skipzone/Illumicone/README.md

# Illumicone
Illumicone interactive LED art project

www.illumicone.com
