skipzone/Illumicone/hardware/4StringDriver/4StringDriver_board.png

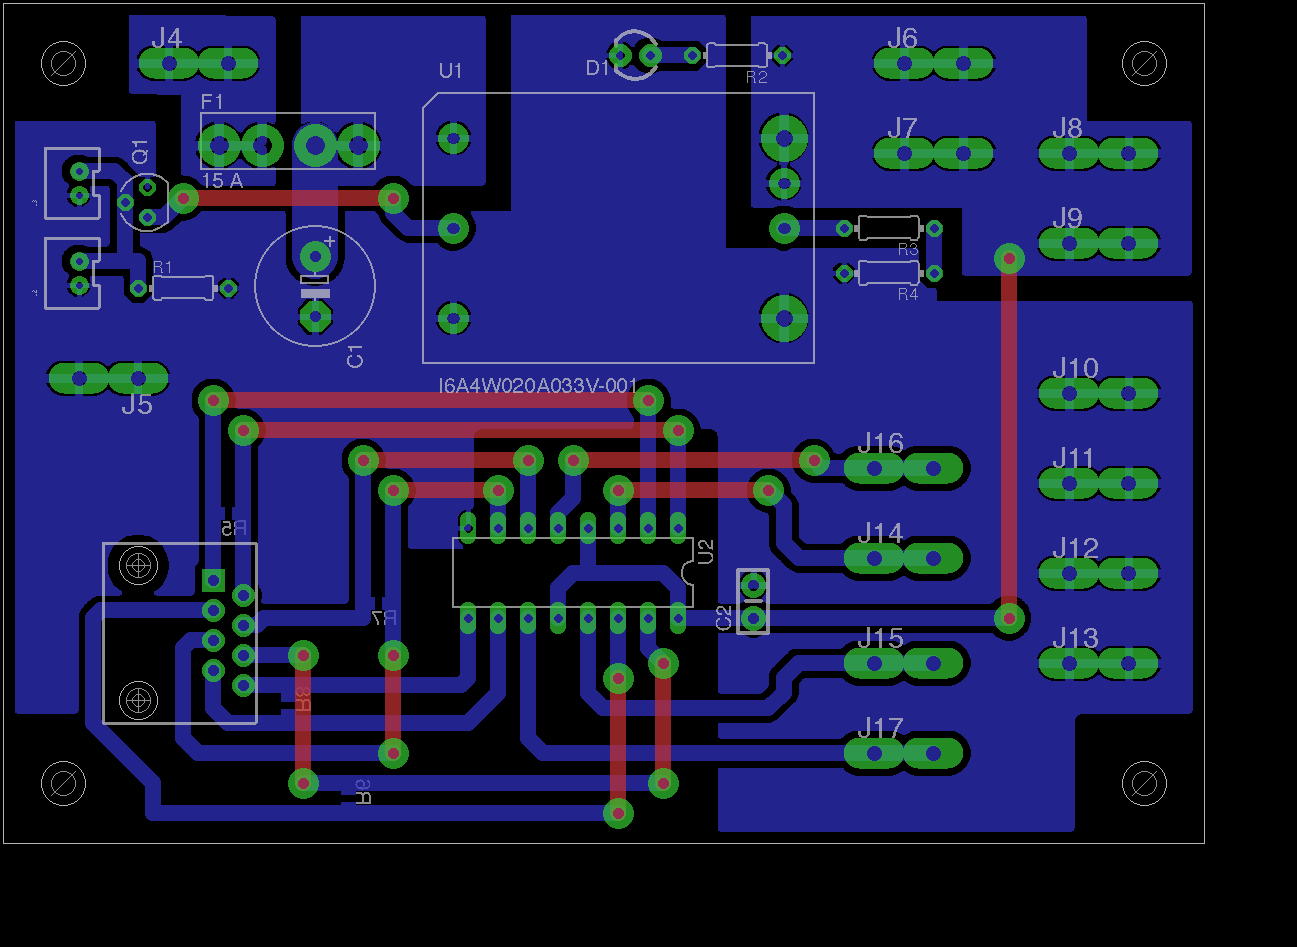
hardware/4StringDriver/4StringDriver_board.png
