skipzone/Illumicone/hardware/4StringDriver/4StringDriver_schematic.png

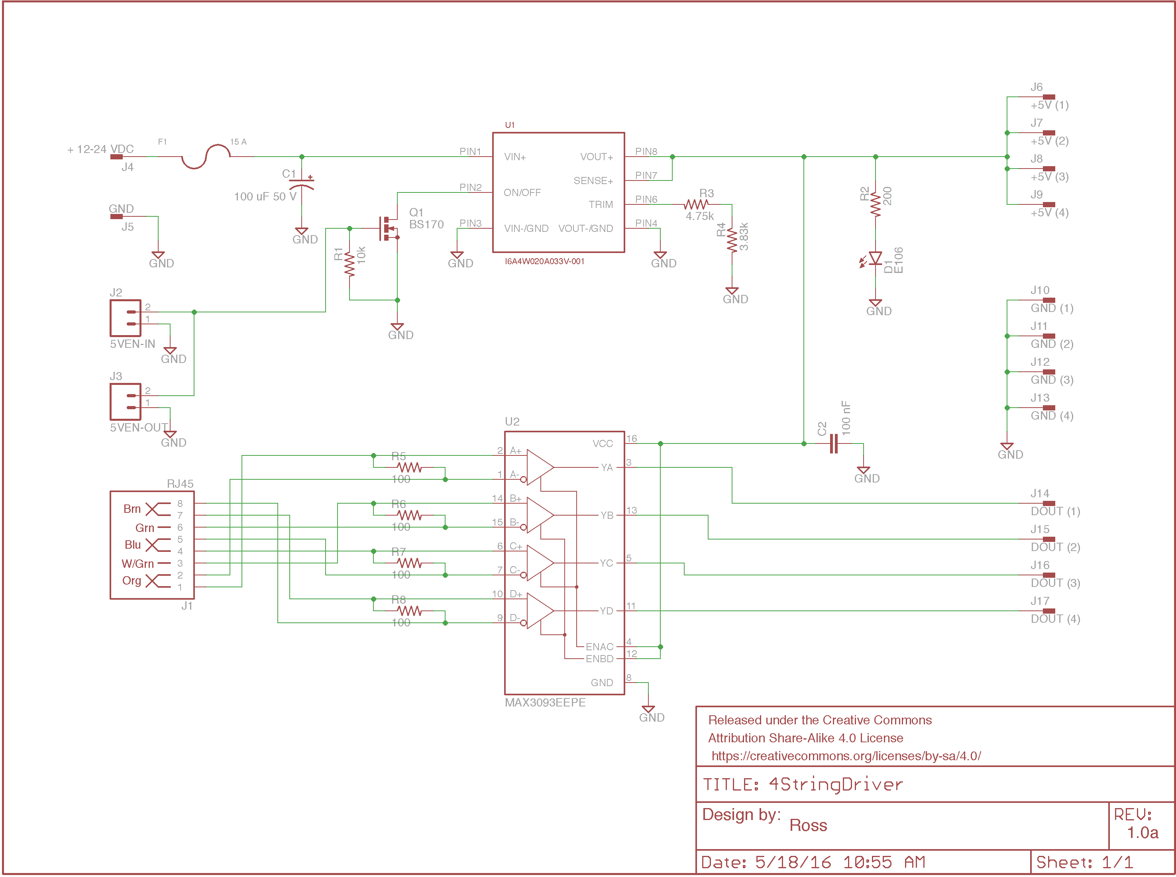
hardware/4StringDriver/4StringDriver_schematic.png
