skipzone/Illumicone/hardware/WidgetArduinoProMiniBreakout/WidgetArduinoProMiniBreakout - etch pattern.png

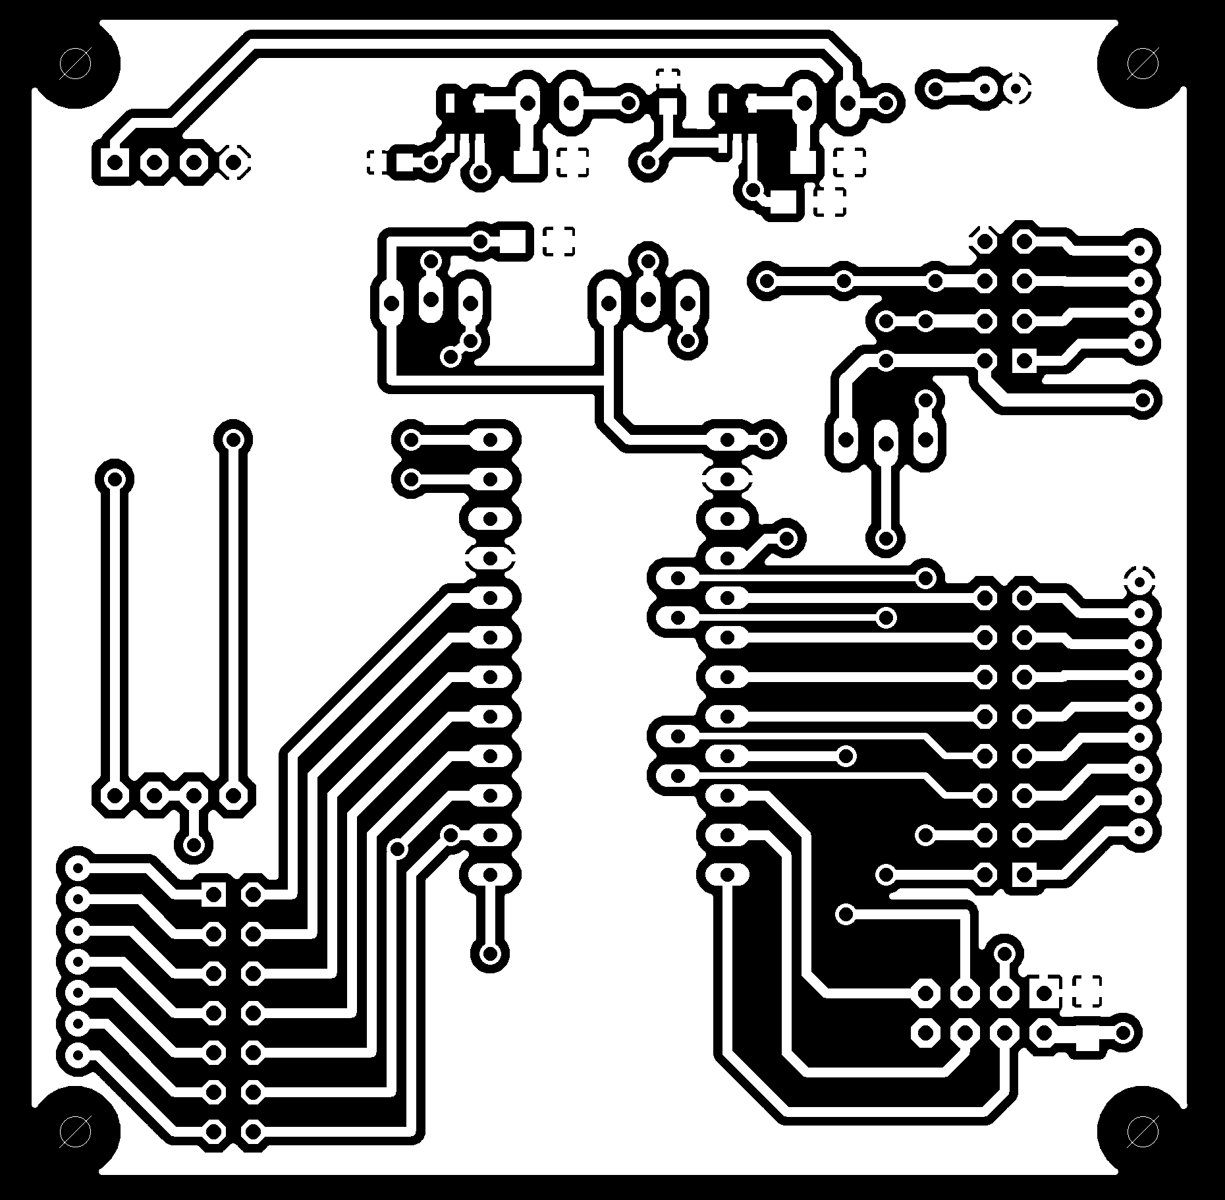
hardware/WidgetArduinoProMiniBreakout/WidgetArduinoProMiniBreakout - etch pattern.png
