skipzone/Illumicone/doc/Illumicone high-level architecture diagram.pdf

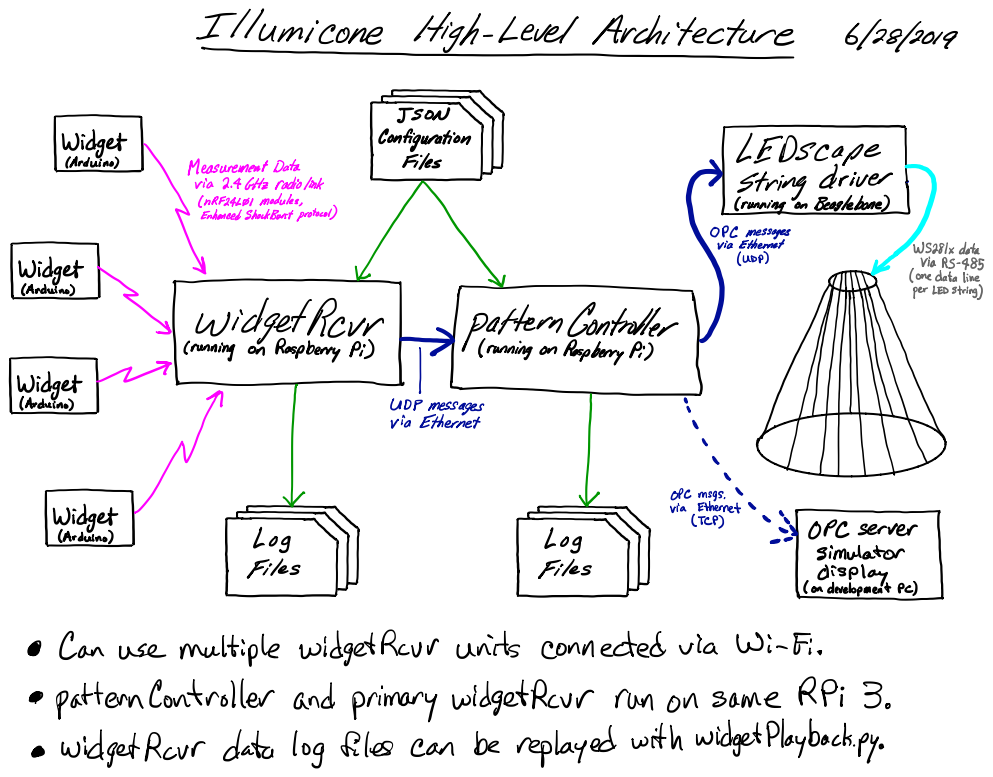
[picture p4: page 1]
' t o job; dos A; ¥÷*÷ / Eir: 3 EE; EEE; ooo; OEto I Is; oses s t; I Ets ¥.

Join J E I e or \ EEEE -
