skipzone/Illumicone/hardware/4StringDriver/4StringDriver_boardTopView.pdf

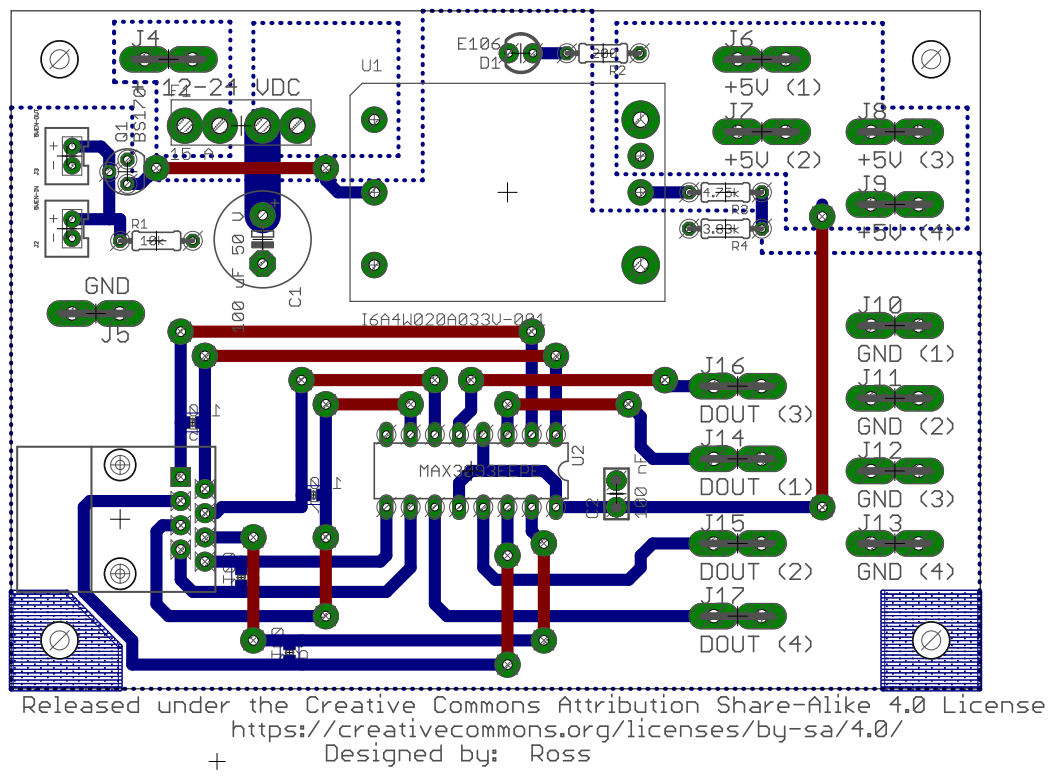
[picture p5: page 1]
