skipzone/Illumicone/hardware/4StringDriver/4StringDriver.pdf

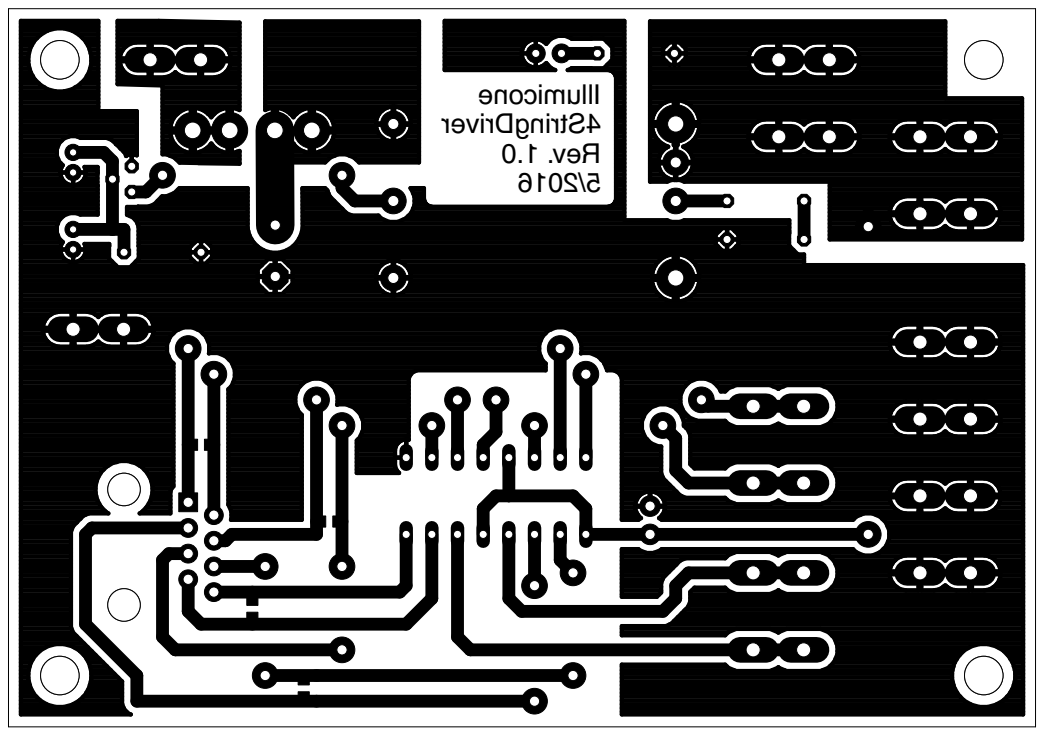
[picture p6: page 1]

enoci mullI r evir Dgnirt S4
