skipzone/Illumicone/hardware/WidgetArduinoProMiniBreakout/WidgetArduinoProMiniBreakout - bottom view.pdf

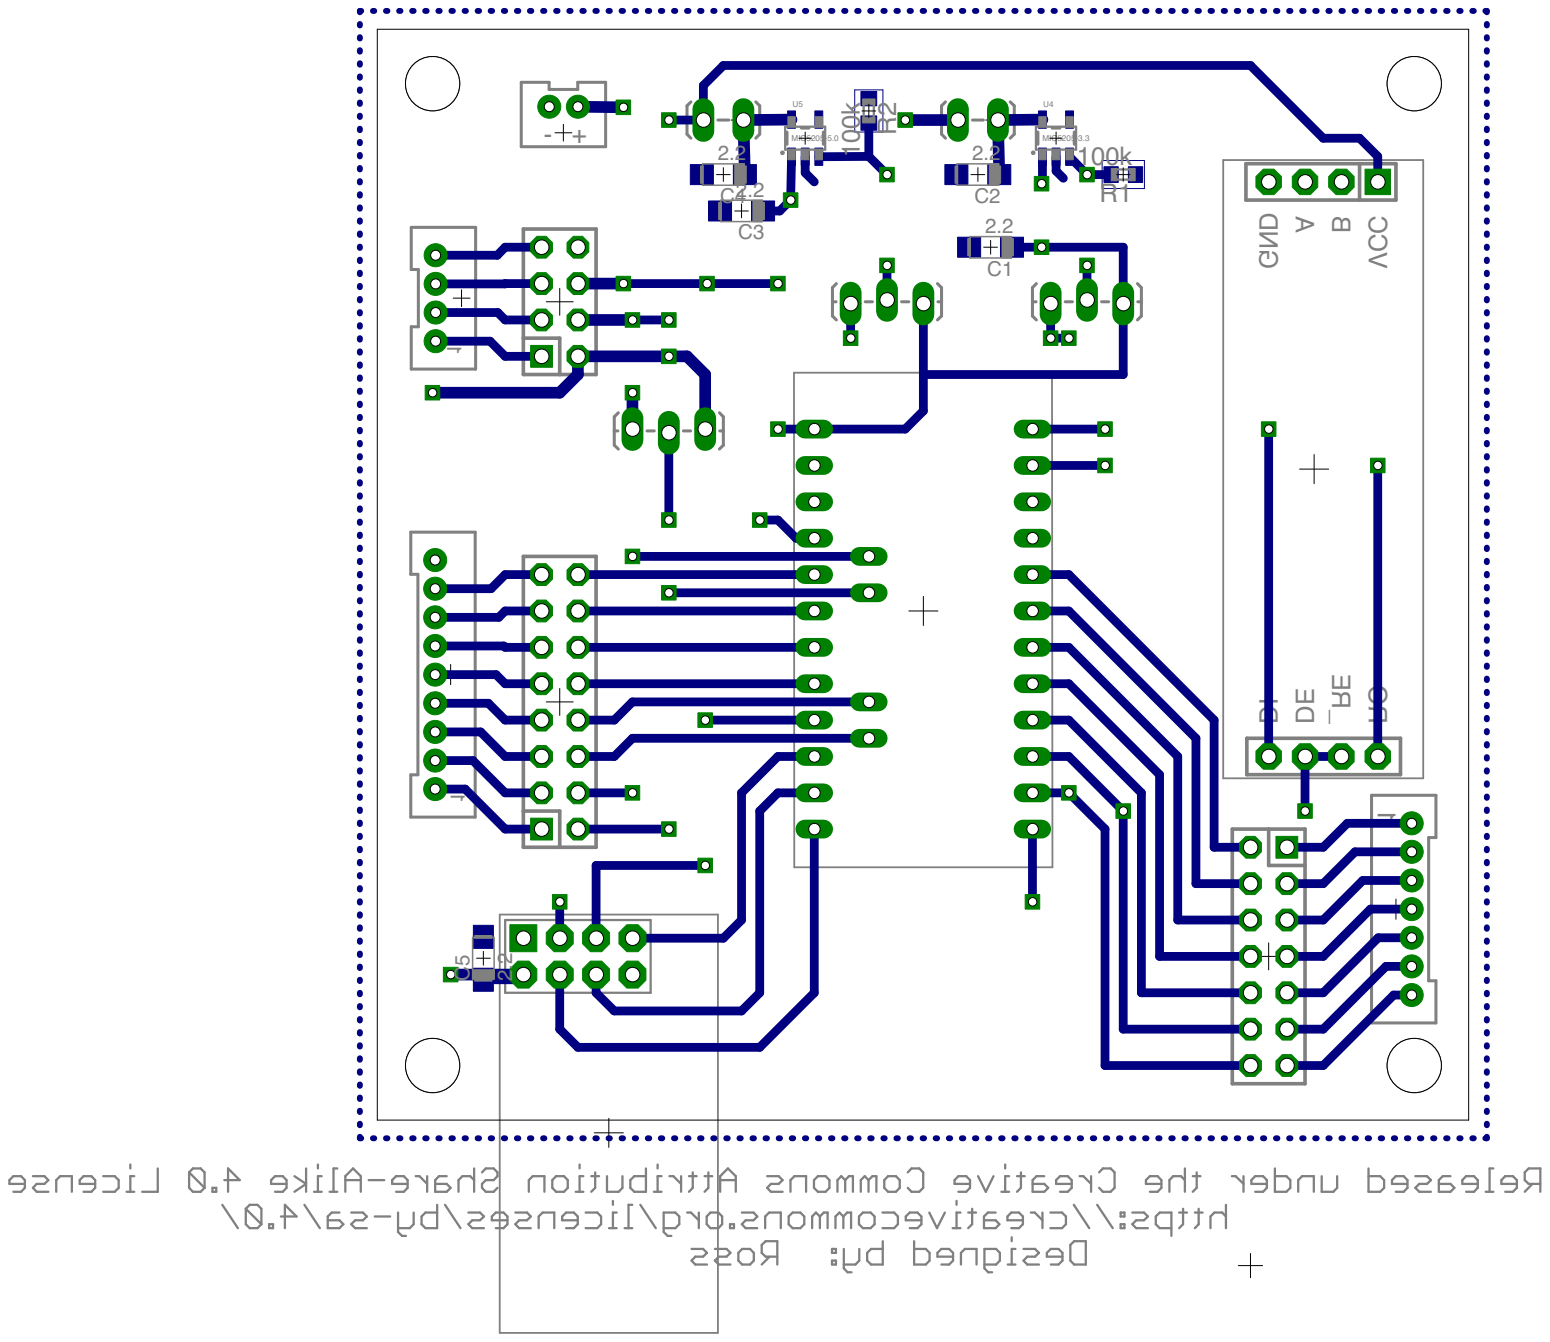
[picture p7: page 1]
