skipzone/Illumicone/hardware/WidgetArduinoProMiniBreakout/WidgetArduinoProMiniBreakout - configuration.pdf

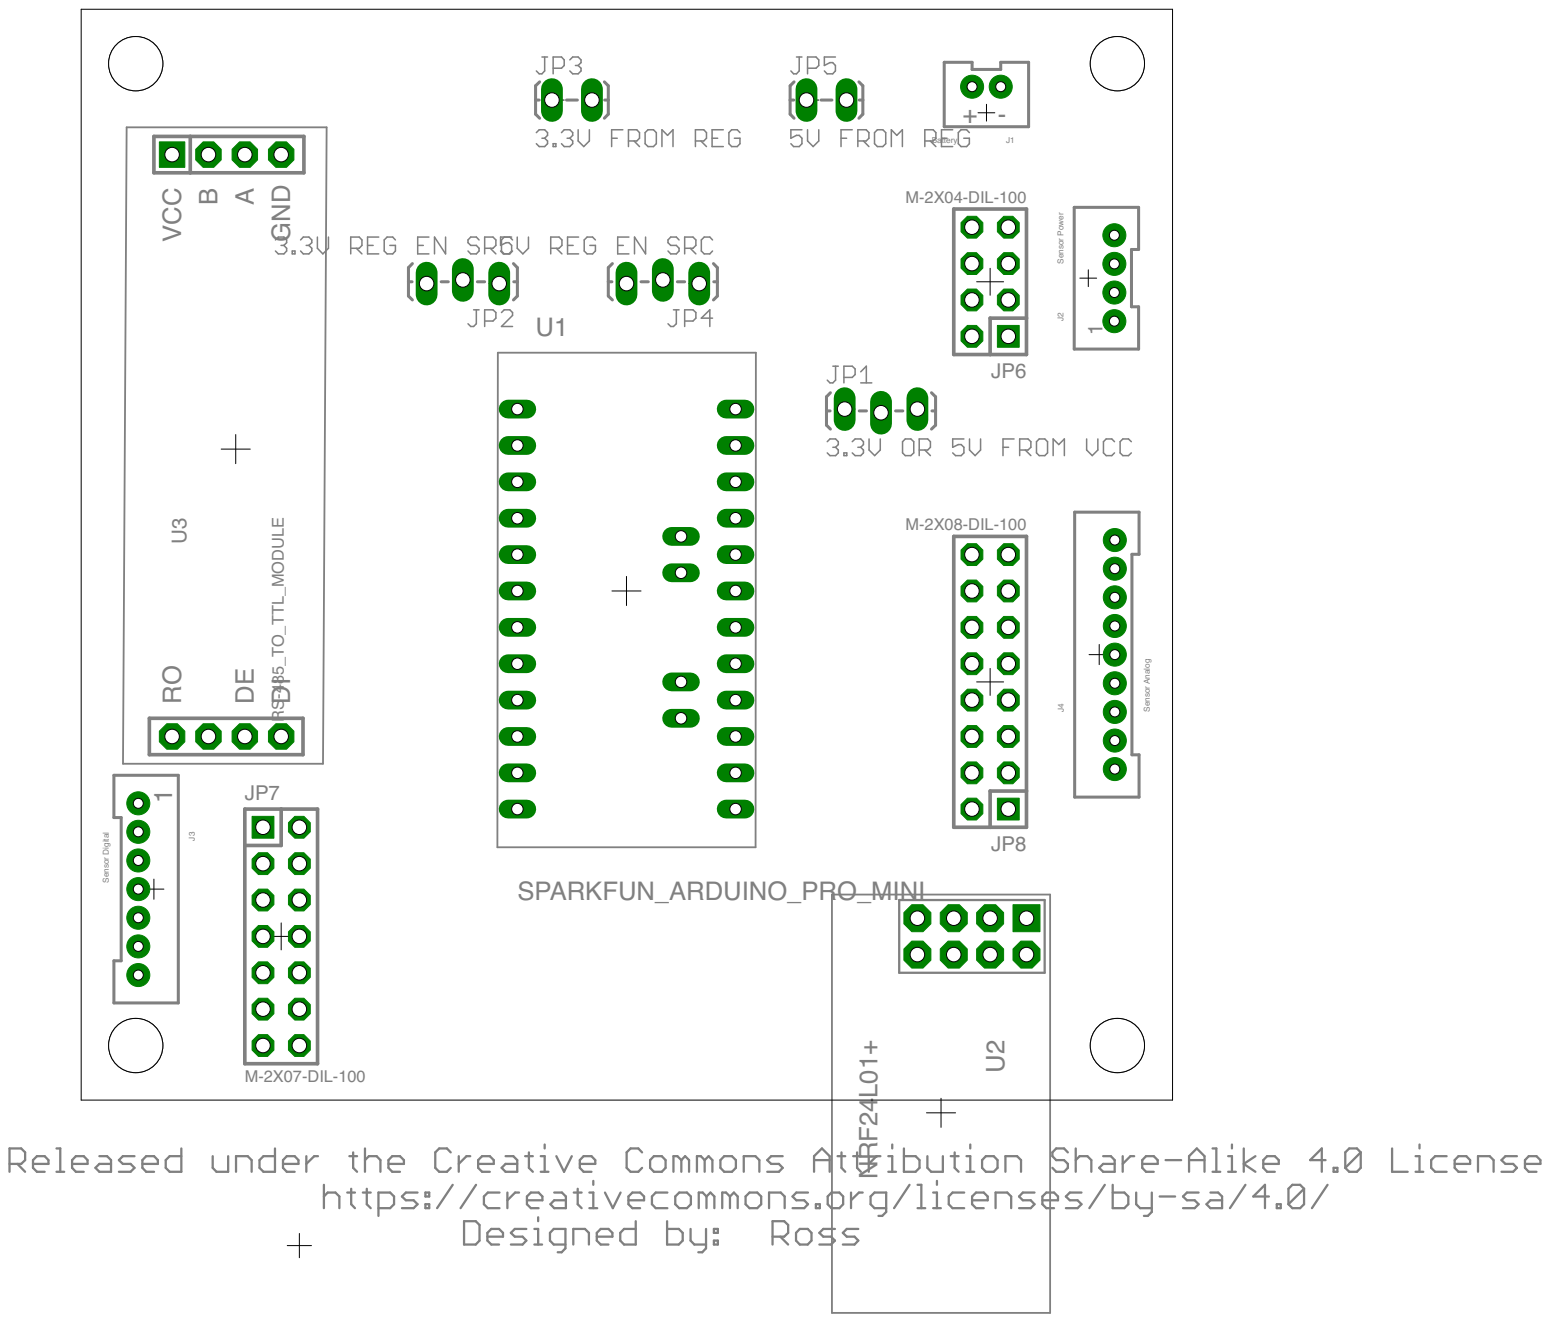
[picture p8: page 1]
