skipzone/Illumicone/hardware/WidgetArduinoProMiniBreakout/WidgetArduinoProMiniBreakout - jumper wires.pdf

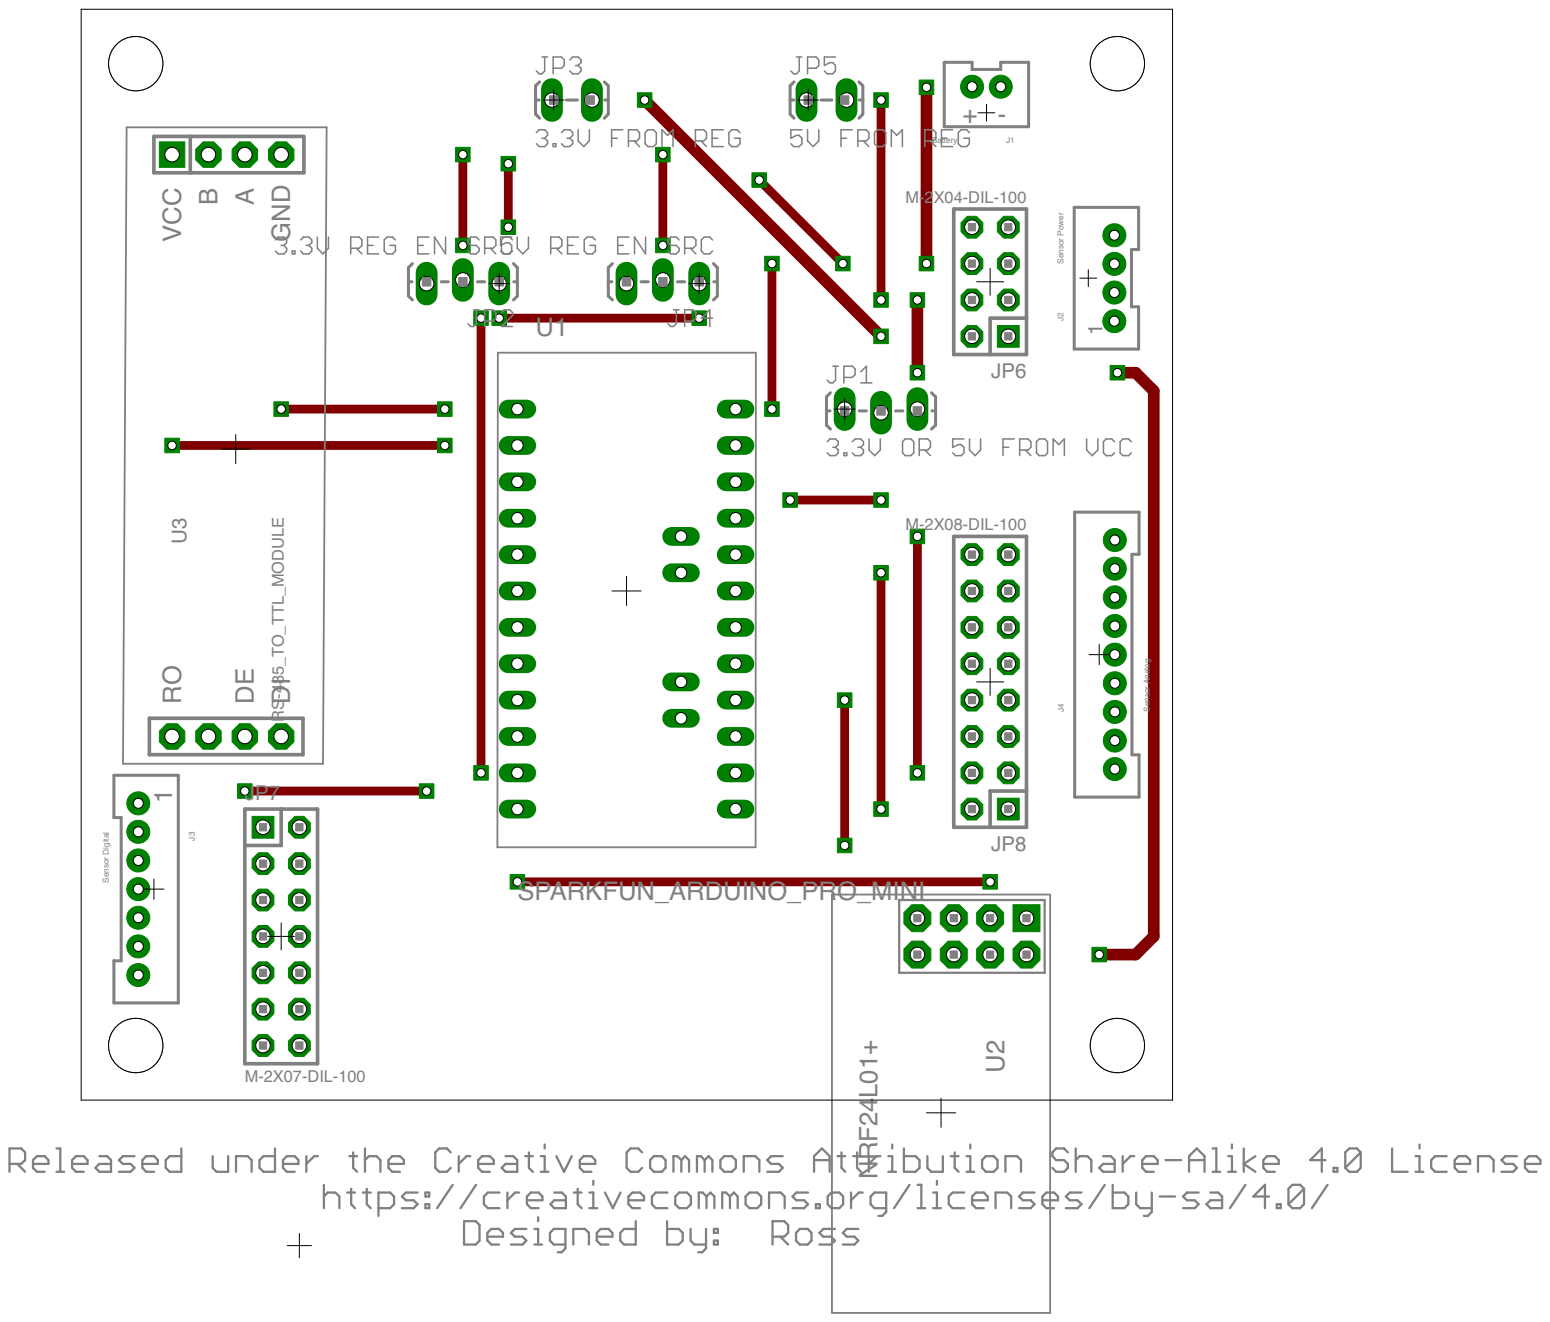
[picture p9: page 1]
