skipzone/Illumicone/hardware/WidgetArduinoProMiniBreakout/WidgetArduinoProMiniBreakout - vias and bottom components.pdf

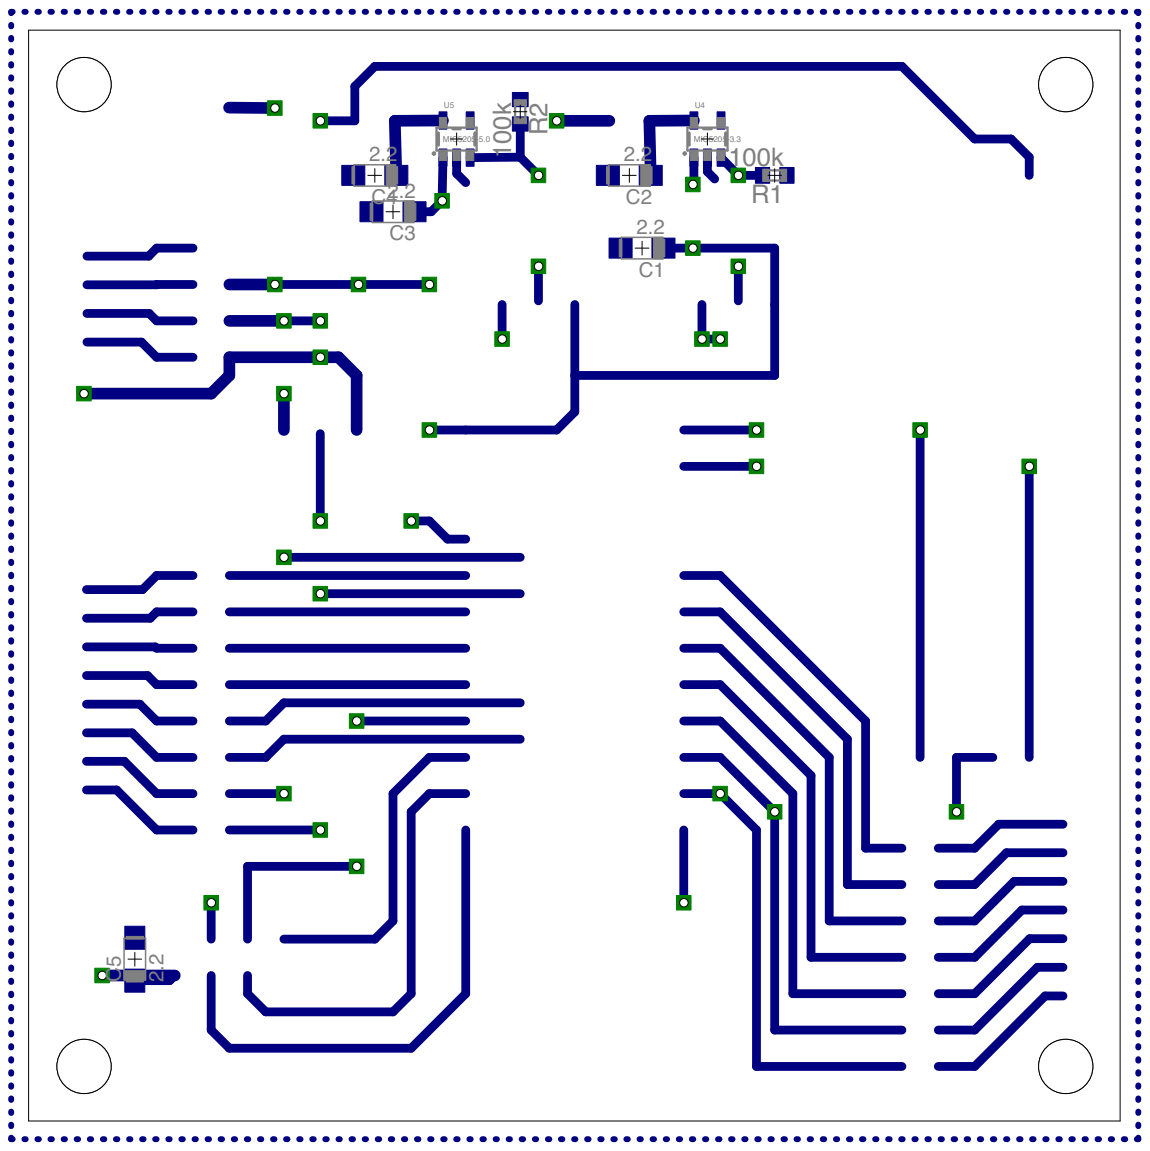
[picture p13: page 1]
