skipzone/Illumicone/doc/widgetActivityEERDiagram.pdf

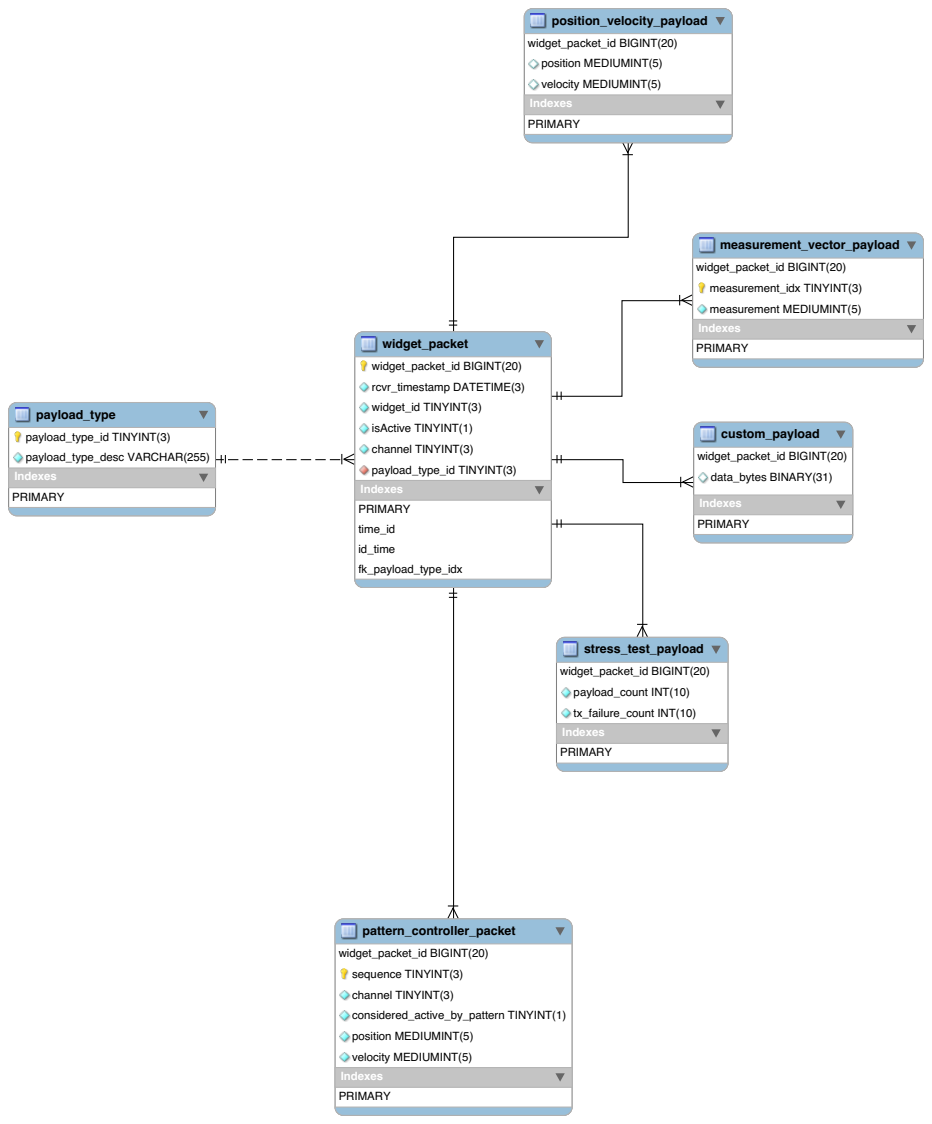
[picture p14: page 1]
custom_payload; widget_packet_id BIGINT(20); data_bytes BINARY(31); Indexes; PRIMARY; measurement_vector_payload; measurement_idx TINYINT(3); measurement MEDIUMINT(5); pattern_controller_packet; sequence TINYINT(3); channel TINYINT(3); considered_active_by_pattern TINYINT(1); position MEDIUMINT(5); velocity MEDIUMINT(5); payload_type; payload_type_id TINYINT(3); payload_type_desc VARCHAR(255); position_velocity_payload; stress_test_payload; payload_count INT(10); tx_failure_count INT(10)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
