skipzone/Illumicone/hardware/WidgetArduinoProMiniBreakout/WidgetArduinoProMiniBreakout.brd

## EAGLE design hardware/WidgetArduinoProMiniBreakout/WidgetArduinoProMiniBreakout.brd (2019-03-23)

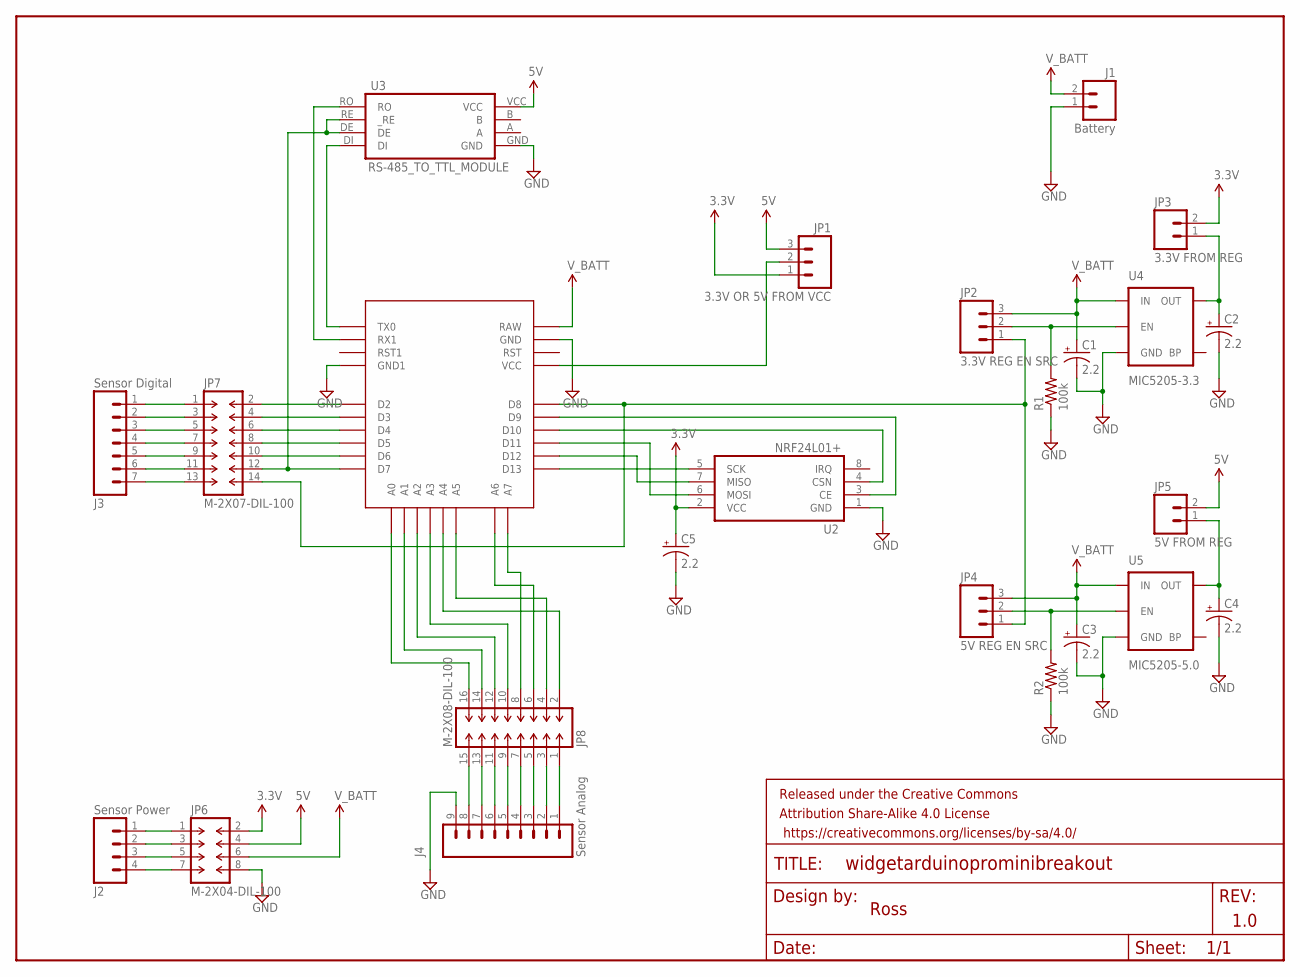
[picture p15: schematic WidgetArduinoProMiniBreakout.sch]

Parts:
C1, C2, C3, C4, C5: 2.2; SMC_A
FRAME1: FRAME-LETTER; CREATIVE_COMMONS
J1: Battery; JST-PH-2-TH-VERT
J2: Sensor Power; JST-PH-4-TH-VERT
J3: Sensor Digital; JST-PH-7-TH-VERT
J4: Sensor Analog; JST-PH-9-TH-VERT
JP1: 3.3V OR 5V FROM VCC; 1X03_LOCK_LONGPADS
JP2: 3.3V REG EN SRC; 1X03_LOCK_LONGPADS
JP3: 3.3V FROM REG; 1X02_LOCK_LONGPADS
JP4: 5V REG EN SRC; 1X03_LOCK_LONGPADS
JP5: 5V FROM REG; 1X02_LOCK_LONGPADS
JP6: M-2X04-DIL-100; DIL-100-2X04
JP7: M-2X07-DIL-100; DIL-100-2X07
JP8: M-2X08-DIL-100; DIL-100-2X08
R1, R2: 100k; R0603
U1: SPARKFUN_ARDUINO_PRO_MINI
U2: NRF24L01+; CHEAP_NRF24L01P_MODULE
U3: RS-485_TO_TTL_MODULE
U4: MIC5205-3.3; SOT23-5
U5: MIC5205-5.0; SOT23-5

Connections:
3.3V: C5.+, JP1.1, JP3.2, JP6.2, U2.2 (VCC)
5V: JP1.3, JP5.2, JP6.4, U3.VCC
A0: JP8.16, U1.A0
A0_J4: J4.8, JP8.15
A1: JP8.14, U1.A1
A1_J4: J4.7, JP8.13
A2: JP8.12, U1.A2
A2_J4: J4.6, JP8.11
A3: JP8.10, U1.A3
A3_J4: J4.5, JP8.9
A4_J4: J4.2, JP8.3
A5_J4: J4.1, JP8.1
A6: JP8.6, U1.A6
A6_J4: J4.4, JP8.7
A7: JP8.8, U1.A7
A7_J4: J4.3, JP8.5
D2: JP7.2, U1.D2
D2_J3: J3.1, JP7.1
D3: JP7.4, U1.D3
D3_J3: J3.2, JP7.3
D4: JP7.6, U1.D4
D4_J3: J3.3, JP7.5
D5: JP7.8, U1.D5
D5_J3: J3.4, JP7.7
D6: JP7.10, U1.D6
D6_J3: J3.5, JP7.9
D7: JP7.12, U1.D7, U3.DE, U3.RE (_RE)
D7_J3: J3.6, JP7.11
D8: JP2.1, JP4.1, JP7.14, U1.D8
D8_J3: J3.7, JP7.13
GND: C1.-, C2.-, C3.-, C4.-, C5.-, J1.1, J4.9, JP6.8, R1.1, R2.1, U1.GND, U1.GND1, U2.1 (GND), U3.GND, U4.2 (GND), U5.2 (GND)
unnamed: JP1.2, U1.VCC
unnamed: U1.D10, U2.4 (CSN)
unnamed: U1.TX0, U3.DI
unnamed: U1.D13, U2.5 (SCK)
unnamed: U1.D12, U2.7 (MISO)
unnamed: U1.D11, U2.6 (MOSI)
unnamed: U1.D9, U2.3 (CE)
unnamed: JP8.4, U1.A5
unnamed: JP2.2, R1.2, U4.3 (EN)
unnamed: C2.+, JP3.1, U4.5 (OUT)
unnamed: U1.RX1, U3.RO
unnamed: C4.+, JP5.1, U5.5 (OUT)
unnamed: JP4.2, R2.2, U5.3 (EN)
unnamed: JP8.2, U1.A4
unnamed: J2.1, JP6.1
unnamed: J2.2, JP6.3
unnamed: J2.3, JP6.5
unnamed: J2.4, JP6.7
V_BATT: C1.+, C3.+, J1.2, JP2.3, JP4.3, JP6.6, U1.RAW, U4.1 (IN), U5.1 (IN)

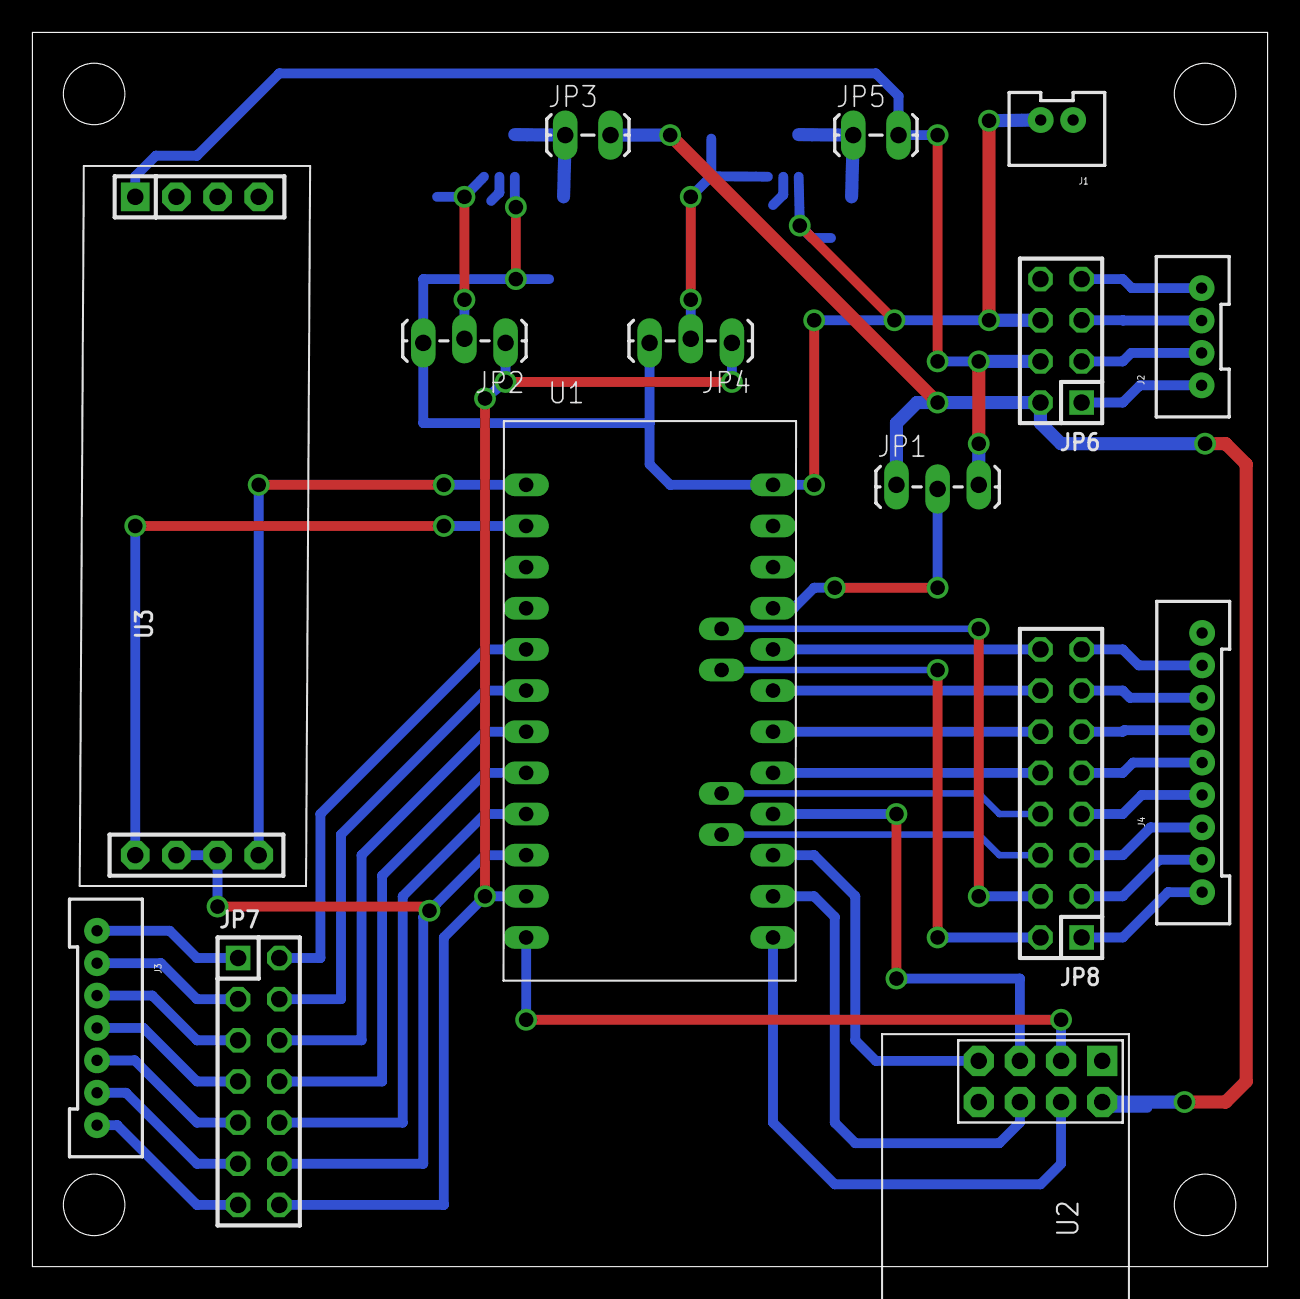
[picture p16: board WidgetArduinoProMiniBreakout.brd from above]

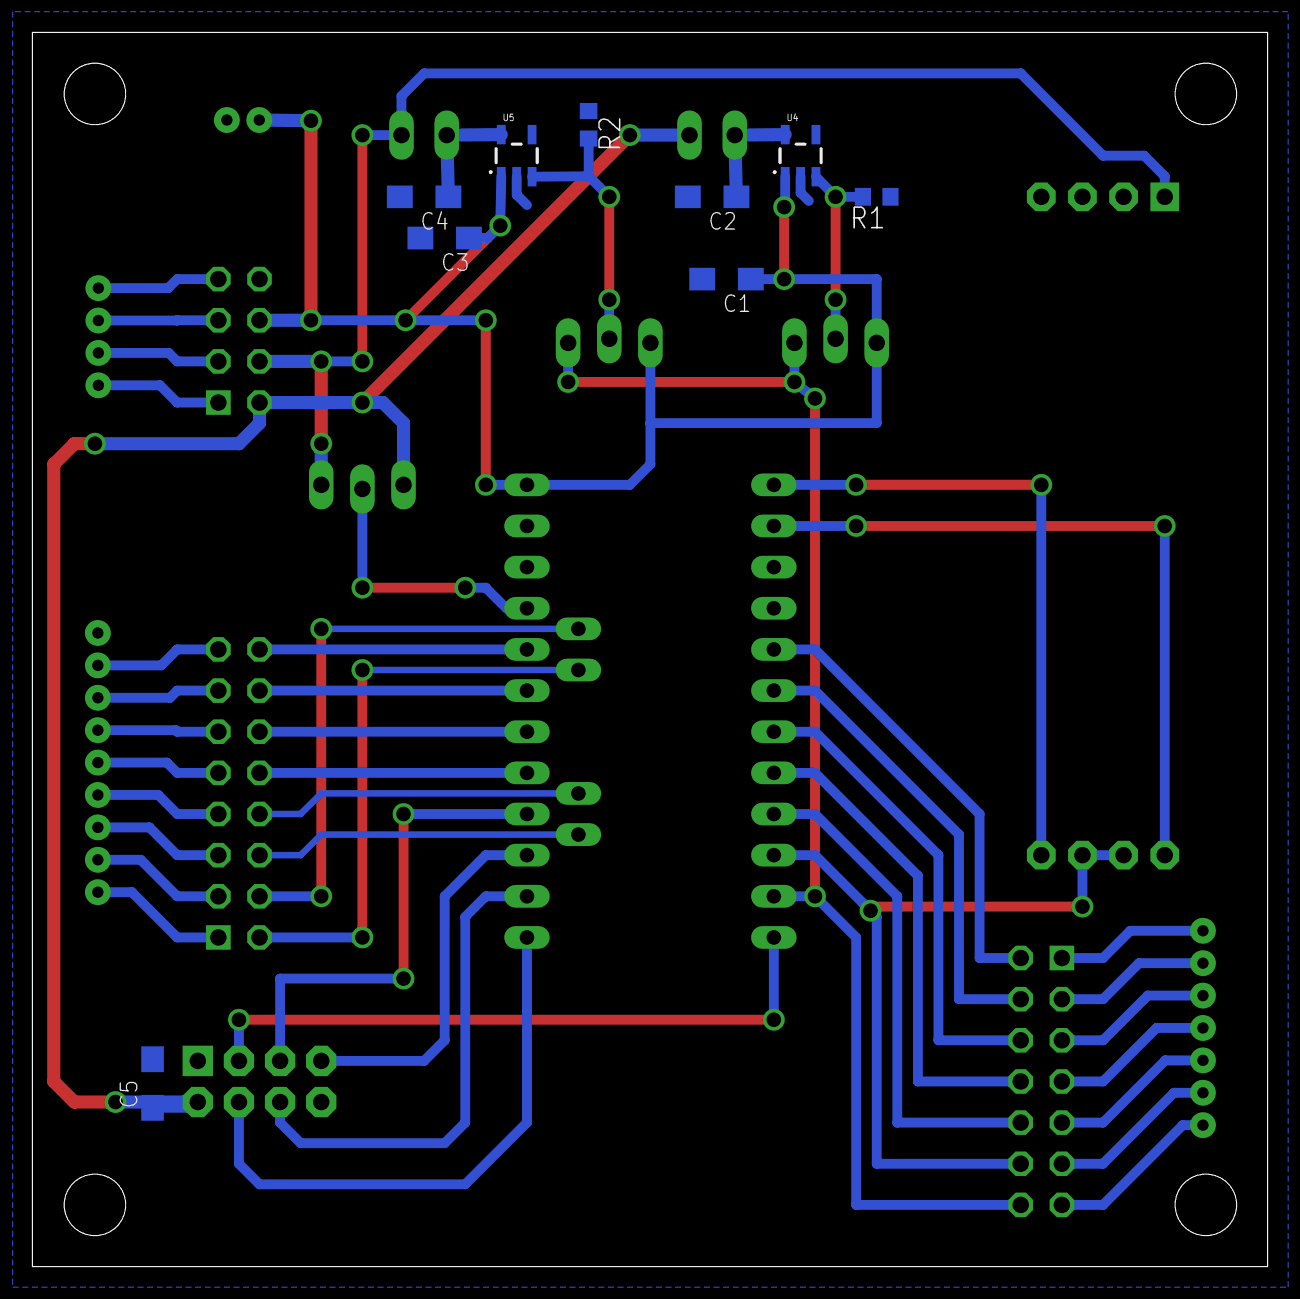
[picture p17: board WidgetArduinoProMiniBreakout.brd from below]

Board: 2 copper layers, 76.3 x 76.2 mm, 25 parts (9 on the bottom side), 50 nets.
