skipzone/Illumicone/hardware/4StringDriver/4StringDriver.brd

## EAGLE design hardware/4StringDriver/4StringDriver.brd (2019-03-23)

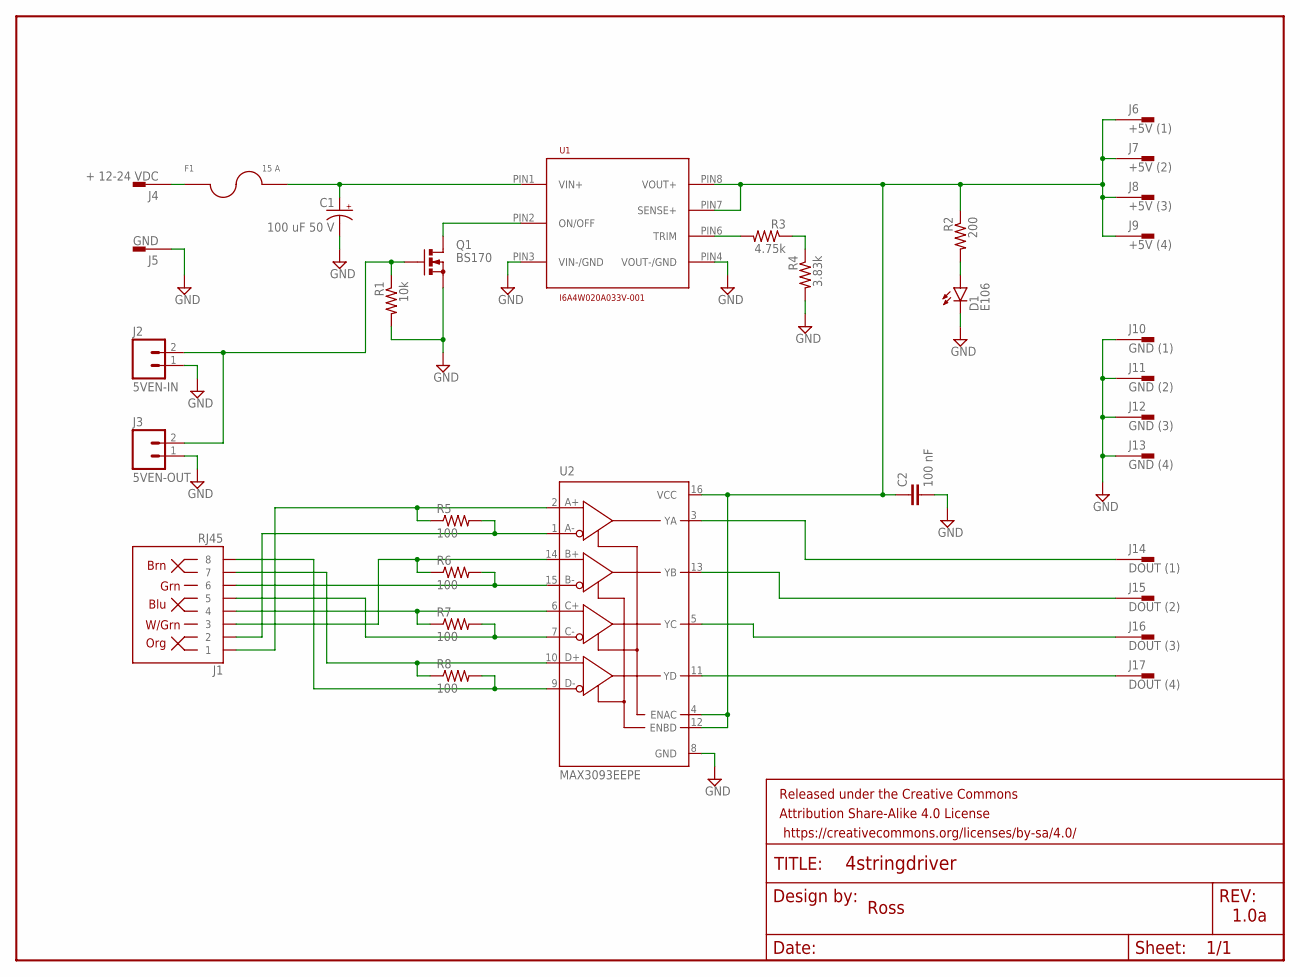
[picture p18: schematic 4StringDriver.sch]

Parts:
C1: 100 uF 50 V; E5-10,5
C2: 100 nF; CAP-PTH-SMALL-KIT
D1: E106; LED3MM
F1: 15 A; FUSE-ATM
FRAME1: FRAME-LETTER; CREATIVE_COMMONS
J1: RJ45; RJ45-8
J2: 5VEN-IN; JST-2-PTH-VERT
J3: 5VEN-OUT; JST-2-PTH-VERT
J4: + 12-24 VDC; F061.100
J5: GND; F061.100
J6: +5V (1); F061.100
J7: +5V (2); F061.100
J8: +5V (3); F061.100
J9: +5V (4); F061.100
J10: GND (1); F061.100
J11: GND (2); F061.100
J12: GND (3); F061.100
J13: GND (4); F061.100
J14: DOUT (1); F061.100
J15: DOUT (2); F061.100
J16: DOUT (3); F061.100
J17: DOUT (4); F061.100
Q1: BS170; SOT54E
R1: 10k; 0204/7
R2: 200; 0204/7
R3: 4.75k; 0204/7
R4: 3.83k; 0204/7
R5, R6, R7, R8: 100; R0603
U1: I6A4W020A033V-001; 16TH-BRICK-POWER-MODULE-NO-OPTIONS
U2: MAX3093EEPE; DIL16

Connections:
5VEN: J2.2, J3.2, Q1.G, R1.1
+5V: C2.1, J6.A1, J6.A2, J7.A1, J7.A2, J8.A1, J8.A2, J9.A1, J9.A2, R2.1, U1.PIN7 (SENSE+), U1.PIN8 (VOUT+), U2.4 (ENAC), U2.12 (ENBD), U2.16 (VCC)
DA+: J1.1, R5.1, U2.2 (A+)
DA-: J1.2, R5.2, U2.1 (A-)
DB+: J1.3, R6.1, U2.14 (B+)
DB-: J1.6, R6.2, U2.15 (B-)
DC+: J1.4, R7.1, U2.6 (C+)
DC-: J1.5, R7.2, U2.7 (C-)
DD+: J1.7, R8.1, U2.10 (D+)
DD-: J1.8, R8.2, U2.9 (D-)
DOUT1: J14.A1, J14.A2, U2.3 (YA)
DOUT2: J15.A1, J15.A2, U2.13 (YB)
DOUT3: J16.A1, J16.A2, U2.5 (YC)
DOUT4: J17.A1, J17.A2, U2.11 (YD)
GND: C1.-, C2.2, D1.K (C), J2.1, J3.1, J5.A1, J5.A2, J10.A1, J10.A2, J11.A1, J11.A2, J12.A1, J12.A2, J13.A1, J13.A2, Q1.S, R1.2, R4.2, U1.PIN3 (VIN-/GND), U1.PIN4 (VOUT-/GND), U2.8 (GND)
unnamed: Q1.D, U1.PIN2 (ON/OFF)
unnamed: D1.A, R2.2
unnamed: R3.2, U1.PIN6 (TRIM)
unnamed: R3.1, R4.1
VIN+: F1.PAD1 (1), F1.PAD2 (1), J4.A1, J4.A2
VIN+FUSED: C1.+, F1.PAD3 (2), F1.PAD4 (2), U1.PIN1 (VIN+)

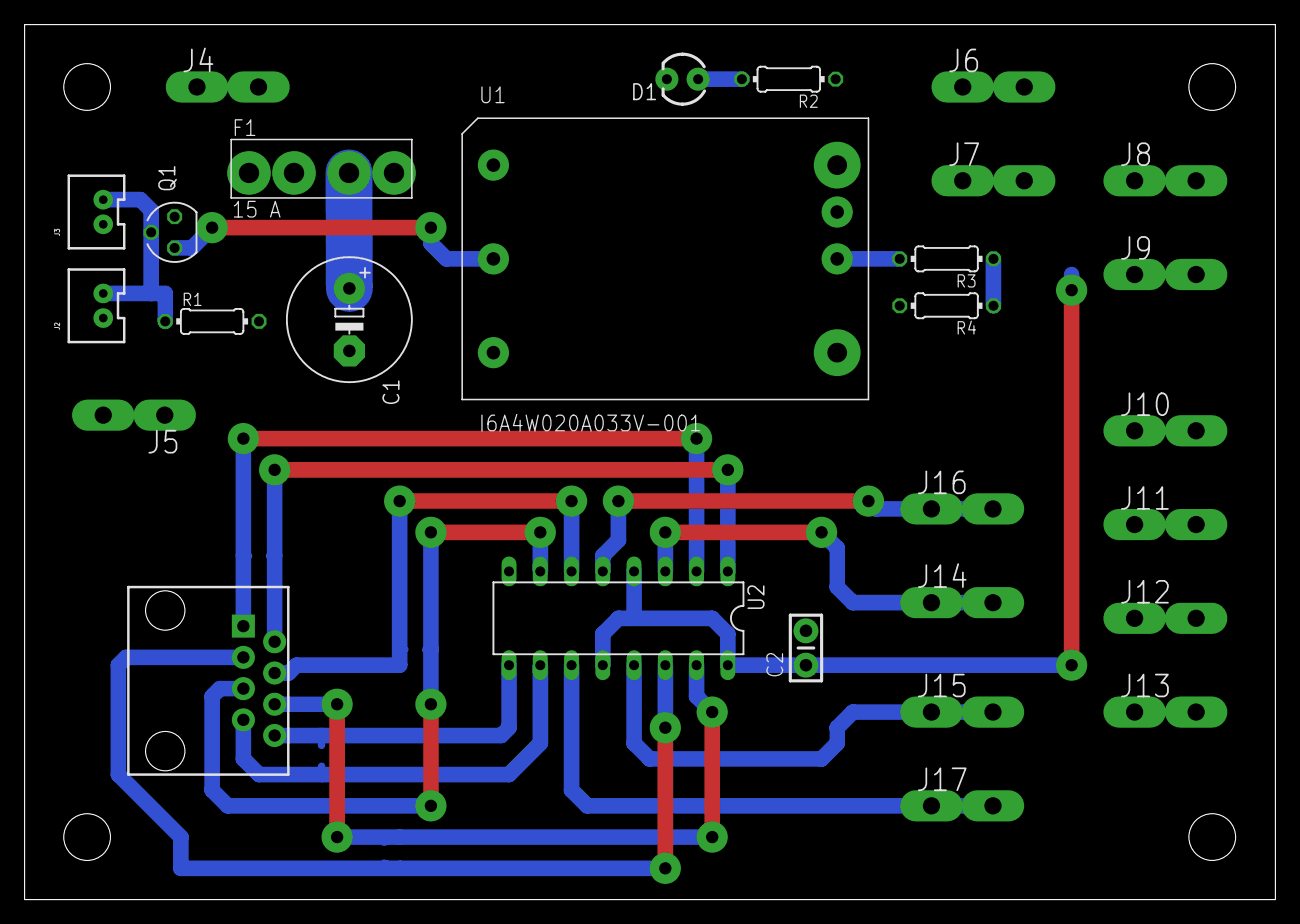
[picture p19: board 4StringDriver.brd from above]

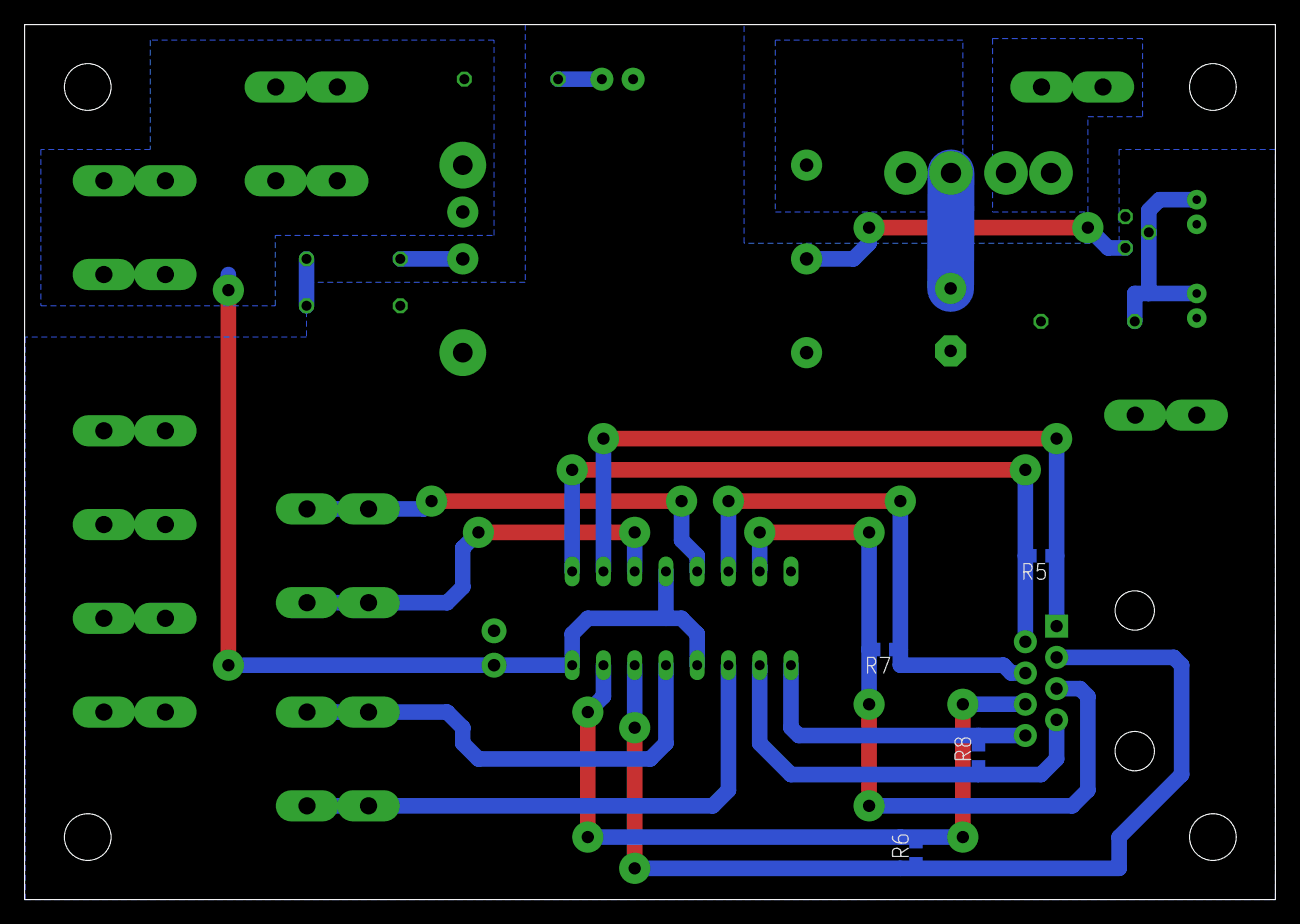
[picture p20: board 4StringDriver.brd from below]

Board: 2 copper layers, 101.7 x 71.1 mm, 33 parts (4 on the bottom side), 21 nets.
