skipzone/Illumicone/include/ConfigReader.h

/*
    This file is part of Illumicone.

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
    You should have received a copy of the GNU General Public License
    along with Illumicone.  If not, see <http://www.gnu.org/licenses/>.
*/

#pragma once

#include <climits>
#include <limits>
#include <string>
#include <vector>

#include "illumiconePixelTypes.h"
#include "illumiconeTypes.h"
#include "json11.hpp"
#include "pixeltypes.h"
#include "WidgetId.h"


class ConfigReader
{
    public:

        static bool getBoolValue(const json11::Json& jsonObj,
                                 const std::string& name,
                                 bool& value,
                                 const std::string& errorMessageSuffix = "");

        static bool getDoubleValue(const json11::Json& jsonObj,
                                   const std::string& name,
                                   double& value,
                                   const std::string& errorMessageSuffix = "",
                                   double minValue = std::numeric_limits<double>::lowest(),
                                   double maxValue = std::numeric_limits<double>::max());

        static bool getFloatValue(const json11::Json& jsonObj,
                                  const std::string& name,
                                  float& value,
                                  const std::string& errorMessageSuffix = "",
                                  float minValue = std::numeric_limits<float>::lowest(),
                                  float maxValue = std::numeric_limits<float>::max());

        static bool getHsvPixelValue(const json11::Json& jsonObj,
                                     const std::string& name,
                                     std::string& hsvStr,
                                     HsvPixel& value,
                                     const std::string& errorMessageSuffix = "",
                                     bool allowEmptyString = false,
                                     const HsvPixel& defaultValue = HsvPixel(0, 0, 0));

        static bool getJsonObject(const json11::Json& jsonObj,
                                  const std::string& name,
                                  json11::Json& value,
                                  const std::string& errorMessageSuffix = "");

        static bool getIntValue(const json11::Json& jsonObj,
                                const std::string& name,
                                int& value,
                                const std::string& errorMessageSuffix = "",
                                int minValue = INT_MIN,
                                int maxValue = INT_MAX);

        static bool getRgbPixelValue(const json11::Json& jsonObj,
                                     const std::string& name,
                                     std::string& rgbStr,
                                     RgbPixel& value,
                                     const std::string& errorMessageSuffix = "",
                                     bool allowEmptyString = false,
                                     const RgbPixel& defaultValue = CRGB::Black);

        static bool getSchedulePeriods(const json11::Json& jsonObj,
                                       const std::string& scheduleName,
                                       std::vector<SchedulePeriod>& schedulePeriods);

        static bool getStringValue(const json11::Json& jsonObj,
                                   const std::string& name,
                                   std::string& value,
                                   const std::string& errorMessageSuffix = "",
                                   bool allowEmptyString = false);

        static bool getUnsignedIntValue(const json11::Json& jsonObj,
                                        const std::string& name,
                                        unsigned int& value,
                                        const std::string& errorMessageSuffix = "",
                                        unsigned int minValue = 0,
                                        unsigned int maxValue = UINT_MAX);

        static json11::Json mergeConfigObjects(const json11::Json& primaryJsonObj, const json11::Json& secondaryJsonObj);


        ConfigReader();
        virtual ~ConfigReader();

        ConfigReader(const ConfigReader&) = delete;
        ConfigReader& operator =(const ConfigReader&) = delete;

        std::string dumpToString();
        std::string getConfigFilePath();
        std::string getConfigFilePathName();
        json11::Json getConfigObject();
        json11::Json getPatternConfigJsonObject(const std::string& patternName);
        json11::Json getWidgetConfigJsonObject(const std::string& widgetName);
        bool loadConfiguration(const std::string& configFilePathName);
        
    private:

        bool readConfigurationFile(const std::string& fileName, json11::Json& configObj);
        json11::Json resolveObjectIncludes(const json11::Json& obj, unsigned int curLevel);

        std::string loadedConfigFilePath;
        std::string loadedConfigFilePathName;
        json11::Json loadedConfigObj;

};
