skipzone/Illumicone/Arduino/Widget_MPU6050/Widget_MPU6050.ino

/*****************************************************************
 *                                                               *
 * MPU-6050 IMU Plus Sound Widget                                *
 *                                                               *
 * Platform:  Arduino Uno, Pro, Pro Mini                         *
 *                                                               *
 * by Ross Butler, November 2018                             )'( *
 *                                                               *
 *****************************************************************/

/*
    This file is part of Illumicone.

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
    You should have received a copy of the GNU General Public License
    along with Illumicone.  If not, see <http://www.gnu.org/licenses/>.
*/


//#define ENABLE_DEBUG_PRINT
// An LCD display can be used for sensor evaluation and testing.
//#define ENABLE_LCD_16x2
//#define ENABLE_LCD_20x4   // TODO:  not supported yet

#if defined(ENABLE_LCD_16x2) || defined(ENABLE_LCD_20x4)
  #define ENABLE_LCD
#endif


/**********************************************
 * This program is used for multiple widgets. *
 * A specific target widget is selected here. *
 **********************************************/

//#define BATRAT1
//#define BATRAT2
//#define BATRAT3
//#define BATRAT4
#define BATRAT5
//#define BOOGIEBOARD
//#define FLOWER1
//#define FLOWER2
//#define FLOWER3
//#define FLOWER4
//#define FLOWER5
//#define FLOWER6
//#define FLOWER7
//#define IBG_TILT_1
//#define IBG_TILT_2
//#define IBG_TILT_TEST
//#define RAINSTICK

#if defined(BATRAT1) || defined(BATRAT2)|| defined(BATRAT3) || defined(BATRAT4) || defined(BATRAT5)
  #define BATRAT
#endif

#if defined(FLOWER1) || defined(FLOWER2) || defined(FLOWER3) || defined(FLOWER4) || \
    defined(FLOWER5) || defined(FLOWER6) || defined(FLOWER7)
  #define FLOWER
#endif



/************
 * Includes *
 ************/

#include <avr/sleep.h>
#include <avr/wdt.h>

#include "I2Cdev.h"

#include "illumiconeWidget.h"

#include "MPU6050_6Axis_MotionApps20.h"

#ifdef ENABLE_DEBUG_PRINT
#include "printf.h"
#endif

// Arduino Wire library is required if I2Cdev I2CDEV_ARDUINO_WIRE implementation
// is used in I2Cdev.h
#if I2CDEV_IMPLEMENTATION == I2CDEV_ARDUINO_WIRE
    #include "Wire.h"
#endif

#ifdef ENABLE_LCD
#include <LiquidCrystal.h>
#endif


/****************************
 * Constants and Data Types *
 ****************************/

enum class Mpu6050Mode {
  init,
  cycle,
  normal
};

enum class WidgetMode {
  init,
  standby,
  inactive,
  active
};


/**************************************************
 * Baton and Rattle (BatRat) Widget Configuration *
 **************************************************/

#ifdef BATRAT

#if defined(BATRAT1)
  #define WIDGET_ID 21
#elif defined(BATRAT2)
  #define WIDGET_ID 22
#elif defined(BATRAT3)
  #define WIDGET_ID 23
#elif defined(BATRAT4)
  #define WIDGET_ID 24
#elif defined(BATRAT5)
  #define WIDGET_ID 25
#else
  #error No widget id defined for this batrat.
#endif

#define ENABLE_SYSTEM_RESET_WATCHDOG

static constexpr bool skipDeviceIdCheck = false;

#define ACTIVATE_WITH_MOVEMENT

static constexpr int16_t movementDetectionThreshold = 10;               // widget is active if gyro rotational speed > threshold
static constexpr uint32_t inactiveTransitionDelayMs = 5000;             // delay between inactivity detection and going inactive

static constexpr uint8_t mpu6050MotionDetectionThreshold = 1;           // unit is 2 mg
static constexpr uint8_t mpu6050MotionDetectionCounterDecrement = 1;
static constexpr uint8_t mpu6050MotionDetectionDuration = 1;            // unit is ms
static constexpr uint8_t mpu6050WakeFrequency = 0;                      // 0 = 1.25 Hz, 1 = 2.5 Hz, 2 - 5 Hz, 3 = 10 Hz

#define TEMPERATURE_SAMPLE_INTERVAL_MS 1000L

// Stagger the transmissions to avoid repeated collisions.
#if defined(BATRAT1)
  #define ACTIVE_TX_INTERVAL_MS 81L
  #define INACTIVE_TX_INTERVAL_MS 2001L
#elif defined(BATRAT2)
  #define ACTIVE_TX_INTERVAL_MS 83L
  #define INACTIVE_TX_INTERVAL_MS 2003L
#elif defined(BATRAT3)
  #define ACTIVE_TX_INTERVAL_MS 85L
  #define INACTIVE_TX_INTERVAL_MS 2005L
#elif defined(BATRAT4)
  #define ACTIVE_TX_INTERVAL_MS 87L
  #define INACTIVE_TX_INTERVAL_MS 2007L
#elif defined(BATRAT5)
  #define ACTIVE_TX_INTERVAL_MS 89L
  #define INACTIVE_TX_INTERVAL_MS 2009L
#else
  #error No tx intervals defined for this batrat.
#endif

// In standby mode, we'll transmit a packet with zero-valued data approximately
// every STANDBY_TX_INTERVAL_S seconds.  Wake-ups occur at 8-second intervals, so
// STANDBY_TX_INTERVAL_S should be a multiple of 8 between 8 and 2040, inclusive.
#define STANDBY_TX_INTERVAL_S 64

// The MPU-6050 is placed in cycle mode, and the processor is put to sleep
// when movement hasn't been detected for MOVEMENT_TIMEOUT_FOR_SLEEP_MS ms.
#define MOVEMENT_TIMEOUT_FOR_SLEEP_MS 60000L

// We use the time elapsed since getting good data from the MPU-6050 to determine
// if we need to reinitialize the little bastard because he's quit working right.
// MPU6050_ASSUMED_DEAD_TIMEOUT_MS must be less than MOVEMENT_TIMEOUT_FOR_SLEEP_MS
// so that we re-init the MPU-6050 rather than putting it in cycle mode when we're
// not getting good data from it.
///#define MPU6050_ASSUMED_DEAD_TIMEOUT_MS 3000

//#define TX_INDICATOR_LED_PIN 16
//#define TX_INDICATOR_LED_ON HIGH
//#define TX_INDICATOR_LED_OFF LOW
//#define IMU_NORMAL_INDICATOR_LED_PIN 16
//#define IMU_NORMAL_INDICATOR_LED_ON HIGH
//#define IMU_NORMAL_INDICATOR_LED_OFF LOW
#define IMU_INTERRUPT_PIN 2
#define VIBRATION_SENSOR_PIN 3
#define IMU_POWER_PIN 4
#define RADIO_CE_PIN 9
#define RADIO_CSN_PIN 10
// The radio uses the SPI bus, so it also uses SCK on 13, MISO on 12, and MOSI on 11.

// moving average length for averaging IMU measurements
#define MA_LENGTH 20

static constexpr uint8_t maSlotYaw = 0;
static constexpr uint8_t maSlotPitch = 1;
static constexpr uint8_t maSlotRoll = 2;
static constexpr uint8_t maSlotGyroX = 3;
static constexpr uint8_t maSlotGyroY = 4;
static constexpr uint8_t maSlotGyroZ = 5;
static constexpr uint8_t maSlotAccelX = 6;
static constexpr uint8_t maSlotAccelY = 7;
static constexpr uint8_t maSlotAccelZ = 8;
static constexpr uint8_t maSlotLinearAccelX = 9;
static constexpr uint8_t maSlotLinearAccelY = 10;
static constexpr uint8_t maSlotLinearAccelZ = 11;
static constexpr uint8_t maSlotTemperature = 12;

static constexpr uint8_t numMaSets = 13;

#define INCLUDE_ACCEL_DATA
#define INCLUDE_LINEAR_ACCEL_DATA

// ---------- radio configuration ----------

// Nwdgt, where N indicates the payload type (0: stress test; 1: position
// and velocity; 2: measurement vector; 3,4: undefined; 5: custom)
#define TX_PIPE_ADDRESS "2wdgt"

// Set WANT_ACK to false, TX_RETRY_DELAY_MULTIPLIER to 0, and TX_MAX_RETRIES
// to 0 for fire-and-forget.  To enable retries and delivery failure detection,
// set WANT_ACK to true.  The delay between retries is 250 us multiplied by
// TX_RETRY_DELAY_MULTIPLIER.  To help prevent repeated collisions, use 1, a
// prime number (2, 3, 5, 7, 11, 13), or 15 (the maximum) for the multiplier.
// TX_MAX_RETRIES is usually set to 15 when retries are enabled.
#define WANT_ACK true
#if defined(BATRAT1)
  #define TX_RETRY_DELAY_MULTIPLIER 13
#elif defined(BATRAT2)
  #define TX_RETRY_DELAY_MULTIPLIER 11
#elif defined(BATRAT3)
  #define TX_RETRY_DELAY_MULTIPLIER 7
#elif defined(BATRAT4)
  #define TX_RETRY_DELAY_MULTIPLIER 5
#elif defined(BATRAT5)
  #define TX_RETRY_DELAY_MULTIPLIER 3
#else
  #error No TX_RETRY_DELAY_MULTIPLIER defined for this batrat.
#endif
#define TX_MAX_RETRIES 15   // use 15 (the maximum) when expecting acks

// Possible data rates are RF24_250KBPS, RF24_1MBPS, or RF24_2MBPS.  (2 Mbps
// works with genuine Nordic Semiconductor chips only, not the counterfeits.)
#define DATA_RATE RF24_250KBPS

// Valid CRC length values are RF24_CRC_8, RF24_CRC_16, and RF24_CRC_DISABLED.
#define CRC_LENGTH RF24_CRC_16

// nRF24 frequency range:  2400 to 2525 MHz (channels 0 to 125)
// ISM: 2400-2500;  ham: 2390-2450
// WiFi ch. centers: 1:2412, 2:2417, 3:2422, 4:2427, 5:2432, 6:2437, 7:2442,
//                   8:2447, 9:2452, 10:2457, 11:2462, 12:2467, 13:2472, 14:2484
#define RF_CHANNEL 97

// RF24_PA_MIN = -18 dBm, RF24_PA_LOW = -12 dBm, RF24_PA_HIGH = -6 dBm, RF24_PA_MAX = 0 dBm
#define RF_POWER_LEVEL RF24_PA_LOW

#endif


/************************************
 * BoogieBoard Widget Configuration *
 ************************************/

#ifdef BOOGIEBOARD

#define WIDGET_ID 7

#define ENABLE_SYSTEM_RESET_WATCHDOG

static constexpr bool skipDeviceIdCheck = false;

#define ACTIVATE_WITH_MOVEMENT

static constexpr int16_t movementDetectionThreshold = 10;               // widget is active if gyro rotational speed > threshold
static constexpr uint32_t inactiveTransitionDelayMs = 5000;             // delay between inactivity detection and going inactive

static constexpr uint8_t mpu6050MotionDetectionThreshold = 1;           // unit is 2 mg
static constexpr uint8_t mpu6050MotionDetectionCounterDecrement = 1;
static constexpr uint8_t mpu6050MotionDetectionDuration = 1;            // unit is ms
static constexpr uint8_t mpu6050WakeFrequency = 0;                      // 0 = 1.25 Hz, 1 = 2.5 Hz, 2 - 5 Hz, 3 = 10 Hz

#define TEMPERATURE_SAMPLE_INTERVAL_MS 1000L
#define ACTIVE_TX_INTERVAL_MS 53L
#define INACTIVE_TX_INTERVAL_MS 2500L

// In standby mode, we'll transmit a packet with zero-valued data approximately
// every STANDBY_TX_INTERVAL_S seconds.  Wake-ups occur at 8-second intervals, so
// STANDBY_TX_INTERVAL_S should be a multiple of 8 between 8 and 2040, inclusive.
#define STANDBY_TX_INTERVAL_S 64

// The MPU-6050 is placed in cycle mode, and the processor is put to sleep
// when movement hasn't been detected for MOVEMENT_TIMEOUT_FOR_SLEEP_MS ms.
#define MOVEMENT_TIMEOUT_FOR_SLEEP_MS 60000L

// We use the time elapsed since getting good data from the MPU-6050 to determine
// if we need to reinitialize the little bastard because he's quit working right.
// MPU6050_ASSUMED_DEAD_TIMEOUT_MS must be less than MOVEMENT_TIMEOUT_FOR_SLEEP_MS
// so that we re-init the MPU-6050 rather than putting it in cycle mode when we're
// not getting good data from it.
///#define MPU6050_ASSUMED_DEAD_TIMEOUT_MS 3000

//#define TX_INDICATOR_LED_PIN 16
//#define TX_INDICATOR_LED_ON HIGH
//#define TX_INDICATOR_LED_OFF LOW
//#define IMU_NORMAL_INDICATOR_LED_PIN 16
//#define IMU_NORMAL_INDICATOR_LED_ON HIGH
//#define IMU_NORMAL_INDICATOR_LED_OFF LOW
#define IMU_INTERRUPT_PIN 2
#define VIBRATION_SENSOR_PIN 3
#define IMU_POWER_PIN 4
#define RADIO_CE_PIN 9
#define RADIO_CSN_PIN 10
// The radio uses the SPI bus, so it also uses SCK on 13, MISO on 12, and MOSI on 11.

// moving average length for averaging IMU measurements
#define MA_LENGTH 5

static constexpr uint8_t maSlotYaw = 0;
static constexpr uint8_t maSlotPitch = 1;
static constexpr uint8_t maSlotRoll = 2;
static constexpr uint8_t maSlotGyroX = 3;
static constexpr uint8_t maSlotGyroY = 4;
static constexpr uint8_t maSlotGyroZ = 5;
static constexpr uint8_t maSlotAccelX = 6;
static constexpr uint8_t maSlotAccelY = 7;
static constexpr uint8_t maSlotAccelZ = 8;
static constexpr uint8_t maSlotLinearAccelX = 9;
static constexpr uint8_t maSlotLinearAccelY = 10;
static constexpr uint8_t maSlotLinearAccelZ = 11;
static constexpr uint8_t maSlotTemperature = 12;

static constexpr uint8_t numMaSets = 13;

#define INCLUDE_ACCEL_DATA
#define INCLUDE_LINEAR_ACCEL_DATA

// ---------- radio configuration ----------

// Nwdgt, where N indicates the payload type (0: stress test; 1: position
// and velocity; 2: measurement vector; 3,4: undefined; 5: custom)
#define TX_PIPE_ADDRESS "2wdgt"

// Set WANT_ACK to false, TX_RETRY_DELAY_MULTIPLIER to 0, and TX_MAX_RETRIES
// to 0 for fire-and-forget.  To enable retries and delivery failure detection,
// set WANT_ACK to true.  The delay between retries is 250 us multiplied by
// TX_RETRY_DELAY_MULTIPLIER.  To help prevent repeated collisions, use 1, a
// prime number (2, 3, 5, 7, 11, 13), or 15 (the maximum) for the multiplier.
// TX_MAX_RETRIES is usually set to 15 when retries are enabled.
#define WANT_ACK true
#define TX_RETRY_DELAY_MULTIPLIER 3
#define TX_MAX_RETRIES 15

// Possible data rates are RF24_250KBPS, RF24_1MBPS, or RF24_2MBPS.  (2 Mbps
// works with genuine Nordic Semiconductor chips only, not the counterfeits.)
#define DATA_RATE RF24_250KBPS

// Valid CRC length values are RF24_CRC_8, RF24_CRC_16, and RF24_CRC_DISABLED.
#define CRC_LENGTH RF24_CRC_16

// nRF24 frequency range:  2400 to 2525 MHz (channels 0 to 125)
// ISM: 2400-2500;  ham: 2390-2450
// WiFi ch. centers: 1:2412, 2:2417, 3:2422, 4:2427, 5:2432, 6:2437, 7:2442,
//                   8:2447, 9:2452, 10:2457, 11:2462, 12:2467, 13:2472, 14:2484
#define RF_CHANNEL 97

// RF24_PA_MIN = -18 dBm, RF24_PA_LOW = -12 dBm, RF24_PA_HIGH = -6 dBm, RF24_PA_MAX = 0 dBm
#define RF_POWER_LEVEL RF24_PA_HIGH

#endif


/*******************************
 * Flower Widget Configuration *
 *******************************/

#ifdef FLOWER

#if defined(FLOWER1)
  #define WIDGET_ID 11
#elif defined(FLOWER2)
  #define WIDGET_ID 12
#elif defined(FLOWER3)
  #define WIDGET_ID 13
#elif defined(FLOWER4)
  #define WIDGET_ID 14
#elif defined(FLOWER5)
  #define WIDGET_ID 15
#elif defined(FLOWER6)
  #define WIDGET_ID 16
#elif defined(FLOWER7)
  #define WIDGET_ID 17
#else
  #error No widget id defined for this flower.
#endif

static constexpr bool skipDeviceIdCheck = false;

#define ACTIVATE_WITH_MOVEMENT

static constexpr int16_t movementDetectionThreshold = 5;                // widget is active if gyro rotational speed > threshold
static constexpr uint32_t inactiveTransitionDelayMs = 5000;             // delay between inactivity detection and going inactive

static constexpr uint8_t mpu6050MotionDetectionThreshold = 1;           // unit is 2 mg
static constexpr uint8_t mpu6050MotionDetectionCounterDecrement = 1;
static constexpr uint8_t mpu6050MotionDetectionDuration = 1;            // unit is ms
static constexpr uint8_t mpu6050WakeFrequency = 0;                      // 0 = 1.25 Hz, 1 = 2.5 Hz, 2 - 5 Hz, 3 = 10 Hz

#define TEMPERATURE_SAMPLE_INTERVAL_MS 1000L

#if defined(FLOWER1)
  #define ACTIVE_TX_INTERVAL_MS 31L
  #define INACTIVE_TX_INTERVAL_MS 3001L
#elif defined(FLOWER2)
  #define ACTIVE_TX_INTERVAL_MS 32L
  #define INACTIVE_TX_INTERVAL_MS 3002L
#elif defined(FLOWER3)
  #define ACTIVE_TX_INTERVAL_MS 33L
  #define INACTIVE_TX_INTERVAL_MS 3003L
#elif defined(FLOWER4)
  #define ACTIVE_TX_INTERVAL_MS 34L
  #define INACTIVE_TX_INTERVAL_MS 3004L
#elif defined(FLOWER5)
  #define ACTIVE_TX_INTERVAL_MS 35L
  #define INACTIVE_TX_INTERVAL_MS 3005L
#elif defined(FLOWER6)
  #define ACTIVE_TX_INTERVAL_MS 36L
  #define INACTIVE_TX_INTERVAL_MS 3006L
#elif defined(FLOWER7)
  #define ACTIVE_TX_INTERVAL_MS 37L
  #define INACTIVE_TX_INTERVAL_MS 3007L
#else
  #error No tx intervals defined for this flower.
#endif

// In standby mode, we'll transmit a packet with zero-valued data approximately
// every STANDBY_TX_INTERVAL_S seconds.  Wake-ups occur at 8-second intervals, so
// STANDBY_TX_INTERVAL_S should be a multiple of 8 between 8 and 2040, inclusive.
#define STANDBY_TX_INTERVAL_S 64

// The MPU-6050 is placed in cycle mode, and the processor is put to sleep
// when movement hasn't been detected for MOVEMENT_TIMEOUT_FOR_SLEEP_MS ms.
#define MOVEMENT_TIMEOUT_FOR_SLEEP_MS 60000L

// We use the time elapsed since getting good data from the MPU-6050 to determine
// if we need to reinitialize the little bastard because he's quit working right.
// MPU6050_ASSUMED_DEAD_TIMEOUT_MS must be less than MOVEMENT_TIMEOUT_FOR_SLEEP_MS
// so that we re-init the MPU-6050 rather than putting it in cycle mode when we're
// not getting good data from it.
///#define MPU6050_ASSUMED_DEAD_TIMEOUT_MS 3000

//#define TX_INDICATOR_LED_PIN 16
//#define TX_INDICATOR_LED_ON HIGH
//#define TX_INDICATOR_LED_OFF LOW
//#define IMU_NORMAL_INDICATOR_LED_PIN 16
//#define IMU_NORMAL_INDICATOR_LED_ON HIGH
//#define IMU_NORMAL_INDICATOR_LED_OFF LOW
#define IMU_INTERRUPT_PIN 2
#if defined(FLOWER3) || defined(FLOWER4) || defined(FLOWER5) || defined(FLOWER6) || defined(FLOWER7)
  #define VIBRATION_SENSOR_PIN 3
#endif
#define RADIO_CE_PIN 9
#define RADIO_CSN_PIN 10
// The radio uses the SPI bus, so it also uses SCK on 13, MISO on 12, and MOSI on 11.

// moving average length for averaging IMU measurements
#define MA_LENGTH 1

static constexpr uint8_t maSlotYaw = 0;
static constexpr uint8_t maSlotPitch = 1;
static constexpr uint8_t maSlotRoll = 2;
static constexpr uint8_t maSlotGyroX = 3;
static constexpr uint8_t maSlotGyroY = 4;
static constexpr uint8_t maSlotGyroZ = 5;
static constexpr uint8_t maSlotTemperature = 6;

static constexpr uint8_t numMaSets = 7;

// ---------- radio configuration ----------

// Nwdgt, where N indicates the payload type (0: stress test; 1: position
// and velocity; 2: measurement vector; 3,4: undefined; 5: custom)
#define TX_PIPE_ADDRESS "2wdgt"

// Set WANT_ACK to false, TX_RETRY_DELAY_MULTIPLIER to 0, and TX_MAX_RETRIES
// to 0 for fire-and-forget.  To enable retries and delivery failure detection,
// set WANT_ACK to true.  The delay between retries is 250 us multiplied by
// TX_RETRY_DELAY_MULTIPLIER.  To help prevent repeated collisions, use 1, a
// prime number (2, 3, 5, 7, 11, 13), or 15 (the maximum) for the multiplier.
// TX_MAX_RETRIES is usually set to 15 when retries are enabled.
#define WANT_ACK true
#define TX_MAX_RETRIES 15
#if defined(FLOWER1)
  #define TX_RETRY_DELAY_MULTIPLIER 9
#elif defined(FLOWER2)
  #define TX_RETRY_DELAY_MULTIPLIER 8
#elif defined(FLOWER3)
  #define TX_RETRY_DELAY_MULTIPLIER 5
#elif defined(FLOWER4)
  #define TX_RETRY_DELAY_MULTIPLIER 7
#elif defined(FLOWER5)
  #define TX_RETRY_DELAY_MULTIPLIER 11
#elif defined(FLOWER6)
  #define TX_RETRY_DELAY_MULTIPLIER 13
#elif defined(FLOWER7)
  #define TX_RETRY_DELAY_MULTIPLIER 15
#endif

// Possible data rates are RF24_250KBPS, RF24_1MBPS, or RF24_2MBPS.  (2 Mbps
// works with genuine Nordic Semiconductor chips only, not the counterfeits.)
#define DATA_RATE RF24_250KBPS

// Valid CRC length values are RF24_CRC_8, RF24_CRC_16, and RF24_CRC_DISABLED.
#define CRC_LENGTH RF24_CRC_16

// nRF24 frequency range:  2400 to 2525 MHz (channels 0 to 125)
// ISM: 2400-2500;  ham: 2390-2450
// WiFi ch. centers: 1:2412, 2:2417, 3:2422, 4:2427, 5:2432, 6:2437, 7:2442,
//                   8:2447, 9:2452, 10:2457, 11:2462, 12:2467, 13:2472, 14:2484
#define RF_CHANNEL 97

// RF24_PA_MIN = -18 dBm, RF24_PA_LOW = -12 dBm, RF24_PA_HIGH = -6 dBm, RF24_PA_MAX = 0 dBm
#define RF_POWER_LEVEL RF24_PA_HIGH

#endif


/******************************************************
 * Idaho Botanical Garden Tilt_x Widget Configuration *
 ******************************************************/

#if defined(IBG_TILT_1) || defined(IBG_TILT_2) || defined(IBG_TILT_TEST)

#if defined(IBG_TILT_1)
  #define WIDGET_ID 1
#elif defined(IBG_TILT_2)
  #define WIDGET_ID 2
#elif defined(IBG_TILT_TEST)
  #define WIDGET_ID 3
#else
  #error No widget id defined for this tilt widget.
#endif

static constexpr bool skipDeviceIdCheck = false;

#define ACTIVATE_WITH_MOVEMENT

static constexpr int16_t movementDetectionThreshold = 10;               // widget is active if gyro rotational speed > threshold
static constexpr uint32_t inactiveTransitionDelayMs = 5000;             // delay between inactivity detection and going inactive

static constexpr uint8_t mpu6050MotionDetectionThreshold = 1;           // unit is 2 mg
static constexpr uint8_t mpu6050MotionDetectionCounterDecrement = 1;
static constexpr uint8_t mpu6050MotionDetectionDuration = 1;            // unit is ms
static constexpr uint8_t mpu6050WakeFrequency = 0;                      // 0 = 1.25 Hz, 1 = 2.5 Hz, 2 - 5 Hz, 3 = 10 Hz

#define TEMPERATURE_SAMPLE_INTERVAL_MS 1000L

// Use a different transmit interval for each of the widgets so that their
// transmissions are staggered, thus (hopefully) reducing collisions.
#if defined(IBG_TILT_1)
  #define ACTIVE_TX_INTERVAL_MS 23L
  #define INACTIVE_TX_INTERVAL_MS 200L
#elif defined(IBG_TILT_2)
  #define ACTIVE_TX_INTERVAL_MS 29L
  #define INACTIVE_TX_INTERVAL_MS 210L
#elif defined(IBG_TILT_TEST)
  #define ACTIVE_TX_INTERVAL_MS 37L
  #define INACTIVE_TX_INTERVAL_MS 220L
#endif

// In standby mode, we'll transmit a packet with zero-valued data approximately
// every STANDBY_TX_INTERVAL_S seconds.  Wake-ups occur at 8-second intervals, so
// STANDBY_TX_INTERVAL_S should be a multiple of 8 between 8 and 2040, inclusive.
#define STANDBY_TX_INTERVAL_S 64

// The MPU-6050 is placed in cycle mode, and the processor is put to sleep
// when movement hasn't been detected for MOVEMENT_TIMEOUT_FOR_SLEEP_MS ms.
#define MOVEMENT_TIMEOUT_FOR_SLEEP_MS 60000L

// We use the time elapsed since getting good data from the MPU-6050 to determine
// if we need to reinitialize the little bastard because he's quit working right.
// MPU6050_ASSUMED_DEAD_TIMEOUT_MS must be less than MOVEMENT_TIMEOUT_FOR_SLEEP_MS
// so that we re-init the MPU-6050 rather than putting it in cycle mode when we're
// not getting good data from it.
///#define MPU6050_ASSUMED_DEAD_TIMEOUT_MS 3000

//#define TX_INDICATOR_LED_PIN 16
//#define TX_INDICATOR_LED_ON HIGH
//#define TX_INDICATOR_LED_OFF LOW
//#define IMU_NORMAL_INDICATOR_LED_PIN 16
//#define IMU_NORMAL_INDICATOR_LED_ON HIGH
//#define IMU_NORMAL_INDICATOR_LED_OFF LOW
#define IMU_INTERRUPT_PIN 2
#define RADIO_CE_PIN 9
#define RADIO_CSN_PIN 10
// The radio uses the SPI bus, so it also uses SCK on 13, MISO on 12, and MOSI on 11.

// moving average length for averaging IMU measurements
#define MA_LENGTH 20

static constexpr uint8_t maSlotYaw = 0;
static constexpr uint8_t maSlotPitch = 1;
static constexpr uint8_t maSlotRoll = 2;
static constexpr uint8_t maSlotGyroX = 3;
static constexpr uint8_t maSlotGyroY = 4;
static constexpr uint8_t maSlotGyroZ = 5;
static constexpr uint8_t maSlotAccelX = 6;
static constexpr uint8_t maSlotAccelY = 7;
static constexpr uint8_t maSlotAccelZ = 8;
static constexpr uint8_t maSlotLinearAccelX = 9;
static constexpr uint8_t maSlotLinearAccelY = 10;
static constexpr uint8_t maSlotLinearAccelZ = 11;
static constexpr uint8_t maSlotTemperature = 12;

static constexpr uint8_t numMaSets = 13;

#define INCLUDE_ACCEL_DATA
#define INCLUDE_LINEAR_ACCEL_DATA

// ---------- radio configuration ----------

// Nwdgt, where N indicates the payload type (0: stress test; 1: position
// and velocity; 2: measurement vector; 3,4: undefined; 5: custom)
#define TX_PIPE_ADDRESS "2wdgt"

// Set WANT_ACK to false, TX_RETRY_DELAY_MULTIPLIER to 0, and TX_MAX_RETRIES
// to 0 for fire-and-forget.  To enable retries and delivery failure detection,
// set WANT_ACK to true.  The delay between retries is 250 us multiplied by
// TX_RETRY_DELAY_MULTIPLIER.  To help prevent repeated collisions, use 1, a
// prime number (2, 3, 5, 7, 11, 13), or 15 (the maximum) for the multiplier.
// TX_MAX_RETRIES is usually set to 15 when retries are enabled.
#define WANT_ACK false
#define TX_RETRY_DELAY_MULTIPLIER 0
#define TX_MAX_RETRIES 0

// Possible data rates are RF24_250KBPS, RF24_1MBPS, or RF24_2MBPS.  (2 Mbps
// works with genuine Nordic Semiconductor chips only, not the counterfeits.)
#define DATA_RATE RF24_250KBPS

// Valid CRC length values are RF24_CRC_8, RF24_CRC_16, and RF24_CRC_DISABLED.
#define CRC_LENGTH RF24_CRC_16

// nRF24 frequency range:  2400 to 2525 MHz (channels 0 to 125)
// ISM: 2400-2500;  ham: 2390-2450
// WiFi ch. centers: 1:2412, 2:2417, 3:2422, 4:2427, 5:2432, 6:2437, 7:2442,
//                   8:2447, 9:2452, 10:2457, 11:2462, 12:2467, 13:2472, 14:2484
#define RF_CHANNEL 97

// RF24_PA_MIN = -18 dBm, RF24_PA_LOW = -12 dBm, RF24_PA_HIGH = -6 dBm, RF24_PA_MAX = 0 dBm
#define RF_POWER_LEVEL RF24_PA_MAX

#endif


/**********************************
 * Rainstick Widget Configuration *
 **********************************/

#ifdef RAINSTICK

#define WIDGET_ID 4

static constexpr bool skipDeviceIdCheck = false;

#define ENABLE_SOUND
#define ACTIVATE_WITH_SOUND

static constexpr uint16_t activeSoundThreshold = 100;
static constexpr int16_t movementDetectionThreshold = 10;               // widget is active if gyro rotational speed > threshold
static constexpr uint32_t inactiveTransitionDelayMs = 0;                // delay between inactivity detection and going inactive

static constexpr uint8_t mpu6050MotionDetectionThreshold = 1;           // unit is 2 mg
static constexpr uint8_t mpu6050MotionDetectionCounterDecrement = 1;
static constexpr uint8_t mpu6050MotionDetectionDuration = 1;            // unit is ms
static constexpr uint8_t mpu6050WakeFrequency = 1;                      // 0 = 1.25 Hz, 1 = 2.5 Hz, 2 - 5 Hz, 3 = 10 Hz

#define TEMPERATURE_SAMPLE_INTERVAL_MS 1000L
#define SOUND_SAMPLE_INTERVAL_MS 10L
#define SOUND_SAVE_INTERVAL_MS 50L
#define ACTIVE_TX_INTERVAL_MS 93L
#define INACTIVE_TX_INTERVAL_MS 2000L

// In standby mode, we'll transmit a packet with zero-valued data approximately
// every STANDBY_TX_INTERVAL_S seconds.  Wake-ups occur at 8-second intervals, so
// STANDBY_TX_INTERVAL_S should be a multiple of 8 between 8 and 2040, inclusive.
#define STANDBY_TX_INTERVAL_S 64

// The MPU-6050 is placed in cycle mode, and the processor is put to sleep
// when movement hasn't been detected for MOVEMENT_TIMEOUT_FOR_SLEEP_MS ms.
#define MOVEMENT_TIMEOUT_FOR_SLEEP_MS 60000L

// We use the time elapsed since getting good data from the MPU-6050 to determine
// if we need to reinitialize the little bastard because he's quit working right.
// MPU6050_ASSUMED_DEAD_TIMEOUT_MS must be less than MOVEMENT_TIMEOUT_FOR_SLEEP_MS
// so that we re-init the MPU-6050 rather than putting it in cycle mode when we're
// not getting good data from it.
///#define MPU6050_ASSUMED_DEAD_TIMEOUT_MS 3000

//#define TX_INDICATOR_LED_PIN 16
//#define TX_INDICATOR_LED_ON HIGH
//#define TX_INDICATOR_LED_OFF LOW
//#define IMU_NORMAL_INDICATOR_LED_PIN 16
//#define IMU_NORMAL_INDICATOR_LED_ON HIGH
//#define IMU_NORMAL_INDICATOR_LED_OFF LOW
#define IMU_INTERRUPT_PIN 2
#define RADIO_CE_PIN 9
#define RADIO_CSN_PIN 10
// The radio uses the SPI bus, so it also uses SCK on 13, MISO on 12, and MOSI on 11.

// --- the real Rainstick ---
#define MIC_SIGNAL_PIN A0
#define MIC_POWER_PIN 8
// --- development breadboard ---
//#define MIC_SIGNAL_PIN A3
//#define MIC_POWER_PIN 4

// moving average length for averaging sound and IMU measurements
#define MA_LENGTH 8

static constexpr uint8_t maSlotYaw = 0;
static constexpr uint8_t maSlotPitch = 1;
static constexpr uint8_t maSlotRoll = 2;
static constexpr uint8_t maSlotGyroX = 3;
static constexpr uint8_t maSlotGyroY = 4;
static constexpr uint8_t maSlotGyroZ = 5;
static constexpr uint8_t maSlotAccelX = 6;
static constexpr uint8_t maSlotAccelY = 7;
static constexpr uint8_t maSlotAccelZ = 8;
static constexpr uint8_t maSlotLinearAccelX = 9;
static constexpr uint8_t maSlotLinearAccelY = 10;
static constexpr uint8_t maSlotLinearAccelZ = 11;
static constexpr uint8_t maSlotTemperature = 12;
static constexpr uint8_t maSlotPpSound = 13;

static constexpr uint8_t numMaSets = 14;

#define INCLUDE_ACCEL_DATA
#define INCLUDE_LINEAR_ACCEL_DATA

// ---------- radio configuration ----------

// Nwdgt, where N indicates the payload type (0: stress test; 1: position
// and velocity; 2: measurement vector; 3,4: undefined; 5: custom)
#define TX_PIPE_ADDRESS "2wdgt"

// Set WANT_ACK to false, TX_RETRY_DELAY_MULTIPLIER to 0, and TX_MAX_RETRIES
// to 0 for fire-and-forget.  To enable retries and delivery failure detection,
// set WANT_ACK to true.  The delay between retries is 250 us multiplied by
// TX_RETRY_DELAY_MULTIPLIER.  To help prevent repeated collisions, use 1, a
// prime number (2, 3, 5, 7, 11, 13), or 15 (the maximum) for the multiplier.
// TX_MAX_RETRIES is usually set to 15 when retries are enabled.
#define WANT_ACK true
#define TX_RETRY_DELAY_MULTIPLIER 5     // use 5 when getting acks
#define TX_MAX_RETRIES 15               // use 15 when getting acks

// Possible data rates are RF24_250KBPS, RF24_1MBPS, or RF24_2MBPS.  (2 Mbps
// works with genuine Nordic Semiconductor chips only, not the counterfeits.)
#define DATA_RATE RF24_250KBPS

// Valid CRC length values are RF24_CRC_8, RF24_CRC_16, and RF24_CRC_DISABLED
#define CRC_LENGTH RF24_CRC_16

// nRF24 frequency range:  2400 to 2525 MHz (channels 0 to 125)
// ISM: 2400-2500;  ham: 2390-2450
// WiFi ch. centers: 1:2412, 2:2417, 3:2422, 4:2427, 5:2432, 6:2437, 7:2442,
//                   8:2447, 9:2452, 10:2457, 11:2462, 12:2467, 13:2472, 14:2484
#define RF_CHANNEL 97

// RF24_PA_MIN = -18 dBm, RF24_PA_LOW = -12 dBm, RF24_PA_HIGH = -6 dBm, RF24_PA_MAX = 0 dBm
#define RF_POWER_LEVEL RF24_PA_HIGH

#endif



/*******************************
 * Common Widget Configuration *
 *******************************/

#define LCD_RS A1
#define LCD_E  A0
#define LCD_D4  5
#define LCD_D5  6
#define LCD_D6  7
#define LCD_D7  8

// When we aren't retrieving packets from the MPU-6050's FIFO fast enough, FIFO
// overflow and resulting data corruption become likely.  To help prevent that,
// we'll clear the FIFO when more than maxPacketsInMpu6050FifoBeforeForcedClear
// packets are in it.
constexpr uint8_t maxPacketsInMpu6050FifoBeforeForcedClear = 2;

// The cheap-ass MPU-6050s sometimes lock up for no apparent reason.
// imuPowerCycleMs is how long we turn off the MPU-6050 just prior to initializing
// it, thus hopefully waking it back up after the watchdog triggers a system reset.
constexpr uint32_t imuPowerCycleMs = 500;

// interrupt enabled, system reset disabled, 8-second interval
static constexpr uint8_t watchdogForSleepWakeup = (1 << WDIE) | (0 << WDE) | (1 << WDP3) | (0 << WDP2) | (0 << WDP1) | (1 << WDP0);

// interrupt disabled, system reset enabled, 2-second interval
#ifdef ENABLE_SYSTEM_RESET_WATCHDOG
static constexpr uint8_t watchdogForSystemReset = (0 << WDIE) | (1 << WDE) | (0 << WDP3) | (1 << WDP2) | (1 << WDP1) | (1 << WDP0);
#else
static constexpr uint8_t watchdogForSystemReset = watchdogForSleepWakeup;
#endif

/***********
 * Globals *
 ***********/

static WidgetMode widgetMode = WidgetMode::init;
static Mpu6050Mode mpu6050Mode = Mpu6050Mode::init;

static RF24 radio(RADIO_CE_PIN, RADIO_CSN_PIN);

#ifdef ENABLE_LCD
static LiquidCrystal lcd(LCD_RS, LCD_E, LCD_D4, LCD_D5, LCD_D6, LCD_D7);
#endif

static MeasurementVectorPayload payload;

#ifdef ENABLE_SOUND
static uint16_t minSoundSample = UINT16_MAX;
static uint16_t maxSoundSample;
static bool isSoundActive;
#endif

static bool isImuActive;

static int16_t maValues[numMaSets][MA_LENGTH];
static int32_t maSums[numMaSets];
static uint8_t maNextSlotIdx[numMaSets];
static bool maSetFull[numMaSets];

static MPU6050 mpu6050;           // using default I2C address 0x68

// MPU-6050 FIFO read buffer
static uint16_t packetSize;       // expected DMP packet size (default is 42 bytes)
static uint8_t packetBuffer[42];  // must be at least as large as packet size returned by dmpGetFIFOPacketSize

static volatile bool gotMpu6050Interrupt;
static volatile int16_t gotVibrationSensorInterrupt;

static int32_t nextTxMs;
static int32_t lastTemperatureSampleMs;
///static int32_t lastSuccessfulMpu6050ReadMs;
static uint32_t lastMotionDetectedMs;
#ifdef ENABLE_SOUND
static int32_t lastSoundSampleMs;
static int32_t lastSoundSaveMs;
#endif

static uint32_t txInterval;

static uint8_t stayAwakeCountdown;


/******************
 * Implementation *
 ******************/

// TODO:  Move the moving average stuff to a class in a library.
void clearMovingAverages();
void updateMovingAverage(uint8_t setIdx, int16_t newValue);
int16_t getMovingAverage(uint8_t setIdx);
bool detectMovingAverageChange(uint8_t setIdx, int16_t threshold);


ISR(WDT_vect)
{
  if (widgetMode == WidgetMode::standby) {
    sleep_disable();
  }
}


// top half of the MPU-6050 ISR (bottom half is processMpu6050Interrupt)
void handleMpu6050Interrupt()
{
  if (widgetMode == WidgetMode::standby) {
    sleep_disable();
  }
  gotMpu6050Interrupt = true;
}


// top half of the vibration sensor ISR
void handleVibrationSensorInterrupt()
{
  if (widgetMode == WidgetMode::standby) {
    sleep_disable();
  }
  gotVibrationSensorInterrupt = true;
}


void configureWatchdog(uint8_t watchdogControlRegister)
{
  // We have to turn off interrupts because the changes to the control register
  // must be done within four clock cycles of setting WDCE (change-enable bit).
  wdt_reset();
  noInterrupts();
  _WD_CONTROL_REG = (1 << WDCE) | (1 << WDE);
  _WD_CONTROL_REG = watchdogControlRegister;
  interrupts();
  wdt_reset();
}


bool widgetWakeUp()
{
  // Returns true if widget should stay awake, false if it should go back to sleep.

  uint32_t now = millis();

  if (!gotMpu6050Interrupt && !gotVibrationSensorInterrupt) {
#ifdef ENABLE_DEBUG_PRINT
    Serial.println(F("Woken up by watchdog."));
#endif
    // Watchdog wake-ups occur at 8-second intervals.  We'll count down until
    // enough watchdog wake-ups have occurred, then we'll send a "still alive"
    // message at the specified interval (STANDBY_TX_INTERVAL_S).
    if (--stayAwakeCountdown == 0) {
      stayAwakeCountdown = STANDBY_TX_INTERVAL_S / 8;
      // Let the pattern controller know we're still alive.
      // (The data sent will be all zeros because the averages
      // were cleared before we went to sleep.)
      sendMeasurements();
    }
    return false;
  }

#ifdef ENABLE_DEBUG_PRINT
  Serial.println(gotMpu6050Interrupt ? F("Woken up by MPU-6050.") : F("Woken up by vibration sensor."));
#endif

  // Reinitialize all the time trackers because the ms timer has been off.
  // Time in this little world has stood still while time in the default
  // world marched on, so we need transmit and gather data ASAP.
  nextTxMs = now;
  lastTemperatureSampleMs = now;
  lastMotionDetectedMs = now;
///  lastSuccessfulMpu6050ReadMs = now;
  isImuActive = true;
#ifdef ENABLE_SOUND
  lastSoundSampleMs = now;
  lastSoundSaveMs = now;
  isSoundActive = false;
#endif

  if (gotVibrationSensorInterrupt) {
    setMpu6050Mode(Mpu6050Mode::normal, millis());
    gotVibrationSensorInterrupt = false;
  }

  return true;
}


void widgetSleep()
{
  // After we wake up, the averages will be stale.  Clear them now
  // so that the periodic transmissions caused by watchdog wakeup
  // will send zero values.
  clearMovingAverages();
  
  // We don't want interrupts duing the timing-critical stuff below,
  // and we don't want the ISR to disable sleep before we go to sleep.
  noInterrupts();

  // Ignore an interrupt that hasn't been serviced yet.
  gotMpu6050Interrupt = false;
  gotVibrationSensorInterrupt = false;

  set_sleep_mode(SLEEP_MODE_PWR_DOWN);
  sleep_enable();

  // The interrupt is already attached because it is the interrupt the IMU uses.

  // Turn off brown-out enable in software.  BODS must be set to
  // one and BODSE must be set to zero within four clock cycles.
  MCUCR = bit (BODS) | bit (BODSE);
  // The BODS bit is automatically cleared after three clock cycles.
  MCUCR = bit (BODS);

  // Standby mode tells the ISR to disable sleep after we wake up.
  widgetMode = WidgetMode::standby;

  // sleep_cpu is guarnteed to be called because the processor always
  // executes the next instruction after interrupts are enabled.
  interrupts();
  sleep_cpu();
}


void setWidgetMode(WidgetMode newMode, uint32_t now)
{
  bool stayAwake;
  
  switch (newMode) {

    case WidgetMode::standby:
#ifdef ENABLE_DEBUG_PRINT
      Serial.println(F("Widget mode changing to standby."));
#endif
#ifdef ENABLE_SOUND
      digitalWrite(MIC_POWER_PIN, LOW);
#endif
      setMpu6050Mode(Mpu6050Mode::cycle, now);
      stayAwakeCountdown = STANDBY_TX_INTERVAL_S / 8;
      configureWatchdog(watchdogForSleepWakeup);
      stayAwake = false;
      while (!stayAwake) {
        // widgetSleep returns after we sleep then wake up.
        widgetSleep();
        stayAwake = widgetWakeUp();
      }
      configureWatchdog(watchdogForSystemReset);
#ifdef ENABLE_SOUND
      digitalWrite(MIC_POWER_PIN, HIGH);
#endif
      widgetMode = WidgetMode::inactive;
      break;

    case WidgetMode::inactive:
#ifdef ENABLE_DEBUG_PRINT
      Serial.println(F("Widget mode changing to inactive."));
#endif
      // The change in tx interval will become effective after the next
      // transmission, which needs to happen at the shorter active interval
      // so that the pattern controller quicly knows we've gone inactive.
      txInterval = INACTIVE_TX_INTERVAL_MS;
#ifdef ENABLE_SOUND
      digitalWrite(MIC_POWER_PIN, HIGH);
#endif
      widgetMode = WidgetMode::inactive;
      break;

    case WidgetMode::active:
#ifdef ENABLE_DEBUG_PRINT
      Serial.println(F("Widget mode changing to active."));
#endif
      txInterval = ACTIVE_TX_INTERVAL_MS;
      // The next transmission needs to be as soon as practical so that
      // the pattern controller quickly knows that we're active again.
      if ((int32_t) (nextTxMs - now) > ACTIVE_TX_INTERVAL_MS) {
        nextTxMs = now + ACTIVE_TX_INTERVAL_MS;
      }
#ifdef ENABLE_SOUND
      digitalWrite(MIC_POWER_PIN, HIGH);
#endif
      widgetMode = WidgetMode::active;
      break;

    default:
#ifdef ENABLE_DEBUG_PRINT
      Serial.println(F("*** Invalid newMode in setWidgetMode"));
#endif
      break;
  }
}


void setMpu6050Mode(Mpu6050Mode newMode, uint32_t now)
{
  switch (newMode) {

    case Mpu6050Mode::cycle:
#ifdef ENABLE_DEBUG_PRINT
      Serial.println(F("Setting mpu6050Mode to cycle..."));
#endif
      mpu6050.setDMPEnabled(false);
      // Set up motion detection.
      mpu6050.setMotionDetectionThreshold(mpu6050MotionDetectionThreshold);
      mpu6050.setMotionDetectionCounterDecrement(mpu6050MotionDetectionCounterDecrement);
      mpu6050.setMotionDetectionDuration(mpu6050MotionDetectionDuration);
      // Put MPU-6050 in cycle mode.
      mpu6050Mode = Mpu6050Mode::cycle;
      mpu6050.setWakeFrequency(mpu6050WakeFrequency);
      gotMpu6050Interrupt = false;
      mpu6050.setWakeCycleEnabled(true);
      mpu6050.setIntMotionEnabled(true);
#ifdef IMU_NORMAL_INDICATOR_LED_PIN
      digitalWrite(IMU_NORMAL_INDICATOR_LED_PIN, IMU_NORMAL_INDICATOR_LED_OFF);
#endif
      break;

    case Mpu6050Mode::normal:
#ifdef ENABLE_DEBUG_PRINT
      Serial.println(F("Setting mpu6050Mode to normal..."));
#endif
      mpu6050.setIntMotionEnabled(false);
      mpu6050.setWakeCycleEnabled(false);
      gotMpu6050Interrupt = false;
      clearMpu6050Fifo();
      mpu6050Mode = Mpu6050Mode::normal;
      mpu6050.setDMPEnabled(true);
      lastTemperatureSampleMs = now;
      lastMotionDetectedMs = now;
///      lastSuccessfulMpu6050ReadMs = now;
#ifdef IMU_NORMAL_INDICATOR_LED_PIN
      digitalWrite(IMU_NORMAL_INDICATOR_LED_PIN, IMU_NORMAL_INDICATOR_LED_ON);
#endif
      break;

    default:
#ifdef ENABLE_DEBUG_PRINT
      Serial.println(F("*** Invalid newMode in setMpu6050Mode"));
#endif
#ifdef IMU_NORMAL_INDICATOR_LED_PIN
      digitalWrite(IMU_NORMAL_INDICATOR_LED_PIN, IMU_NORMAL_INDICATOR_LED_OFF);
#endif
      break;
  }
}


void initI2c()
{
#if I2CDEV_IMPLEMENTATION == I2CDEV_ARDUINO_WIRE
#ifdef ENABLE_DEBUG_PRINT
  Serial.println(F("initI2c:  I2CDEV_IMPLEMENTATION == I2CDEV_ARDUINO_WIRE"));
#endif
  Wire.begin();
  TWBR = 24; // 400kHz I2C clock (200kHz if CPU is 8MHz)
#elif I2CDEV_IMPLEMENTATION == I2CDEV_BUILTIN_FASTWIRE
#ifdef ENABLE_DEBUG_PRINT
  Serial.println(F("initI2c:  I2CDEV_IMPLEMENTATION == I2CDEV_BUILTIN_FASTWIRE"));
#endif
  Fastwire::setup(400, true);
#endif
}


void initLcd()
{
#if defined(ENABLE_LCD_16x2)
  lcd.begin(20, 2);
#elif defined(ENABLE_LCD_20x4)
  lcd.begin(20, 4);
#endif
}


bool initMpu6050()
{
#ifdef IMU_POWER_PIN
  digitalWrite(IMU_POWER_PIN, LOW);
  delay(imuPowerCycleMs);
  digitalWrite(IMU_POWER_PIN, HIGH);
  delay(imuPowerCycleMs);
#endif

  if (!skipDeviceIdCheck) {
#ifdef ENABLE_DEBUG_PRINT
    Serial.println(F("Testing MPU6050 connection..."));
#endif
    if (!mpu6050.testConnection()) {
#ifdef ENABLE_DEBUG_PRINT
    Serial.println(F("MPU6050 connection failed."));
#endif
    return false;
  }
#ifdef ENABLE_DEBUG_PRINT
    Serial.println(F("MPU6050 connection successful."));
#endif
  }

#ifdef ENABLE_DEBUG_PRINT
  Serial.println(F("Initializing MPU6050..."));
#endif
  mpu6050.initialize();

#ifdef ENABLE_DEBUG_PRINT
  Serial.println(F("Initializing DMP..."));
#endif
  uint8_t devStatus = mpu6050.dmpInitialize();
  if (devStatus != 0) {
    // Well, shit.
    // 1 = initial memory load failed (most likely)
    // 2 = DMP configuration updates failed
#ifdef ENABLE_DEBUG_PRINT
    Serial.print(F("*** DMP Initialization failed.  devStatus="));
    Serial.println(devStatus);
#endif
    return false;
  }

  // Get expected DMP packet size, and make sure packetBuffer is large enough.
  packetSize = mpu6050.dmpGetFIFOPacketSize();
  if (sizeof(packetBuffer) < packetSize) {
#ifdef ENABLE_DEBUG_PRINT
    Serial.print(F("*** FIFO packet size "));
    Serial.print(packetSize);
    Serial.print(F(" is larger than packetBuffer size "));
    Serial.println(sizeof(packetBuffer));
#endif
    return false;
  }

#ifdef ENABLE_DEBUG_PRINT
  Serial.println(F("DMP ready."));
#endif

  // supply your own gyro offsets here, scaled for min sensitivity
  // TODO 2/28/2018 ross:  What do we do about this?  Every widget could be different.
  //mpu6050.setXGyroOffset(220);
  //mpu6050.setYGyroOffset(76);
  //mpu6050.setZGyroOffset(-85);
  //mpu6050.setZAccelOffset(1788); // 1688 factory default for my test chip

#ifdef ENABLE_DEBUG_PRINT
  Serial.println(F("Enabling interrupt..."));
#endif
  pinMode(IMU_INTERRUPT_PIN, INPUT);
  attachInterrupt(digitalPinToInterrupt(IMU_INTERRUPT_PIN), handleMpu6050Interrupt, RISING);

  setMpu6050Mode(Mpu6050Mode::normal, millis());

  return true;
}


void initVibrationSensor()
{
#ifdef VIBRATION_SENSOR_PIN
  pinMode(VIBRATION_SENSOR_PIN, INPUT);
  digitalWrite(VIBRATION_SENSOR_PIN, HIGH);
  attachInterrupt(digitalPinToInterrupt(VIBRATION_SENSOR_PIN), handleVibrationSensorInterrupt, CHANGE);
#endif  
}


void setup()
{
  configureWatchdog(watchdogForSystemReset);

#ifdef ENABLE_DEBUG_PRINT
  Serial.begin(115200);
  printf_begin();
#endif

#ifdef TX_INDICATOR_LED_PIN
  pinMode(TX_INDICATOR_LED_PIN, OUTPUT);
  digitalWrite(TX_INDICATOR_LED_PIN, TX_INDICATOR_LED_OFF);
#endif
#ifdef IMU_NORMAL_INDICATOR_LED_PIN
  pinMode(IMU_NORMAL_INDICATOR_LED_PIN, OUTPUT);
  digitalWrite(IMU_NORMAL_INDICATOR_LED_PIN, IMU_NORMAL_INDICATOR_LED_OFF);
#endif
#ifdef DEBUG_A_PIN
  pinMode(DEBUG_A_PIN, OUTPUT);
  digitalWrite(DEBUG_A_PIN, LOW);
#endif
#ifdef ENABLE_SOUND
  pinMode(MIC_POWER_PIN, OUTPUT);
  digitalWrite(MIC_POWER_PIN, LOW);
#endif
#ifdef IMU_POWER_PIN
  pinMode(IMU_POWER_PIN, OUTPUT);
  digitalWrite(IMU_POWER_PIN, LOW);
#endif

  initI2c();
  initMpu6050();
  initVibrationSensor();
  initLcd();

  configureRadio(radio, TX_PIPE_ADDRESS, WANT_ACK, TX_RETRY_DELAY_MULTIPLIER,
                 TX_MAX_RETRIES, CRC_LENGTH, RF_POWER_LEVEL, DATA_RATE,
                 RF_CHANNEL);

  payload.widgetHeader.id = WIDGET_ID;
  payload.widgetHeader.isActive = false;
  payload.widgetHeader.channel = 0;

  setWidgetMode(WidgetMode::inactive, millis());
}


void clearMovingAverages()
{
  for (uint8_t i = 0; i < numMaSets; ++i) {
    for (uint8_t j = 0; j < MA_LENGTH; ++j) {
      maValues[i][j] = 0;
    }
    maSums[i] = 0;
    maNextSlotIdx[i] = 0;
    maSetFull[i] = false;
  }
}


void updateMovingAverage(uint8_t setIdx, int16_t newValue)
{
  maSums[setIdx] -= maValues[setIdx][maNextSlotIdx[setIdx]];
  maSums[setIdx] += newValue;
  maValues[setIdx][maNextSlotIdx[setIdx]] = newValue;

  ++maNextSlotIdx[setIdx];
  if (maNextSlotIdx[setIdx] >= MA_LENGTH) {
     maSetFull[setIdx] = true;
     maNextSlotIdx[setIdx] = 0;
  }
}


int16_t getMovingAverage(uint8_t setIdx)
{
  int32_t avg;
  if (maSetFull[setIdx]) {
    avg = maSums[setIdx] / (int32_t) MA_LENGTH;
  }
  else {
    avg = maNextSlotIdx[setIdx] > 0 ? (int32_t) maSums[setIdx] / (int32_t) maNextSlotIdx[setIdx] : 0;
  }

//#ifdef ENABLE_DEBUG_PRINT
//  Serial.print("getMovingAverage(");
//  Serial.print(setIdx);
//  Serial.print("):  ");
//  for (uint8_t i = 0; i < (maSetFull[setIdx] ? MA_LENGTH : maNextSlotIdx[setIdx]); ++i) {
//    Serial.print(i);
//    Serial.print(":");
//    Serial.print(maValues[setIdx][i]);
//    Serial.print("  ");
//  }
//  Serial.print(maSums[setIdx]);
//  Serial.print("  ");
//  Serial.println(avg);
//#endif

  return avg;
}


bool detectMovingAverageChange(uint8_t setIdx, int16_t threshold)
{
  uint8_t latestSlotIdx;
  if (maNextSlotIdx[setIdx] == 0) {
    if (!maSetFull[setIdx]) {
      return false;
    }
    latestSlotIdx = MA_LENGTH - 1;
  }
  else {
    latestSlotIdx = maNextSlotIdx[setIdx] - 1;
  }
  int16_t diff = maValues[setIdx][maNextSlotIdx[setIdx]] - maValues[setIdx][latestSlotIdx];
  return abs(diff) > threshold ? true : false;
}


void clearMpu6050Fifo()
{
#ifdef ENABLE_DEBUG_PRINT
  Serial.println(F("Clearing FIFO..."));
#endif

  uint16_t fifoCount = mpu6050.getFIFOCount();
  while (fifoCount != 0) {
    uint8_t readLength = fifoCount >= packetSize ? packetSize : fifoCount;
    mpu6050.getFIFOBytes(packetBuffer, readLength);
    fifoCount -= readLength;
  }

#ifdef ENABLE_DEBUG_PRINT
    Serial.println(F("Cleared FIFO."));
#endif
}


void gatherTemperatureMeasurement()
{
#ifdef DEBUG_A_PIN
  digitalWrite(DEBUG_A_PIN, HIGH);
#endif
  int16_t rawTemperature = mpu6050.getTemperature();
#ifdef DEBUG_A_PIN
  digitalWrite(DEBUG_A_PIN, LOW);
#endif

//  float temperatureC = (float) rawTemperature / 340.0 + 36.53;
//  float temperatureF = temperatureC * 9.0/5.0 + 32.0;

  float temperatureFTimes10 = (float) rawTemperature / 18.8889 + 977.54;
  updateMovingAverage(maSlotTemperature, temperatureFTimes10);

#ifdef ENABLE_DEBUG_PRINT
  Serial.print(F("rawTemp="));
  Serial.print(rawTemperature);
//  Serial.print(F("  tempC="));
//  Serial.print(temperatureC);
//  Serial.print(F("  tempF="));
//  Serial.println(temperatureF);
  Serial.print(F("  temp10F="));
  Serial.println(temperatureFTimes10);
#endif
}


void gatherMotionMeasurements(uint32_t now)
{
  uint16_t fifoCount = mpu6050.getFIFOCount();
  while (fifoCount >= packetSize) {

    mpu6050.getFIFOBytes(packetBuffer, packetSize);
    fifoCount -= packetSize;

//#ifdef ENABLE_DEBUG_PRINT
//    // Careful:  We might not be able to keep up if this debug print is enabled.
//    Serial.print(F("Got packet from fifo.  fifoCount now "));
//    Serial.println(fifoCount);
//#endif

    VectorInt16 gyro;
    Quaternion quat;            // [w, x, y, z] quaternion container
    VectorFloat gravity;        // [x, y, z] gravity vector
    float ypr[3];               // [yaw, pitch, roll] yaw/pitch/roll container
    VectorInt16 accel;          // [x, y, z] accel sensor measurements
    VectorInt16 linearAccel;    // [x, y, z] gravity-free accel sensor measurements

    mpu6050.dmpGetGyro(&gyro, packetBuffer);
    mpu6050.dmpGetQuaternion(&quat, packetBuffer);
    mpu6050.dmpGetGravity(&gravity, &quat);
    mpu6050.dmpGetYawPitchRoll(ypr, &quat, &gravity);
    mpu6050.dmpGetAccel(&accel, packetBuffer);
    mpu6050.dmpGetLinearAccel(&linearAccel, &accel, &gravity);

    // The unit for yaw, pitch, and roll measurements is tenths of a degree.
    // Yaw is normalized to 0-359.9 degrees.
    updateMovingAverage(maSlotYaw  , (ypr[0] >= 0 ? ypr[0] : ypr[0] + 2 * M_PI) * (float) 1800 / M_PI);
    updateMovingAverage(maSlotPitch, ypr[1] * (float) 1800 / M_PI);
    updateMovingAverage(maSlotRoll , ypr[2] * (float) 1800 / M_PI);

    updateMovingAverage(maSlotGyroX, gyro.x);
    updateMovingAverage(maSlotGyroY, gyro.y);
    updateMovingAverage(maSlotGyroZ, gyro.z);

#ifdef INCLUDE_ACCEL_DATA
    updateMovingAverage(maSlotAccelX, accel.x);
    updateMovingAverage(maSlotAccelY, accel.y);
    updateMovingAverage(maSlotAccelZ, accel.z);
#endif

#ifdef INCLUDE_LINEAR_ACCEL_DATA
    updateMovingAverage(maSlotLinearAccelX, linearAccel.x);
    updateMovingAverage(maSlotLinearAccelY, linearAccel.y);
    updateMovingAverage(maSlotLinearAccelZ, linearAccel.z);
#endif

    // If we got any non-zero quaternion or gyro data (which come directly
    // from the packet), communication with the MPU-6050 is probably working.
    if (quat.w != 0 || quat.x != 0 || quat.y != 0 || quat.z != 0
        || gyro.x != 0 || gyro.y != 0 || gyro.z != 0)
    {
///      lastSuccessfulMpu6050ReadMs = now;
      wdt_reset();
    }

    if ((abs(getMovingAverage(maSlotGyroX)) > movementDetectionThreshold)
        || (abs(getMovingAverage(maSlotGyroY)) > movementDetectionThreshold)
        || (abs(getMovingAverage(maSlotGyroZ)) > movementDetectionThreshold))
    {
      isImuActive = true;
      lastMotionDetectedMs = now;
    }
    else {
      isImuActive = false;
    }

//#ifdef ENABLE_DEBUG_PRINT
//      // Careful:  We might not be able to keep up if this debug print is enabled.
//    Serial.print("ypr:  ");
//    Serial.print(ypr[0]);
//    Serial.print(", ");
//    Serial.print(ypr[1]);
//    Serial.print(", ");
//    Serial.print(ypr[2]);
//    Serial.print("    gyro:  ");
//    Serial.print(gyro.x);
//    Serial.print(", ");
//    Serial.print(gyro.y);
//    Serial.print(", ");
//    Serial.print(gyro.z);
//    Serial.print("    accel:  ");
//    Serial.print(accel.x);
//    Serial.print(", ");
//    Serial.print(accel.y);
//    Serial.print(", ");
//    Serial.print(accel.z);
//    Serial.print("    linear accel:  ");
//    Serial.print(linearAccel.x);
//    Serial.print(", ");
//    Serial.print(linearAccel.y);
//    Serial.print(", ");
//    Serial.println(linearAccel.z);
//#endif
  }
}


void processMpu6050Interrupt(uint32_t now)
{
  static bool needClearMpu6050Fifo;
  uint16_t fifoCount;

  uint8_t mpu6050IntStatus = mpu6050.getIntStatus();
//#ifdef ENABLE_DEBUG_PRINT
//  Serial.print("0x");
//  Serial.print((int) mpu6050IntStatus, HEX);
//  Serial.print(" ");
//#endif

  // Frequently, the interrupt status is zero by the time we're processing the
  // interrupt.  Why that happens has not yet been determined but is probably
  // due to multiple interrupts arriving before the first is handled.  If the
  // status is zero, there's nothing we can do because we don't know what the
  // interrupt was for (or if it even still needs to be handled).
  if (mpu6050IntStatus == 0) {
    return;
  }

  switch (mpu6050Mode) {

    case Mpu6050Mode::init:
      // Don't do anything because the MPU isn't ready yet.
      break;

    case Mpu6050Mode::cycle:
      if (mpu6050IntStatus & 0x40) {
        setMpu6050Mode(Mpu6050Mode::normal, now);
      }
      break;

    case Mpu6050Mode::normal:

      fifoCount = mpu6050.getFIFOCount();

      // Check if FIFO overflowed.  If it did, clear it, then wait for another
      // data-ready interrupt and clear the FIFO again so that we are back in
      // sync (i.e., any partial packets have been cleared out).  Based on some
      // brief testing, it appears that bits 0 and 1 always appear set together.
      if (mpu6050IntStatus & 0x10) {
#ifdef ENABLE_DEBUG_PRINT
        Serial.print(F("*** FIFO overflow!  fifoCount is "));
        Serial.println(fifoCount);
#endif
        clearMpu6050Fifo();
        // Clear the FIFO again after next interrupt to make sure we're in sync.
        needClearMpu6050Fifo = true;
        return;
      }

      // The MPU6050 register map document says that bit 0 indicates data ready
      // and bit 1 is reserved.  However, the I2C data analyzer dump from Jeff
      // Rowberg found at https://www.i2cdevlib.com/tools/analyzer/1 shows that
      // bit 0 indicates raw data ready and bit 1 indicates DMP data ready.
      if (!(mpu6050IntStatus & 0x02)) {
#ifdef ENABLE_DEBUG_PRINT
        Serial.print(F("Got interrupt but not for data ready.  mpu6050IntStatus=0x"));
        Serial.print((int) mpu6050IntStatus, HEX);
        Serial.print(F(", fifoCount="));
        Serial.println(fifoCount);
#endif
        return;
      }

      if (needClearMpu6050Fifo) {
        needClearMpu6050Fifo = false;
        clearMpu6050Fifo();
        return;
      }

      // If we've missed retrieving more than a few packets in time, the FIFO
      // may overflow (if it hasn't already), causing data corruption.  We need
      // to clear it now to avoid getting bad data.
      if (fifoCount > packetSize * maxPacketsInMpu6050FifoBeforeForcedClear) {
#ifdef ENABLE_DEBUG_PRINT
        Serial.print(F("*** Missed too many packets.  fifoCount="));
        Serial.println(fifoCount);
#endif
        clearMpu6050Fifo();
        return;
      }

      // If the FIFO length is not a multiple of the packet size, there is a
      // partial packet in the FIFO, either due to the FIFO being filled right
      // now or due to some sort of FIFO corruption.  Just to be safe, we'll
      // clear the FIFO to avoid getting bad data.
      if (fifoCount % packetSize != 0) {
#ifdef ENABLE_DEBUG_PRINT
        Serial.print(F("*** Partial packet in FIFO.  fifoCount="));
        Serial.println(fifoCount);
#endif
        clearMpu6050Fifo();
        // Clear the FIFO again after next interrupt to make sure we're in sync.
        needClearMpu6050Fifo = true;
        return;
      }

//#ifdef ENABLE_DEBUG_PRINT
//      Serial.print(F("Got data ready interrupt 0x"));
//      Serial.print((int) mpu6050IntStatus, HEX);
//      Serial.print(F(", fifoCount="));
//      Serial.println(fifoCount);
//#endif
      gatherMotionMeasurements(now);
      break;
  }
}


#ifdef ENABLE_SOUND

void sampleSound()
{
  uint16_t soundSample = analogRead(MIC_SIGNAL_PIN);
  if (soundSample < minSoundSample) {
    minSoundSample = soundSample;
  }
  if (soundSample > maxSoundSample) {
    maxSoundSample = soundSample;
  }
//#ifdef ENABLE_DEBUG_PRINT
//    Serial.print(F("soundSample="));
//    Serial.print(soundSample);
//    Serial.print(F(" minSoundSample="));
//    Serial.print(minSoundSample);
//    Serial.print(F(" maxSoundSample="));
//    Serial.println(maxSoundSample);
//#endif
}


void saveSoundPeakToPeak(uint32_t now)
{
  int16_t pp = maxSoundSample - minSoundSample;
  updateMovingAverage(maSlotPpSound, pp);

  int16_t avgPp = getMovingAverage(maSlotPpSound);
  isSoundActive = avgPp > activeSoundThreshold;

//#ifdef ENABLE_DEBUG_PRINT
//    Serial.print(F("minSoundSample="));
//    Serial.print(minSoundSample);
//    Serial.print(F(" maxSoundSample="));
//    Serial.println(maxSoundSample);
//    Serial.print(F(" pp="));
//    Serial.println(pp);
//    Serial.print(F(" avgPp="));
//    Serial.println(avgPp);
//#endif

  maxSoundSample = 0;
  minSoundSample = UINT16_MAX;
}

#endif


void sendMeasurements()
{
#ifdef ENABLE_DEBUG_PRINT
    Serial.println(F("send"));
#endif

#ifdef TX_INDICATOR_LED_PIN
  digitalWrite(TX_INDICATOR_LED_PIN, TX_INDICATOR_LED_ON);
#endif

  for (int i = 0; i < numMaSets; ++i) {
    payload.measurements[i] = getMovingAverage(i);
  }
  payload.widgetHeader.isActive = widgetMode == WidgetMode::active;

//#ifdef ENABLE_DEBUG_PRINT
//  for (int i = 0; i < numMaSets; ++i) {
//    Serial.print(i);
//    Serial.print(":  ");
//    Serial.println(payload.measurements[i]);
//  }
//#endif

#ifdef ENABLE_LCD_16x2
  // 0123456789012345
  // -ddd.d-dd.d-dd.d
  // -ddd.d-ddd.dxF
  char buf[17];
  lcd.setCursor(0, 0);
  lcd.print(dtostrf(getMovingAverage(maSlotYaw) / 10.0, 6, 1, buf));
  lcd.print(dtostrf(getMovingAverage(maSlotPitch) / 10.0, 5, 1, buf));
  lcd.print(dtostrf(getMovingAverage(maSlotRoll) / 10.0, 5, 1, buf));
  lcd.setCursor(0, 1);
  lcd.print(dtostrf(getMovingAverage(maSlotGyroZ) / 10.0, 6, 1, buf));
  lcd.print(dtostrf(getMovingAverage(maSlotTemperature) / 10.0, 6, 1, buf));
  lcd.print((char) 223);    // degree symbol
  lcd.print("F");
#endif

//#ifdef ENABLE_DEBUG_PRINT
//    Serial.println(F("Calling radio.write."));
//#endif
  if (!radio.write(&payload, sizeof(WidgetHeader) + sizeof(int16_t) * numMaSets, !WANT_ACK)) {
#ifdef ENABLE_DEBUG_PRINT
    Serial.println(F("radio.write failed."));
#endif
  }
  else {
#ifdef ENABLE_DEBUG_PRINT
    Serial.println(F("radio.write succeeded."));
#endif
  }

#ifdef TX_INDICATOR_LED_PIN
  digitalWrite(TX_INDICATOR_LED_PIN, TX_INDICATOR_LED_OFF);
#endif
}


void loop()
{
  static uint32_t inactiveStartMs;

  uint32_t now = millis();

#ifdef NO_COMPILE
  // We need to reset the IMU if we are awake and haven't received any
  // data from it for a while (because it has probably gone out to lunch).
  if (now - lastSuccessfulMpu6050ReadMs >= MPU6050_ASSUMED_DEAD_TIMEOUT_MS) {
#ifdef ENABLE_DEBUG_PRINT
    Serial.print(F("*** MPU-6050 assumed dead.  Reinitializing..."));
#endif
    mpu6050Mode = Mpu6050Mode::init;
    initMpu6050();
    // lastMotionDetectedMs ends up with the current value returned by
    // millis() when initMpu6050 calls setMpu6050Mode.  Since initializaing the
    // MPU-6050 likely took a millisecond or more, we need to fix the
    // value of lastMotionDetectedMs so that it isn't in the future.
    lastMotionDetectedMs = now;
  }
#endif

  if (gotMpu6050Interrupt) {
    gotMpu6050Interrupt = false;
    processMpu6050Interrupt(now);
  }

  if (now - lastTemperatureSampleMs >= TEMPERATURE_SAMPLE_INTERVAL_MS) {
    lastTemperatureSampleMs = now;
    gatherTemperatureMeasurement();
  }

#ifdef ENABLE_SOUND
  if (now - lastSoundSampleMs >= SOUND_SAMPLE_INTERVAL_MS) {
    lastSoundSampleMs = now;
    sampleSound();
  }

  if (now - lastSoundSaveMs >= SOUND_SAVE_INTERVAL_MS) {
    lastSoundSaveMs = now;
    saveSoundPeakToPeak(now);
  }
#endif

  bool isActive = false;
#if defined(ACTIVATE_WITH_MOVEMENT)
  isActive |= isImuActive;
#endif
#if defined(ACTIVATE_WITH_SOUND)
  isActive |= isSoundActive;
#endif
  if (isActive) {
    if (widgetMode == WidgetMode::inactive) {
      setWidgetMode(WidgetMode::active, now);
      inactiveStartMs = 0;
    }
  }
  else {
    if (widgetMode == WidgetMode::active) {
      if (inactiveStartMs == 0) {
        inactiveStartMs = now;
      }
      else if (now - inactiveStartMs >= inactiveTransitionDelayMs) {
        setWidgetMode(WidgetMode::inactive, now);
      }
    }
  }

  if ((int32_t) (now - nextTxMs) >= 0) {
    nextTxMs = now + txInterval;
    sendMeasurements();
  }

  if (widgetMode == WidgetMode::inactive
      && mpu6050Mode == Mpu6050Mode::normal
      && now - lastMotionDetectedMs >= MOVEMENT_TIMEOUT_FOR_SLEEP_MS)
  {
#ifdef ENABLE_DEBUG_PRINT
    Serial.print(F("Going standby because no motion from "));
    Serial.print(lastMotionDetectedMs);
    Serial.print(F(" to "));
    Serial.println(now);
#endif
    setWidgetMode(WidgetMode::standby, now);
    // Setting the widget mode to standby will put the processor to sleep.
    // It wakes when it gets a motion detection interrupt from the MPU-6050
    // or an interrupt from the vibration sensor.  Sometime after that,
    // setWidgetMode returns, and execution resumes here.  The world may be
    // a different place then.  Just thought you should know.
  }
}
