skipzone/Illumicone/boneyard/Widget_ContortOMatic.ino

/*****************************************************************
 *                                                               *
 * Contort-O-Matic Widget                                        *
 *                                                               *
 * Platform:  Arduino Mega 2560                                  *
 *                                                               *
 * by Ross Butler, June 2017                                 )'( *
 *                                                               *
 *****************************************************************/

/*
    This file is part of Illumicone.

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
    You should have received a copy of the GNU General Public License
    along with Illumicone.  If not, see <http://www.gnu.org/licenses/>.
*/

//#define ENABLE_DEBUG_PRINT

#include <ADCTouch.h>
#include "illumiconeWidget.h"

#ifdef ENABLE_DEBUG_PRINT
#include "printf.h"
#endif


/************************
 * Widget Configuration *
 ************************/

constexpr uint8_t widgetId = 9;

constexpr uint32_t activeTxIntervalMs = 333L;
constexpr uint32_t inactiveTxIntervalMs = 1000L;
constexpr uint32_t gatherMeasurementsIntervalMs = 167L;
constexpr uint32_t noChangeRecalibrationIntervalMs = 15L * 1000L;
constexpr uint32_t inactiveRecalibrationIntervalMs = 60L * 1000L;

constexpr uint8_t numCapSensePins = 16;
constexpr uint8_t capSensePins[numCapSensePins] = {A0, A1, A2, A3, A4, A5, A6, A7, A8, A9, A10, A11, A12, A13, A14, A15};
constexpr int capSenseNumSamplesForRef = 500;
constexpr int capSenseNumSamples = 10;
constexpr int capSenseThresholds[numCapSensePins] = { 20,  20,  20,  20,
                                                      20,  20,  20,  20,
                                                      20,  20,  20,  20,
                                                      20,  20,  20,  20};

// ---------- radio configuration ----------

// Nwdgt, where N indicates the payload type (0: stress test; 1: position
// and velocity; 2: measurement vector; 3,4: undefined; 5: custom)
#define TX_PIPE_ADDRESS "5wdgt"

// Set WANT_ACK to false, TX_RETRY_DELAY_MULTIPLIER to 0, and TX_MAX_RETRIES
// to 0 for fire-and-forget.  To enable retries and delivery failure detection,
// set WANT_ACK to true.  The delay between retries is 250 us multiplied by
// TX_RETRY_DELAY_MULTIPLIER.  To help prevent repeated collisions, use 1, a
// prime number (2, 3, 5, 7, 11, 13), or 15 (the maximum) for TX_MAX_RETRIES.
#define WANT_ACK false
#define TX_RETRY_DELAY_MULTIPLIER 0     // use 15 when getting acks
#define TX_MAX_RETRIES 0                // use 15 when getting acks

// Possible data rates are RF24_250KBPS, RF24_1MBPS, or RF24_2MBPS.  (2 Mbps
// works with genuine Nordic Semiconductor chips only, not the counterfeits.)
#define DATA_RATE RF24_250KBPS

// Valid CRC length values are RF24_CRC_8, RF24_CRC_16, and RF24_CRC_DISABLED
#define CRC_LENGTH RF24_CRC_16

// nRF24 frequency range:  2400 to 2525 MHz (channels 0 to 125)
// ISM: 2400-2500;  ham: 2390-2450
// WiFi ch. centers: 1:2412, 2:2417, 3:2422, 4:2427, 5:2432, 6:2437, 7:2442,
//                   8:2447, 9:2452, 10:2457, 11:2462, 12:2467, 13:2472, 14:2484
#define RF_CHANNEL 84

// RF24_PA_MIN = -18 dBm, RF24_PA_LOW = -12 dBm, RF24_PA_HIGH = -6 dBm, RF24_PA_MAX = 0 dBm
#define RF_POWER_LEVEL RF24_PA_MAX


/***********
 * Globals *
 ***********/

RF24 radio(7, 8);    // Mega:  CE on pin 7, CSN on pin 8, also uses SPI bus (SCK on 52, MISO on 50, MOSI on 51)

ContortOMaticTouchDataPayload touchDataPayload;
ContortOMaticCalibrationDataPayload calibrationDataPayload;

static int capSenseReferenceValues[numCapSensePins];
static bool padIsTouched[numCapSensePins];
static bool padWasTouched[numCapSensePins];

static bool isActive;
static bool wasActive;
static uint32_t nextGatherMeasurementsMs;
static uint32_t nextTxMs;
static uint32_t nextNoChangeRecalibrationMs;
static uint32_t nextInactiveRecalibrationMs;


/******************
 * Implementation *
 ******************/

void calibrateCapSense()
{
  Serial.println(F("Calibrating..."));
  
  for (uint8_t i = 0; i < numCapSensePins; ++i) {
    // Create reference value to account for stray
    // capacitance and capacitance of the pad.
    capSenseReferenceValues[i] = ADCTouch.read(capSensePins[i], capSenseNumSamplesForRef);
  }

#ifdef ENABLE_DEBUG_PRINT
  Serial.println(F("---------- Calibration Values ----------"));
  for (byte i = 0; i < numCapSensePins; ++i) {
    Serial.print(i);
    Serial.print(":  ");
    Serial.println(capSenseReferenceValues[i]);
  }
#endif

  // Send the calibration data to widgetRcvr for logging.
  calibrationDataPayload.widgetHeader.isActive = isActive;
  uint8_t capSensePinNum = 0;
  uint8_t setNum = 0;
  uint8_t payloadValueIdx = 0;
  while (capSensePinNum < numCapSensePins) {
    calibrationDataPayload.capSenseReferenceValues[payloadValueIdx++] = capSenseReferenceValues[capSensePinNum++];
    if (payloadValueIdx == 8) {
      calibrationDataPayload.setNum = setNum;
      sendPayload(&calibrationDataPayload, sizeof(calibrationDataPayload));
      ++setNum;
      payloadValueIdx = 0; 
    }
  }
}


void gatherMeasurements()
{
  int capSenseValues[numCapSensePins];

  for (uint8_t i = 0; i < numCapSensePins; ++i) {
    capSenseValues[i] = ADCTouch.read(capSensePins[i], capSenseNumSamples);
  }

  // Figure out which pads are being touched and if there have been any touch changes.
  isActive = false;
  bool touchedSetChanged = false;
  for (uint8_t i = 0; i < numCapSensePins; ++i) {
    int netValue = capSenseValues[i] - capSenseReferenceValues[i];
    if (netValue > capSenseThresholds[i]) {
      padIsTouched[i] = true;
      isActive = true;
    }
    else {
      padIsTouched[i] = false;
    }
    if (padWasTouched[i] != padIsTouched[i]) {
      padWasTouched[i] = padIsTouched[i];
      touchedSetChanged = true;
    }

#ifdef ENABLE_DEBUG_PRINT
    Serial.print(i);
    Serial.print(":  ");
    Serial.print(capSenseValues[i]);
    Serial.print(" - ");
    Serial.print(capSenseReferenceValues[i]);
    Serial.print(" = ");
    Serial.print(netValue);
    Serial.print(" >? ");
    Serial.print(capSenseThresholds[i]);
    Serial.print(" -> ");
    Serial.println(padIsTouched[i]);
#endif
  }

  // Adjust the transmission and auto-recalibration times if necessary.
  uint32_t now = millis();
  if (isActive) {
    if (!wasActive) {
      // Just went active, so transmit ASAP.
      nextTxMs = now;
    }
    if (touchedSetChanged) {
      nextNoChangeRecalibrationMs = now + noChangeRecalibrationIntervalMs;
    }
  }
  else {
    if (wasActive) {
      nextInactiveRecalibrationMs = now + inactiveRecalibrationIntervalMs;
    }
  }
  wasActive = isActive;
}


void sendMeasurements()
{
  // Put the patIsTouched data into the payload's bitfield, with element 0 in the low-order bit.
  touchDataPayload.padIsTouchedBitfield = 0;
  for (int i = numCapSensePins - 1; i >= 0; --i) {
    touchDataPayload.padIsTouchedBitfield = (touchDataPayload.padIsTouchedBitfield << 1) | padIsTouched[i];
  }

  touchDataPayload.widgetHeader.isActive = isActive;

  sendPayload(&touchDataPayload, sizeof(touchDataPayload));
}


void sendPayload(const void* payload, uint8_t payloadLength)
{
  if (!radio.write(payload, payloadLength)) {
#ifdef ENABLE_DEBUG_PRINT
    Serial.println(F("radio.write failed."));
#endif
  }
  else {
#ifdef ENABLE_DEBUG_PRINT
    Serial.println(F("radio.write succeeded."));
#endif
  }
}


void setup()
{
#ifdef ENABLE_DEBUG_PRINT
  Serial.begin(115200);
  printf_begin();
#endif

  configureRadio(radio, TX_PIPE_ADDRESS, WANT_ACK, TX_RETRY_DELAY_MULTIPLIER,
                 TX_MAX_RETRIES, CRC_LENGTH, RF_POWER_LEVEL, DATA_RATE,
                 RF_CHANNEL);
  
  touchDataPayload.widgetHeader.id = widgetId;
  touchDataPayload.widgetHeader.channel = 0;              // channel 0 carries touch data payloads

  calibrationDataPayload.widgetHeader.id = widgetId;
  calibrationDataPayload.widgetHeader.channel = 1;        // channel 1 carries calibration data payloads

  uint32_t now = millis();
  nextGatherMeasurementsMs = now;
  nextTxMs = now;
  nextNoChangeRecalibrationMs = now + noChangeRecalibrationIntervalMs;
  nextInactiveRecalibrationMs = now + inactiveRecalibrationIntervalMs;

  calibrateCapSense();
}


void loop()
{
  uint32_t now = millis();

  if ((int32_t) (now - nextGatherMeasurementsMs) >= 0) {
    nextGatherMeasurementsMs = now + gatherMeasurementsIntervalMs;
    gatherMeasurements();
  }

  if ((int32_t) (now - nextTxMs) >= 0) {
    nextTxMs = now + (isActive ? activeTxIntervalMs : inactiveTxIntervalMs);
    sendMeasurements();
  }

  if ((isActive && (int32_t) (now - nextNoChangeRecalibrationMs) >= 0)
      || (!isActive && (int32_t) (now - nextInactiveRecalibrationMs) >= 0))
  {
    calibrateCapSense();
    nextNoChangeRecalibrationMs = now + noChangeRecalibrationIntervalMs;
    nextInactiveRecalibrationMs = now + inactiveRecalibrationIntervalMs;
  }
}
