skipzone/Illumicone/src/SpiralPattern.cpp

/*
    This file is part of Illumicone.

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
    You should have received a copy of the GNU General Public License
    along with Illumicone.  If not, see <http://www.gnu.org/licenses/>.
*/

#include <cmath>

#include <errno.h>

#include "ConfigReader.h"
#include "illumiconePixelUtility.h"
#include "illumiconeUtility.h"
#include "Log.h"
#include "Pattern.h"
#include "SpiralPattern.h"
#include "Widget.h"
#include "WidgetChannel.h"

using namespace std;


extern Log logger;


SpiralPattern::SpiralPattern(const std::string& name)
    : Pattern(name)
{
}


bool SpiralPattern::initPattern(std::map<WidgetId, Widget*>& widgets)
{
    // ----- get input channels -----

    std::vector<Pattern::ChannelConfiguration> channelConfigs = getChannelConfigurations(widgets);
    if (channelConfigs.empty()) {
        logger.logMsg(LOG_ERR, "No valid widget channels are configured for " + name + ".");
        return false;
    }

    for (auto&& channelConfig : channelConfigs) {

        if (channelConfig.inputName == "compression") {
            compressionChannel = channelConfig.widgetChannel;
        }
        else if (channelConfig.inputName == "rotation") {
            rotationChannel = channelConfig.widgetChannel;
        }
        else if (channelConfig.inputName == "color") {
            colorChannel = channelConfig.widgetChannel;
        }
        else {
            logger.logMsg(LOG_WARNING, "inputName '" + channelConfig.inputName
                + "' in input configuration for " + name + " is not recognized.");
            continue;
        }
        logger.logMsg(LOG_INFO, name + " using " + channelConfig.widgetChannel->getName() + " for " + channelConfig.inputName);

        if (channelConfig.measurement != "position") {
            logger.logMsg(LOG_WARNING, name + " supports only position measurements, but the input configuration for "
                + channelConfig.inputName + " doesn't specify position.");
        }
    }


    // ----- get pattern configuration -----

    string errMsgSuffix = " in " + name + " pattern configuration.";

    // -- spiral --

    if (!ConfigReader::getBoolValue(patternConfigObject, "flipSpring", flipSpring, errMsgSuffix)) {
        return false;
    }
    logger.logMsg(LOG_INFO, name + " flipSpring=" + to_string(flipSpring));

    if (!ConfigReader::getFloatValue(patternConfigObject, "spiralTightnessFactor", spiralTightnessFactor, errMsgSuffix)) {
        return false;
    }
    logger.logMsg(LOG_INFO, name + " spiralTightnessFactor=" + to_string(spiralTightnessFactor));

    if (!ConfigReader::getFloatValue(patternConfigObject, "progressiveSpringFactor", progressiveSpringFactor, errMsgSuffix)) {
        return false;
    }
    logger.logMsg(LOG_INFO, name + " progressiveSpringFactor=" + to_string(progressiveSpringFactor));

    if (!ConfigReader::getFloatValue(patternConfigObject, "progressiveSpringCompressionResponseFactor", progressiveSpringCompressionResponseFactor, errMsgSuffix)) {
        return false;
    }
    logger.logMsg(LOG_INFO, name + " progressiveSpringCompressionResponseFactor=" + to_string(progressiveSpringCompressionResponseFactor));

    // -- compression --

    if (compressionChannel != nullptr) {

        if (!compressionMeasmtMapper.readConfig(patternConfigObject, "compressionMeasurementMapper", errMsgSuffix)) {
            return false;
        }

        if (!ConfigReader::getIntValue(patternConfigObject, "compressionResetTimeoutSeconds", compressionResetTimeoutSeconds, errMsgSuffix)) {
            return false;
        }
        logger.logMsg(LOG_INFO, name + " compressionResetTimeoutSeconds=" + to_string(compressionResetTimeoutSeconds));

        compressionTriangleAmplitude = maxCyclicalCompression - minCyclicalCompression;
        compressionTrianglePeriod = compressionTriangleAmplitude * 2;
    }


    // -- rotation --

    if (rotationChannel != nullptr) {
        if (!rotationMeasmtMapper.readConfig(patternConfigObject, "rotationMeasurementMapper", errMsgSuffix)) {
            return false;
        }
    }


    // -- color --

    if (colorChannel != nullptr) {
        if (!colorMeasmtMapper.readConfig(patternConfigObject, "colorMeasurementMapper", errMsgSuffix)) {
            return false;
        }
    }


    // ----- initialize object data -----

    nextResetCompressionMs = 0;
    resetCompression = true;
    //compressionPos = compressionDivisor;
    compressionFactor = 1;      // TODO: need to flag it as invalid until we actually get a good measurement
    nextRotationStepMs = 0;
    rotationStepIntervalMs = 0;
    rotationOffset = 0;
    rotateCounterclockwise = false;
    currentHue = 0;

    return true;
}


bool SpiralPattern::update()
{
    isActive = false;
    bool gotUpdateFromWidget = false;
    unsigned int nowMs = getNowMs();

//    // Get any updated rotation.
//    if (rotationChannel != nullptr) {
//        if (rotationChannel->getIsActive()) {
//            isActive = true;
//            if (rotationChannel->getHasNewPositionMeasurement()) {
//                gotUpdateFromWidget = true;
//                rPos = ((unsigned int) rotationChannel->getPosition()) % pixelsPerString;
//            }
//        }
//    }

    // TODO:  The next two blocks do the same thing but with different data.
    //        Implement in one function.

    // Get an updated compression, if available.
    if (compressionChannel != nullptr) {
        if (compressionChannel->getIsActive()) {
            isActive = true;
            if (compressionChannel->getHasNewPositionMeasurement()) {
                int rawCompressionPos = compressionChannel->getPosition();
                if (compressionMeasmtMapper.mapMeasurement(rawCompressionPos, compressionFactor)) {
                    gotUpdateFromWidget = true;
                    if (resetCompression) {
                        resetCompression = false;
                        compressionPosOffset = rawCompressionPos;
                    }
                    //logger.logMsg(LOG_DEBUG, "%s:  rawCompressionPos=%d compressionPosOffset=%d compressionFactor=%f",
                    //              name.c_str(), rawCompressionPos, compressionPosOffset, compressionFactor);
                }

                // TODO:  Put back in cyclical measurement support.
                /*
                compressionPos = (rawCompressionPos - compressionPosOffset) / compressionScaleFactor;
                if (maxCyclicalCompression != 0) {
                    // This is a triangle wave function where the height of the triangle (peak-to-peak
                    // amplitude of the waveform) is maxCyclicalCompression - minCyclicalCompression,
                    // and the width of the base (waveform period) is twice the height.   The waveform
                    // is offset from zero (DC offset) by minCyclicalCompression.  We left-shift the
                    // wave so that compressionPos starts out at minCyclicalCompression.
                    int singleCycleX = abs(compressionPos + compressionTriangleAmplitude) % compressionTrianglePeriod;
                    //logger.logMsg(LOG_DEBUG, name + ":  compressionTriangleAmplitude=" + to_string(compressionTriangleAmplitude)
                    //                  + ", compressionTrianglePeriod=" + to_string(compressionTrianglePeriod)
                    //                  + ", singleCycleX=" + to_string(singleCycleX));
                    compressionPos = abs(singleCycleX - compressionTriangleAmplitude) + minCyclicalCompression;
                }
// TODO:  make sure that the cyclical stuff isn't dependent on this check
//                if (compressionPos < 1) {
//                    compressionPos = 1;
//                }
                logger.logMsg(LOG_DEBUG, name + ":  rawCompressionPos=" + to_string(rawCompressionPos)
                                  + ", compressionPosOffset=" + to_string(compressionPosOffset)
                                  + ", compressionPos=" + to_string(compressionPos));
                */

            }
        }
    }

    // Get an updated rotation step interval, if available.
    if (rotationChannel != nullptr) {
        if (rotationChannel->getIsActive()) {
            isActive = true;
            if (rotationChannel->getHasNewPositionMeasurement()) {
                int rawRotationPos = rotationChannel->getPosition();
                if (rotationMeasmtMapper.mapMeasurement(rawRotationPos, rotationStepIntervalMs)) {
                    gotUpdateFromWidget = true;
                    rotateCounterclockwise = (rawRotationPos >= 0);
                    //logger.logMsg(LOG_DEBUG, name + ":  rawRotationPos=" + to_string(rawRotationPos)
                    //                  + ", rotateCounterclockwise=" + to_string(rotateCounterclockwise)
                    //                  + ", rotationStepIntervalMs=" + to_string(rotationStepIntervalMs)
                    //                  + ", rotationOffset=" + to_string(rotationOffset));
                }
            }
        }
        else {
            rotationStepIntervalMs = 0;
        }
    }

    // Get an updated color, if available.
    if (colorChannel != nullptr) {
        if (colorChannel->getIsActive()) {
            isActive = true;
            if (colorChannel->getHasNewPositionMeasurement()) {
                int rawColorPos = colorChannel->getPosition();
                int colorSteps;
                if (colorMeasmtMapper.mapMeasurement(rawColorPos, colorSteps)) {
                    gotUpdateFromWidget = true;
                    currentHue += colorSteps;
                    //logger.logMsg(LOG_DEBUG, name + ":  rawColorPos=" + to_string(rawColorPos)
                    //                  + ", colorSteps=" + to_string(colorSteps)
                    //                  + ", currentHue=" + to_string(currentHue));
                }
            }
        }
    }


    // Set flag to force compression back to 1 when compression channel
    // has been inactive for compressionResetTimeoutSeconds.
    if (isActive) {
        nextResetCompressionMs = 0;
    }
    else {
        if (nextResetCompressionMs == 0) {
            nextResetCompressionMs = nowMs + compressionResetTimeoutSeconds * 1000;
        }
        else if (!resetCompression && (int) (nowMs - nextResetCompressionMs) >= 0) {
            //logger.logMsg(LOG_DEBUG, name + ":  Resetting compression.");
            resetCompression = true;
            compressionPos = 1;
        }
    }


    // Rotate a step if we have a valid interval measurement and it is time to rotate one step.
    if (rotationStepIntervalMs != 0) {
        if (nextRotationStepMs == 0) {
            nextRotationStepMs = nowMs + rotationStepIntervalMs;
        }
        else {
            if ((int) (nowMs - nextRotationStepMs) >= 0) {
                nextRotationStepMs = nowMs + rotationStepIntervalMs;
                if (rotateCounterclockwise) {
                    rotationOffset += 2;
                    if ((unsigned int) rotationOffset >= numStrings) {
                        rotationOffset = 0;
                    }
                }
                else {
                    rotationOffset -= 2;
                    if (rotationOffset < 0) {
                        rotationOffset = numStrings - 1;
                    }
                }
            }
        }
    }


    // Draw.

    if (gotUpdateFromWidget) {

        clearAllPixels(pixelArray);

        CHSV hsvCurrentColor((uint8_t) currentHue, 255, 255);
        CRGB rgbCurrentColor;
        hsv2rgb(hsvCurrentColor, rgbCurrentColor);

        unsigned int heightInPixels = (1.0 / compressionFactor) * (float) pixelsPerString;
        unsigned int startingPixelOffset = (heightInPixels <= pixelsPerString) ? pixelsPerString - heightInPixels : 0;

        // Range of y is [0..1].
        float xStep = 1.0 / numStrings;
        float x = 0.0;
        for (unsigned int i = 0; i < numStrings * heightInPixels; ++i) {

            errno = 0;
            float y = ::powf(x / spiralTightnessFactor,
                                progressiveSpringFactor + progressiveSpringCompressionResponseFactor * compressionFactor);
            //if (compressionFactor < 1.0) {
            //    logger.logMsg(LOG_DEBUG, name + ":  x=" + to_string(x) + " y=" + to_string(y));
            //}
            if (errno != 0) {
                logger.logMsg(LOG_ERR, errno,
                          name + ":  powf indicated an error for "
                               + " x=" + to_string(x)
                               + " spiralTightnessFactor=" + to_string(spiralTightnessFactor)
                               + " progressiveSpringFactor=" + to_string(progressiveSpringFactor)
                               + " progressiveSpringCompressionResponseFactor=" + to_string(progressiveSpringCompressionResponseFactor)
                               + " compressionFactor=" + to_string(compressionFactor)
                               + " exp=" + to_string(progressiveSpringFactor
                                                     + progressiveSpringCompressionResponseFactor * compressionFactor));
            }
            if (y > 1.0) {
                break;
            }

            unsigned int stringIdx = ((unsigned int) (x / xStep) + rotationOffset) % numStrings;
            unsigned int pixelIdx;
            if (flipSpring) {
                pixelIdx = (uint32_t) ((1.0 - y) * (float) heightInPixels + (float) startingPixelOffset);
            }
            else {
                pixelIdx = (uint32_t) (y * (float) heightInPixels + (float) startingPixelOffset);
            }
            //if (compressionFactor < 1.0) {
            //    //logger.logMsg(LOG_DEBUG, name + ":  stringIdx=" + to_string(stringIdx) + " pixelIdx=" + to_string(pixelIdx));
            //    logger.logMsg(LOG_DEBUG, name + ":  x=" + to_string(x) + " y=" + to_string(y) + " pixelIdx=" + to_string(pixelIdx) + " startingPixelOffset=" + to_string(startingPixelOffset) + " heightInPixels=" + to_string(heightInPixels));
            //}

            if (stringIdx < numStrings) {
                // When the spiral is stretched, make sure we're
                // setting a pixel within the physical bounds.
                if (pixelIdx < pixelsPerString) {
                    pixelArray[stringIdx][pixelIdx] = rgbCurrentColor;
                }
                // TODO:  Make width configurable and re-enable this.

                // Quick hack to make the spring line wider by turning on adjacent pixels.
                if (pixelIdx > 0 && pixelIdx <= pixelsPerString) {
                    pixelArray[stringIdx][pixelIdx - 1] = rgbCurrentColor;
                }
                if (pixelIdx + 1 < pixelsPerString) {
                    pixelArray[stringIdx][pixelIdx + 1] = rgbCurrentColor;
                }

            }

            x += xStep;
        }
    }

    return isActive;
}
