skipzone/Illumicone/src/RgbStripePattern.cpp

/*
    This file is part of Illumicone.

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
    You should have received a copy of the GNU General Public License
    along with Illumicone.  If not, see <http://www.gnu.org/licenses/>.
*/

#include <iostream>

#include "ConfigReader.h"
#include "illumiconePixelUtility.h"
#include "illumiconeUtility.h"
#include "Log.h"
#include "Pattern.h"
#include "RgbStripePattern.h"
#include "Widget.h"
#include "WidgetChannel.h"

using namespace std;


extern Log logger;


constexpr char RgbStripePattern::rgbPrefix[];
constexpr char RgbStripePattern::orientationPrefix[];


RgbStripePattern::RgbStripePattern(const std::string& name)
    : Pattern(name)
    , vPixelsPerString(pixelsPerString)
    , numVStrings(numStrings)
    , horizontalVPixelRatio(1)
    , verticalVPixelRatio(1)
{
    numPixelsForOrientation[horiz] = numStrings;
    numPixelsForOrientation[vert] = pixelsPerString;
    numVPixelsForOrientation[horiz] = vPixelsPerString;
    numVPixelsForOrientation[vert] = numVStrings;
}


bool RgbStripePattern::initPattern(std::map<WidgetId, Widget*>& widgets)
{
    // ----- get input channels -----

    std::vector<Pattern::ChannelConfiguration> channelConfigs = getChannelConfigurations(widgets);
    if (channelConfigs.empty()) {
        logger.logMsg(LOG_ERR, "No valid widget channels are configured for " + name + ".");
        return false;
    }

    for (auto&& channelConfig : channelConfigs) {
        bool recognizedChannel = false;

        if (channelConfig.inputName == "width") {
            widthChannel = channelConfig.widgetChannel;
            recognizedChannel = true;
        }

        for (int iColor = 0; !recognizedChannel && iColor < numColors; ++iColor) {
            string inputName = rgbPrefix[iColor] + string("Position");
            if (channelConfig.inputName == inputName) {
                positionChannel[iColor] = channelConfig.widgetChannel;
                recognizedChannel = true;
            }
        }

        if (recognizedChannel) {
            logger.logMsg(LOG_INFO, name + " using " + channelConfig.widgetChannel->getName() + " for " + channelConfig.inputName);
            if (channelConfig.measurement != "position") {
                logger.logMsg(LOG_WARNING, name + " supports only position measurements, but the input configuration for "
                              + channelConfig.inputName + " doesn't specify position.");
            }
        }
        else {
            logger.logMsg(LOG_WARNING, "inputName '" + channelConfig.inputName
                          + "' in input configuration for " + name + " is not recognized.");
        }
    }

    // ----- get pattern configuration -----

    string errMsgSuffix = " in " + name + " pattern configuration.";

    if (!ConfigReader::getIntValue(patternConfigObject, "widthResetTimeoutSeconds", widthResetTimeoutSeconds, errMsgSuffix, 1)) {
        return false;
    }
    logger.logMsg(LOG_INFO, name + " widthResetTimeoutSeconds=" + to_string(widthResetTimeoutSeconds));

    for (int iOrient = 0; iOrient < numOrientations; ++iOrient) {

        string elName = orientationPrefix[iOrient] + string("Enable");
        if (!ConfigReader::getBoolValue(patternConfigObject, elName, orientationIsEnabled[iOrient], errMsgSuffix)) {
            return false;
        }
        logger.logMsg(LOG_INFO, "%s %s=%d", name.c_str(), elName.c_str(), orientationIsEnabled[iOrient]);

        if (orientationIsEnabled[iOrient]) {

            string orientConfigName = orientationPrefix[iOrient] + string("Config");
            json11::Json orientConfigObj;
            if (!ConfigReader::getJsonObject(patternConfigObject, orientConfigName, orientConfigObj, errMsgSuffix)) {
                return false;
            }

            unsigned int vPixelRatio;
            if (!ConfigReader::getUnsignedIntValue(orientConfigObj, "virtualPixelRatio", vPixelRatio, errMsgSuffix, 1)) {
                return false;
            }
            logger.logMsg(LOG_INFO, "%s %s virtualPixelRatio=%d", name.c_str(), orientConfigName.c_str(), vPixelRatio);
            switch (iOrient) {
                case horiz:
                    verticalVPixelRatio = vPixelRatio;
                    vPixelsPerString = pixelsPerString * verticalVPixelRatio;
                    numPixelsForOrientation[horiz] = pixelsPerString;
                    numVPixelsForOrientation[horiz] = vPixelsPerString;
                    break;
                case vert:
                    horizontalVPixelRatio = vPixelRatio;
                    numVStrings = numStrings * horizontalVPixelRatio;
                    numPixelsForOrientation[vert] = numStrings;
                    numVPixelsForOrientation[vert] = numVStrings;
                    break;
                default:
                    logger.logMsg(LOG_ERR, "Unsupported orientation %d in %s %s pattern configuration.",
                                  iOrient, name.c_str(), orientConfigName.c_str());

            }

            if (!ConfigReader::getIntValue(
                orientConfigObj, "widthScaledownFactor", widthScaledownFactor[iOrient], errMsgSuffix, 1))
            {
                return false;
            }
            logger.logMsg(LOG_INFO, "%s %s widthScaledownFactor=%d",
                          name.c_str(), orientConfigName.c_str(), widthScaledownFactor[iOrient]);

            for (int iColor = 0; iColor < numColors; ++iColor) {

                string colorConfigName = rgbPrefix[iColor] + string("Config");
                json11::Json colorConfigObj;
                if (!ConfigReader::getJsonObject(orientConfigObj, colorConfigName, colorConfigObj, errMsgSuffix)) {
                    return false;
                }

                if (!ConfigReader::getIntValue(
                    colorConfigObj, "numStripes", numStripes[iOrient][iColor], errMsgSuffix, 1, numStrings / 2))
                {
                    return false;
                }
                if (numPixelsForOrientation[iOrient] % numStripes[iOrient][iColor] != 0) {
                    logger.logMsg(LOG_WARNING, "numStripes in %s %s %s pattern configuration should be a factor of %d.",
                                  name.c_str(), orientConfigName.c_str(), colorConfigName.c_str(),
                                  numPixelsForOrientation[iOrient]);
                }
                logger.logMsg(LOG_INFO, "%s %s %s numStripes=%d",
                              name.c_str(), orientConfigName.c_str(), colorConfigName.c_str(), numStripes[iOrient][iColor]);
                stripeStep[iOrient][iColor] = numPixelsForOrientation[iOrient] / numStripes[iOrient][iColor];

                if (!ConfigReader::getIntValue(
                    colorConfigObj, "scaledownFactor", scaledownFactor[iOrient][iColor], errMsgSuffix, 1))
                {
                    return false;
                }
                logger.logMsg(LOG_INFO, "%s %s %s scaledownFactor=%d",
                              name.c_str(), orientConfigName.c_str(), colorConfigName.c_str(), scaledownFactor[iOrient][iColor]);

                if (!ConfigReader::getIntValue(
                    colorConfigObj, "minSidebandWidth", minSidebandWidth[iOrient][iColor], errMsgSuffix,
                    0, numVPixelsForOrientation[iOrient] / 2))
                {
                    return false;
                }
                logger.logMsg(LOG_INFO, "%s %s %s minSidebandWidth=%d",
                              name.c_str(), orientConfigName.c_str(), colorConfigName.c_str(), minSidebandWidth[iOrient][iColor]);

                if (!ConfigReader::getIntValue(
                    colorConfigObj, "maxSidebandWidth", maxSidebandWidth[iOrient][iColor], errMsgSuffix,
                    minSidebandWidth[iOrient][iColor], numVPixelsForOrientation[iOrient] / 2))
                {
                    return false;
                }
                logger.logMsg(LOG_INFO, "%s %s %s maxSidebandWidth=%d",
                              name.c_str(), orientConfigName.c_str(), colorConfigName.c_str(), maxSidebandWidth[iOrient][iColor]);

                unsigned int baseIntensityValue;
                if (!ConfigReader::getUnsignedIntValue(
                    colorConfigObj, "baseIntensity", baseIntensityValue, errMsgSuffix, 0, 255))
                {
                    return false;
                }
                baseIntensity[iOrient][iColor] = baseIntensityValue;
                logger.logMsg(LOG_INFO, "%s %s %s baseIntensity=%d",
                              name.c_str(), orientConfigName.c_str(), colorConfigName.c_str(), baseIntensity[iOrient][iColor]);
            }
        }
    }

    // ----- initialize object data -----

    for (int iOrient = 0; iOrient < numOrientations; ++iOrient) {
        for (int iColor = 0; iColor < numColors; ++iColor) {
            stripeVPos[iOrient][iColor] = 0;
            widthPos[iOrient][iColor] = minSidebandWidth[iOrient][iColor];
        }
    }
    nextResetWidthMs = 0;
    resetWidth = true;

    return true;
}


bool RgbStripePattern::update()
{
    isActive = false;
    bool gotPositionOrWidthUpdate = false;
    int rawPosition;
    unsigned int nowMs = getNowMs();

    for (int iColor = 0; iColor < numColors; ++iColor) {
        if (positionChannel[iColor] != nullptr) {
            // Quick and dirty hack to allow other channels to share channel 0's data.
            if (isActive && gotPositionOrWidthUpdate
                && iColor != 0 && positionChannel[iColor] == positionChannel[0])
            {
                for (int iOrient = 0; iOrient < numOrientations; ++iOrient) {
                    if (orientationIsEnabled[iOrient]) {
                        stripeVPos[iOrient][iColor] =
                            ((unsigned int) rawPosition) / scaledownFactor[iOrient][iColor]
                            % numVPixelsForOrientation[iOrient];
                    }
                }
            }
            else {
                if (positionChannel[iColor]->getIsActive()) {
                    isActive = true;
                    if (positionChannel[iColor]->getHasNewPositionMeasurement()) {
                        gotPositionOrWidthUpdate = true;
                        rawPosition = positionChannel[iColor]->getPosition();
                        for (int iOrient = 0; iOrient < numOrientations; ++iOrient) {
                            if (orientationIsEnabled[iOrient]) {
                                stripeVPos[iOrient][iColor] =
                                    ((unsigned int) rawPosition) / scaledownFactor[iOrient][iColor]
                                    % numVPixelsForOrientation[iOrient];
                            }
                        }
                    }
                }
            }
        }
    }

    // Get an updated stripe width, if available.
    if (widthChannel != nullptr) {
        if (widthChannel->getIsActive()) {
            isActive = true;
            if (widthChannel->getHasNewPositionMeasurement()) {
                gotPositionOrWidthUpdate = true;

                int rawWidthPos = widthChannel->getPosition();
                if (resetWidth) {
                    resetWidth = false;
                    widthPosOffset = rawWidthPos;
                }

                for (int iColor = 0; iColor < numColors; ++iColor) {
                    for (int iOrient = 0; iOrient < numOrientations; ++iOrient) {
                        if (orientationIsEnabled[iOrient]) {
                            if (maxSidebandWidth[iOrient][iColor] > 0) {
                                int scaledWidthPos = (rawWidthPos - widthPosOffset) / widthScaledownFactor[iOrient];
                                // This is a triangle wave function where the period is maxSidebandWidth * 2
                                // and the range is minSidebandWidth to maxSidebandWidth.  We right-shift the
                                // wave so that the width starts out at minSidebandWidth.
                                widthPos[iOrient][iColor] =
                                    abs( abs(scaledWidthPos + maxSidebandWidth[iOrient][iColor])
                                         % (maxSidebandWidth[iOrient][iColor] * 2) - maxSidebandWidth[iOrient][iColor] )
                                    + minSidebandWidth[iOrient][iColor];
                            }
                            //logger.logMsg(LOG_DEBUG, name
                            //              + ":  iColor=" + to_string(iColor)
                            //              + ", iOrient=" + to_string(iOrient)
                            //              + ", rawWidthPos=" + to_string(rawWidthPos)
                            //              + ", widthPosOffset=" + to_string(widthPosOffset)
                            //              + ", scaledWidthPos=" + to_string(scaledWidthPos));
                            //              + ", widthPos[iOrient][iColor]=" + to_string(widthPos[iOrient][iColor]));
                        }
                    }
                }
            }
        }
    }

    // Set flag to force width back to 1 when width channel
    // has been inactive for widthResetTimeoutSeconds.
    if (isActive) {
        nextResetWidthMs = 0;
    }
    else {
        if (nextResetWidthMs == 0) {
            nextResetWidthMs = nowMs + widthResetTimeoutSeconds * 1000;
        }
        else if (!resetWidth && (int) (nowMs - nextResetWidthMs) >= 0) {
            logger.logMsg(LOG_DEBUG, name + ":  Resetting width.");
            resetWidth = true;
            for (int iOrient = 0; iOrient < numOrientations; ++iOrient) {
                for (int iColor = 0; iColor < numColors; ++iColor) {
                    widthPos[iOrient][iColor] = minSidebandWidth[iOrient][iColor];
                }
            }
        }
    }

    // Draw the stripes.
    if (gotPositionOrWidthUpdate) {

        clearAllPixels(pixelArray);

        for (int iColor = 0; iColor < numColors; ++iColor) {
            if (positionChannel[iColor] != nullptr) {
                for (int iOrient = 0; iOrient < numOrientations; ++iOrient) {
                    if (orientationIsEnabled[iOrient]) {

                    int sidebandWidth = widthPos[iOrient][iColor];
                    float intensitySlope = (float) baseIntensity[iOrient][iColor] / (float) (sidebandWidth + 1);

                    int lowVEl = stripeVPos[iOrient][iColor] - sidebandWidth;
                    int highVEl = stripeVPos[iOrient][iColor] + sidebandWidth;

                    switch (iOrient) {

                        case vert:

                            //logger.logMsg(LOG_DEBUG, name
                            //    + " vert:  iColor=" + to_string(iColor)
                            //    + ",  widthPos[iColor]=" + to_string(widthPos[iOrient][iColor])
                            //    + ",  sidebandWidth=" + to_string(sidebandWidth)
                            //    + ", intensitySlope=" + to_string(intensitySlope)
                            //    + ", stripeVPos[iOrient][iColor]=" + to_string(stripeVPos[iOrient][iColor])
                            //    + ", lowVEl=" + to_string(lowVEl)
                            //    + ", highVEl=" + to_string(highVEl));

                            for (int i = lowVEl; i <= highVEl; ++i) {
                                unsigned int vStringIndex = ((i + numVStrings) % numVStrings);
                                // If this virtual string corresponds to a physical
                                // string, we'll draw into the physical string.
                                if (vStringIndex % horizontalVPixelRatio == 0) {
                                    unsigned int stringIndex = vStringIndex / horizontalVPixelRatio;
                                    float distanceToCenter = abs(i - stripeVPos[iOrient][iColor]);
                                    uint8_t intensity =
                                        baseIntensity[iOrient][iColor] - (uint8_t) (intensitySlope * distanceToCenter);
                                    for (int iStripe = 0; iStripe < numStripes[iOrient][iColor]; ++iStripe) {
                                        for (auto&& pixels : pixelArray[stringIndex]) {
                                            pixels.raw[iColor] = qadd8(pixels.raw[iColor], intensity);
                                        }
                                        stringIndex = (stringIndex + stripeStep[iOrient][iColor]) % numStrings;
                                    }
                                }
                            }

                            break;

                        case horiz:

                            //logger.logMsg(LOG_DEBUG, name
                            //    + " horiz:  iColor=" + to_string(iColor)
                            //    + ",  widthPos[iColor]=" + to_string(widthPos[iColor])
                            //    + ",  sidebandWidth=" + to_string(sidebandWidth)
                            //    + ", intensitySlope=" + to_string(intensitySlope)
                            //    + ", stripeVPos[iOrient][iColor]=" + to_string(stripeVPos[iOrient][iColor])
                            //    + ", lowVEl=" + to_string(lowVEl)
                            //    + ", highVEl=" + to_string(highVEl));

                            for (int i = lowVEl; i <= highVEl; ++i) {
                                unsigned int vPixelIndex = ((i + vPixelsPerString) % vPixelsPerString);
                                // If this virtual pixel corresponds to a physical
                                // pixel, we'll draw into the physical pixels.
                                if (vPixelIndex % verticalVPixelRatio == 0) {
                                    unsigned int pixelIndex = vPixelIndex / verticalVPixelRatio;
                                    float distanceToCenter = abs(i - stripeVPos[iOrient][iColor]);
                                    uint8_t intensity =
                                        baseIntensity[iOrient][iColor] - (uint8_t) (intensitySlope * distanceToCenter);
                                    for (int iStripe = 0; iStripe < numStripes[iOrient][iColor]; ++iStripe) {
                                        for (auto&& stringPixels : pixelArray) {
                                            stringPixels[pixelIndex].raw[iColor] =
                                                qadd8(stringPixels[pixelIndex].raw[iColor], intensity);
                                        }
                                        pixelIndex = (pixelIndex + stripeStep[iOrient][iColor]) % pixelsPerString;
                                    }
                                }
                            }

                            break;
                        }
                    }
                }
            }
        }
    }

    return isActive;
}
