skipzone/Illumicone/include/pixeltypes.h

/*
    This file is part of Illumicone.

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
    ----------------------------------------------------------------------------

    The contents of this file were ported from FastLED version 3.001.003.
    FastLED bears the following copyright message:

        The MIT License (MIT)

        Copyright (c) 2013 FastLED

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
    See the official FastLED site http://fastled.io for additional information.
*/

#pragma once

#include <stdint.h>

#include "lib8tion.h"
#include "color.h"


struct CRGB;
struct CHSV;

/// Forward declaration of hsv2rgb_rainbow here,
/// to avoid circular dependencies.
extern void hsv2rgb_rainbow( const CHSV& hsv, CRGB& rgb);

/// Representation of an HSV pixel (hue, saturation, value (aka brightness)).
struct CHSV {
    union {
        struct {
            union {
                uint8_t hue;
                uint8_t h; };
            union {
                uint8_t saturation;
                uint8_t sat;
                uint8_t s; };
            union {
                uint8_t value;
                uint8_t val;
                uint8_t v; };
            uint8_t pad;
        };
        uint8_t raw[4];
        uint32_t raw32;
    };

    /// default values are UNITIALIZED
    inline CHSV() __attribute__((always_inline))
    {
    }

    /// allow construction from H, S, V
    inline CHSV( uint8_t ih, uint8_t is, uint8_t iv) __attribute__((always_inline))
        : h(ih), s(is), v(iv), pad(0)
    {
    }

    /// allow copy construction
    inline CHSV(const CHSV& rhs) __attribute__((always_inline))
    {
//        h = rhs.h;
//        s = rhs.s;
//        v = rhs.v;
        raw32 = rhs.raw32;
    }

    inline CHSV& operator= (const CHSV& rhs) __attribute__((always_inline))
    {
//        h = rhs.h;
//        s = rhs.s;
//        v = rhs.v;
        raw32 = rhs.raw32;
        return *this;
    }

    inline CHSV& setHSV(uint8_t ih, uint8_t is, uint8_t iv) __attribute__((always_inline))
    {
        h = ih;
        s = is;
        v = iv;
        return *this;
    }

    /// this allows testing a CHSV for zero-ness
    inline operator bool() const __attribute__((always_inline))
    {
        return raw32 != 0;
    }
};

inline __attribute__((always_inline)) bool operator== (const CHSV& lhs, const CHSV& rhs)
{
//    return (lhs.h == rhs.h) && (lhs.s == rhs.s) && (lhs.v == rhs.v);
    return (lhs.raw32 == rhs.raw32);
}

inline __attribute__((always_inline)) bool operator!= (const CHSV& lhs, const CHSV& rhs)
{
    return !(lhs == rhs);
}

/// Pre-defined hue values for HSV objects
typedef enum {
    HUE_RED = 0,
    HUE_ORANGE = 32,
    HUE_YELLOW = 64,
    HUE_GREEN = 96,
    HUE_AQUA = 128,
    HUE_BLUE = 160,
    HUE_PURPLE = 192,
    HUE_PINK = 224
} HSVHue;

/// Representation of an RGB pixel (Red, Green, Blue)
struct CRGB {
    union {
        struct {
            union {
                uint8_t r;
                uint8_t red;
            };
            union {
                uint8_t g;
                uint8_t green;
            };
            union {
                uint8_t b;
                uint8_t blue;
            };
            uint8_t pad;
        };
        uint8_t raw[4];
        uint32_t raw32;
    };

    /// Array access operator to index into the crgb object
    inline uint8_t& operator[] (uint8_t x) __attribute__((always_inline))
    {
        return raw[x];
    }

    /// Array access operator to index into the crgb object
    inline const uint8_t& operator[] (uint8_t x) const __attribute__((always_inline))
    {
        return raw[x];
    }

    // default values are UNINITIALIZED
    inline CRGB() __attribute__((always_inline))
    {
    }

    /// allow construction from R, G, B
    inline CRGB( uint8_t ir, uint8_t ig, uint8_t ib)  __attribute__((always_inline))
        : r(ir), g(ig), b(ib), pad(0)
    {
    }

    /// allow construction from 32-bit (really 24-bit) bit 0xRRGGBB color code
    inline CRGB( uint32_t colorcode)  __attribute__((always_inline))
    : r((colorcode >> 16) & 0xFF), g((colorcode >> 8) & 0xFF), b((colorcode >> 0) & 0xFF), pad(0)
    {
    }

    /// allow construction from a LEDColorCorrection enum
    inline CRGB( LEDColorCorrection colorcode) __attribute__((always_inline))
    : r((colorcode >> 16) & 0xFF), g((colorcode >> 8) & 0xFF), b((colorcode >> 0) & 0xFF), pad(0)
    {

    }

    /// allow construction from a ColorTemperature enum
    inline CRGB( ColorTemperature colorcode) __attribute__((always_inline))
    : r((colorcode >> 16) & 0xFF), g((colorcode >> 8) & 0xFF), b((colorcode >> 0) & 0xFF), pad(0)
    {

    }

    /// allow copy construction
    inline CRGB(const CRGB& rhs) __attribute__((always_inline))
    {
//        r = rhs.r;
//        g = rhs.g;
//        b = rhs.b;
        raw32 = rhs.raw32;
    }

    /// allow construction from HSV color
    inline CRGB(const CHSV& rhs) __attribute__((always_inline))
    {
        hsv2rgb_rainbow( rhs, *this);
    }

    /// allow assignment from one RGB struct to another
    inline CRGB& operator= (const CRGB& rhs) __attribute__((always_inline))
    {
//        r = rhs.r;
//        g = rhs.g;
//        b = rhs.b;
        raw32 = rhs.raw32;
        return *this;
    }

    /// allow assignment from 32-bit (really 24-bit) 0xRRGGBB color code
    inline CRGB& operator= (const uint32_t colorcode) __attribute__((always_inline))
    {
        r = (colorcode >> 16) & 0xFF;
        g = (colorcode >>  8) & 0xFF;
        b = (colorcode >>  0) & 0xFF;
        pad = 0;
        return *this;
    }

    /// allow assignment from R, G, and B
    inline CRGB& setRGB (uint8_t nr, uint8_t ng, uint8_t nb) __attribute__((always_inline))
    {
        r = nr;
        g = ng;
        b = nb;
        pad = 0;
        return *this;
    }

    /// allow assignment from H, S, and V
    inline CRGB& setHSV (uint8_t hue, uint8_t sat, uint8_t val) __attribute__((always_inline))
    {
        hsv2rgb_rainbow( CHSV(hue, sat, val), *this);
        pad = 0;
        return *this;
    }

    /// allow assignment from just a Hue, saturation and value automatically at max.
    inline CRGB& setHue (uint8_t hue) __attribute__((always_inline))
    {
        hsv2rgb_rainbow( CHSV(hue, 255, 255), *this);
        pad = 0;
        return *this;
    }

    /// allow assignment from HSV color
    inline CRGB& operator= (const CHSV& rhs) __attribute__((always_inline))
    {
        hsv2rgb_rainbow( rhs, *this);
        pad = 0;
        return *this;
    }

    /// allow assignment from 32-bit (really 24-bit) 0xRRGGBB color code
    inline CRGB& setColorCode (uint32_t colorcode) __attribute__((always_inline))
    {
        r = (colorcode >> 16) & 0xFF;
        g = (colorcode >>  8) & 0xFF;
        b = (colorcode >>  0) & 0xFF;
        pad = 0;
        return *this;
    }

    /// add one RGB to another, saturating at 0xFF for each channel
    inline CRGB& operator+= (const CRGB& rhs )
    {
        r = qadd8( r, rhs.r);
        g = qadd8( g, rhs.g);
        b = qadd8( b, rhs.b);
        return *this;
    }

    /// add a contstant to each channel, saturating at 0xFF
    /// this is NOT an operator+= overload because the compiler
    /// can't usefully decide when it's being passed a 32-bit
    /// constant (e.g. CRGB::Red) and an 8-bit one (CRGB::Blue)
    inline CRGB& addToRGB (uint8_t d )
    {
        r = qadd8( r, d);
        g = qadd8( g, d);
        b = qadd8( b, d);
        return *this;
    }

    /// subtract one RGB from another, saturating at 0x00 for each channel
    inline CRGB& operator-= (const CRGB& rhs )
    {
        r = qsub8( r, rhs.r);
        g = qsub8( g, rhs.g);
        b = qsub8( b, rhs.b);
        return *this;
    }

    /// subtract a constant from each channel, saturating at 0x00
    /// this is NOT an operator+= overload because the compiler
    /// can't usefully decide when it's being passed a 32-bit
    /// constant (e.g. CRGB::Red) and an 8-bit one (CRGB::Blue)
    inline CRGB& subtractFromRGB(uint8_t d )
    {
        r = qsub8( r, d);
        g = qsub8( g, d);
        b = qsub8( b, d);
        return *this;
    }

    /// subtract a constant of '1' from each channel, saturating at 0x00
    inline CRGB& operator-- ()  __attribute__((always_inline))
    {
        subtractFromRGB(1);
        return *this;
    }

    /// subtract a constant of '1' from each channel, saturating at 0x00
    inline CRGB operator-- (int )  __attribute__((always_inline))
    {
        CRGB retval(*this);
        --(*this);
        return retval;
    }

    /// add a constant of '1' from each channel, saturating at 0xFF
    inline CRGB& operator++ ()  __attribute__((always_inline))
    {
        addToRGB(1);
        return *this;
    }

    /// add a constant of '1' from each channel, saturating at 0xFF
    inline CRGB operator++ (int )  __attribute__((always_inline))
    {
        CRGB retval(*this);
        ++(*this);
        return retval;
    }

    /// divide each of the channels by a constant
    inline CRGB& operator/= (uint8_t d )
    {
        r /= d;
        g /= d;
        b /= d;
        return *this;
    }
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
