skipzone/Illumicone/(commit log)

2016-05-07 Add LEDscape header for LEDscape API and data types.
2016-05-07 Add start to Pattern class and update Makefile to build it.
    (Vectors took waaay too long for me to understand)
    [Pattern.cpp]
2016-05-13 Add Widget, WidgetChannel, and LEDscape includes.
    DOES NOT WORK!
    [Pattern.cpp, Pattern.h, Widget.cpp, Widget.h, WidgetChannel.cpp, WidgetChannel.h]
2016-05-18 Compiling Pattern/Widget framework!!
    Derived class RgbVerticalPattern will be used for controlling the
    pattern from the 3-wheel widget.
2016-05-28 Compiling framework!
    It's a little sparse, but the organization is all there.
    Pattern is an abstract class, which is implemented in RgbVerticalPattern
    (and others in the future). Each pattern has a number of widgets
    associated with it, which are also abstract and implemented with
    ThreeWheelWidget (and others in the future). Each derived Widget
    has a number of channels in it, implemented in WidgetChannel (this will
    be expanded further).
2016-06-09 Updates throughout.
    Reworked some of the init functions.
    Wrote the RgbVerticalPattern update function.
    Added an "OPC pixel" type.
    Added print statements to track code flow.
    [Pattern.cpp, Pattern.h, RgbVerticalPattern.cpp, RgbVerticalPattern.h, WidgetChannel.h, illumiconeTypes.h]
2016-06-23 Further enhancements to get ThreeWheelWidget working.
    Added some packet construct/dump stuff to view the OPC data.
    Added a README for some notes.
    Fixed a variety of things, most notably using auto&& in range-based
    for loops when assigning values to the objects being iterated over.
    [Pattern.cpp, RgbVerticalPattern.cpp, Widget.h, WidgetChannel.cpp, WidgetChannel.h]
2016-06-30 Updates throughout to start bringing in a priority scheme.
    A "frame" contains the final OPC data to be sent to the opc-server.
    It is built by passing each pattern that has been updated since the
    last loop along with its priority into buildFrame(), which determines
    how to update the pixel values based on the provided pattern's
    values and priority.
    For now it's a direct replacement - each priority overwrites the
    entire array with its Pattern's values.
    Did some other minor stuff:
    - Added a "name" string to the Pattern superclass
    - Assigned the name in the Pattern's derived class initPattern
    function
    - Added a "numChannels" integer to the Widget superclass
    - Assigned the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
    [EyeWidget.cpp, Pattern.cpp, Pattern.h, RgbVerticalPattern.cpp, RgbVerticalPattern.h, Widget.h, illumiconeTypes.h]
2016-07-04 Add files to incorporate stair widget with a pattern.
    Also update PatternController to incorporate it into the
    final frame.
    Start documenting in README.
    Add GpioTester to test the string ordering.
    Add WidgetSimulator to simulate widget input using shared memory.
2016-07-05 Add placeholder classes for patterns/widgets.
    RotaryWidget (bike)
    TwistPattern (bike)
    RainstickWidget (rainstick)
    SparklePattern (rainstick)
    RainstickWidget and SparklePattern are not currently being used.
    One more pattern/widget expected: BellWidget, ColorTonePattern.
2016-07-09 Added Arduino, libraries, and three widgets (StressTest, Hypnotyzer, and Steps).
2016-07-09 Added simulation to ThreeWheelWidget. Debugged failure to display.
    [RgbVerticalPattern.cpp, WidgetChannel.cpp]
2016-07-10 Added LEDscape mapping file for damaged board where output to J3 is remapped to J10.
2016-07-11 Added UDP receive thread to Widget class. Did minor yet required refactoring.
2016-07-12 Fixed seg fault in Rgb... pattern caused by negative measurement.
    [RgbVerticalPattern.cpp]
2016-07-12 Fixed problem of not sending payload with inactive flag for steps widget.
    [widgetRcvr.cpp]
2016-07-12 Add stuff that was missed during merge.
    [Widget.cpp]
2016-07-13 Enabled data reception via UDP in Eye and Rotary (Hypnotyzer) widgets. Added threshold to SolidBlackPattern (currently 300). Changed SolidBlack and Sparkle patterns to not use simulated data.
2016-07-13 Added Widget_Eye. Can't remember what I did to Widget_TriObelisk--probably made it work. Copied TriObelisk to Hypnotyzer as a starting point. (HypnoTyzer probably won't build yet.)
    [Widget_Eye.ino, Widget_ReileyHypnotyzer.ino, Widget_TriObelisk.ino]
2016-07-24 Added config file for LEDscape.
2016-07-29 Widgets channels now go inactive automatically if they are not explicitly set active for 2 seconds. This prevents a widget that stops transmitting from staying active forever. RgbVerticalPattern now 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
    [RgbVerticalPattern.cpp, WidgetChannel.cpp, WidgetChannel.h]
2016-08-13 Updates to Trickle for rainstick.
    Have a pattern worked out, currently it is not relying on Widget
    input of any kind to update.
2016-08-19 Fix wraparound calculations to make them waaaaaaay easier.
    [BellsWidget.cpp, RgbVerticalPattern.cpp]
2016-08-21 Added Arduino firmware for Bells and Plunger. Changed analog pin for Eye.
2016-09-11 Changes and additions from Burning Man 2016.
    [FourPlayWidget.h, HorizontalStripePattern.cpp, RainbowExplosionPattern.cpp, RgbVerticalPattern.cpp, SparklePattern.cpp, Widget_Eye.ino, Widget_FourPlay.ino, illumiconeTypes.h]
2016-09-11 Updated widgetRcvr.cpp with version from Burning Man that supports FourPlay.
    [widgetRcvr.cpp]
2016-10-25 Added database directory. importWidgetRcvrLog.py parses log files but doesn't insert data yet. Fixed erroneous write to stderr in widgetRcvr.
    [widgetRcvr.cpp]
2016-10-25 Fixed column name of widget_packet.is_active. importWidgetRcvrLog.py now imports position/velocity payloads.
2016-10-25 Added custom_payload.payload_length column. importWidgetRcvrLog.py now imports all payload types currently defined.
2016-11-07 Removed pattern_controller_packet table, moved considered_active_by_pattern to widget_packet. Created doBackup.sh. Fixed pattern for custom payload. Code cleanup in widgetRcvr.cpp.
    [widgetRcvr.cpp]
2016-11-07 Modifications for DeComp 2016: Added quiescent mode. Changed off/on times for autumn sunrise/sunset. Reduced sparkle. Changed plunger threshold for new air pump. Moved devl/illumicone/Illumicone to d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
2017-04-08 Added remapping hack for using FourPlay-4-2's fourth wheel as Hypnotyzer.
2017-04-08 Fixed bug that caused interference between port C and port D encoders.
    [Widget_FourPlay.ino]
2017-04-08 Fixed bug in remapping hack.
    [widgetRcvr.cpp]
2017-04-08 Added FourPlay-4-2 and FourPlay-4-3. FourPlay-4-3 replaces TriObelisk (at least for now).
    [FourPlay42Widget.cpp, FourPlay42Widget.h, FourPlay43Widget.h, HorizontalStripePattern.cpp, RgbVerticalPattern.cpp]
2017-04-08 Made each FourPlay widget use a different retry interval to avoid one blocking the other.
    [Widget_FourPlay.ino]
2017-06-17 Added microphone to Rainstick. Not debugged because mic module not working (hardware).
    [Widget_Rainstick.ino]
2017-06-18 Got Schroeder's Plaything working. Added system and pitch bend handling.
2017-06-18 Modified Eye to use JSON config. Renamed SolidBlackPattern to AnnoyingFlashingPattern and added configuration items to control it. All current widget initialization is now done in the Widget parent c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
    [AnnoyingFlashingPattern.cpp, AnnoyingFlashingPattern.h, BellsWidget.cpp, BellsWidget.h, ConfigReader.cpp, ConfigReader.h, EyeWidget.cpp, EyeWidget.h]
2017-06-19 First pass at moving averages for Rainstick. Not working great yet.
    [Widget_Rainstick.ino]
2017-06-22 Fixes to widgetRcvr.cpp so that it will compile.
    [widgetRcvr.cpp]
2017-06-23 Contort-O-Matic controller basically works on Mega board, but probably not correctly yet.
    [Widget_ContortOMatic.ino]
2017-06-23 Modified SparklePattern to use JSON config. Fixed interference between WidgetChannel::getPosition() and WidgetChannel::getVelocity() that cause the previous value to get lost. Added beginning of Rasp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
    [AnnoyingFlashingPattern.cpp, AnnoyingFlashingPattern.h, FourPlay42Widget.cpp, RgbVerticalPattern.cpp, SparklePattern.cpp, SparklePattern.h, Widget.cpp, Widget.h]
2017-06-25 Changed pipe address to custom-payload address (5). Changed RF24 pin config for Mega board. Played with thresholds.
2017-06-26 Added start-up calibration. Tested with Contort-O-Matic; works!
2017-06-30 Modified Widget_Plunger to work with pressure sensor.
2017-07-10 Got rid of signed/unsigned warnings (hopefully) that appear when compilingon patcon. Hard coded IP address of patcon in widgetRcvr. Added include of chrono in RainbowExplosionPattern.cpp to fix compi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
    [BellsWidget.cpp, RainbowExplosionPattern.cpp, Widget_StressTest.ino, widgetRcvr.cpp]
2017-07-12 Fixed the widget IDs of fourPlay42 and fourPlay43.
    [Widget_FourPlay.ino]
2017-07-12 From ic-widcon: Changed patcon's IP address to 12 because static IP not working. Commented out channel redirection hack.
    [widgetRcvr.cpp]
2017-07-13 Removed commented-out widget channel redirection hacks. Did some cleanup. Can't tell if it compiles because floyd doesn't have RF24 installed.
    [widgetRcvr.cpp]
2017-07-13 FillAndBurstPattern now sets its priority based on state--pressurizing (6) or bursting (1)--so that it doesn't block other patterns while it is pressurizing.
    [FillAndBurstPattern.cpp]
2017-07-16 Disabled accelerometer in Widget_Rainstick because I forgot to put the I2C library on floyd. Tweaked the particles pattern config. This is what ran on Saturday night at Element 11.
2017-07-18 Renamed PatternController to patternController to match convention of program names starting with lower case. Moved unneeded and unfinished patterns to boneyard. Moved unneeded widgets and misc. file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
2017-07-18 Fixed signed/unsigned warning in Widget.
    [Widget.cpp]
2017-07-18 Fixed nowMs checks for proper wrapping in all widgets. Moved non-widget-specific simulation code to the Widget class.
    [BellsWidget.cpp, BellsWidget.h, EyeWidget.cpp, EyeWidget.h, FourPlay42Widget.cpp, FourPlay42Widget.h, FourPlay43Widget.h, PumpWidget.cpp]
2017-07-18 Fixed nowMs checks for proper wrapping in all places except widget classes (already done) and widgetRcvr.
    [FillAndBurstPattern.cpp, ParticlesPattern.cpp, RainbowExplosionPattern.cpp, WidgetChannel.cpp]
2017-07-24 Replaced opc_pixel_t with CRGB.
    [AnnoyingFlashingPattern.cpp, FillAndBurstPattern.cpp, FillAndBurstPattern.h, HorizontalStripePattern.cpp, ParticlesPattern.cpp, ParticlesPattern.h, Pattern.cpp, Pattern.h]
2017-07-31 Moved maintenance of HSV pixels (consStrings) from AnnoyingFlashingPattern to Pattern. Added log info message when a widget automatically goes inactive. AnnoyingFlashingPattern now automatically disa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
    [AnnoyingFlashingPattern.cpp, AnnoyingFlashingPattern.h, EyeWidget.cpp, EyeWidget.h, Pattern.cpp, Pattern.h, SparklePattern.cpp, SparklePattern.h]
2017-08-02 Added an rgb2hsv function that seems to work better. FastLED's doesn't do two-color combinations with blue correctly when the values are close to 255.
    [hsv2rgb.cpp, illumiconePixelUtility.cpp, illumiconePixelUtility.h, patternController.cpp]
2017-08-08 Fixed up formatting of some log messages in widgetRcvr. Fixed incorrect date and time in log timestamps on RPi and BBB by adding getNowMs64, which returns a 64-bit ms value on all platforms. (getNowM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
    [illumiconeUtility.cpp, illumiconeUtility.h, widgetRcvr.cpp]
2017-08-12 Added SwitchActivatedRegionsPattern and ContortOMaticWidget classes.
2017-08-12 Fixed Contort-O-Matic pad mapping. Added flashing to its pattern.
    [SwitchActivatedRegionsPattern.cpp]
2017-08-14 Widget_SchroedersPlaything now simply relays all MIDI messages.
2017-08-14 Fixed logging of non-error messages to cerr. Fixed MIDI structures. Resolved unsigned/signed int warnings.
    [FillAndBurstPattern.cpp, IndicatorRegion.cpp, IndicatorRegionsPattern.cpp, MidiActivatedRegionsPattern.cpp, ParticlesPattern.cpp, Pattern.h, RainbowExplosionPattern.cpp, illumiconeTypes.h]
2017-08-21 Using close() instead of disconnectx to close the connection to the OPC server. Widget now uses pthread_cancel to kill the UDP rx thread because closing the connection doesn't cause the receive call 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
    [Widget.cpp, patternController.cpp]
2017-08-21 Added strdrv_root_crontab, which restarts ledscape.service just before and after the cone's active period.
2017-08-25 Fixed times in strdrv_root_crontab to be MDT. Brought widgetSet1.json up-to-date with current set of widgets.
2017-08-26 Fixed bug in RgbVerticalPattern that prevented the idle rainbow from being displayed. widgetSet1 is what we intended to run. widgetSet2.json assigns TriObelisk to horizontal rings because FourPlay-4-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
    [RgbVerticalPattern.cpp]
2017-08-31 Added deactivationThreshold and numGoodMeasurementsForReactivation config parameters to SparklePattern so that we can prevent bad velocity data from TriObelisk (when it is spun counterclockwise) from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
    [SparklePattern.cpp, SparklePattern.h, TriObeliskWidget.cpp, TriObeliskWidget.h, patternController.cpp]
2017-09-01 Added depressurization display to FillAndBurst pattern, and modified measurement simulation in PumpWidget to test it.
2017-09-01 Changes from ic-patcon on playa. Hopefully fixed 1-second blackout problem by using reentrant version of localtime. Changed sparkle colors so that they don't look like fucking Christmas. Changed some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
    [PumpWidget.cpp, patternController.cpp]
2017-09-09 Created QueuedWidgetChannel and implemented it for SchroedersPlaythingWidget. It sorta works, but it seems like queue.pop() doesn't reduce queue.size(). Also, measurements are still being dropped.
    [MidiActivatedRegionsPattern.cpp, QueuedWidgetChannel.cpp, QueuedWidgetChannel.h, SchroedersPlaythingWidget.cpp, Widget.cpp, Widget.h, WidgetChannel.h]
2017-09-16 Modified widgetRcvr to use SPI-DEV so it doesn't have to run as root. Added ntp.conf from the first attempt at configuring ic-widpatcon on an RPi 3.
    [widgetRcvr.cpp]
2017-09-19 Fixed bug in QueuedWidgetChannel that I couldn't find on playa (hasNew...Measurement was being set incorrectly, mainly).
    [MidiActivatedRegionsPattern.cpp, QueuedWidgetChannel.cpp, SchroedersPlaythingWidget.cpp, patternController.cpp]
2017-09-19 Added script to read the temperature from the DS18B20 device on the RTC module. Added crontab entry to log the temperature once per minute on ic-widpatcon.
2017-09-19 Added section for setting up 1-Wire interface.
2017-09-19 Reset no-data message interval when data received.
    [widgetRcvr.cpp]
2017-09-24 Added note about enabling 1-Wire via raspi-config.
2017-09-24 Went down path of using latest Debian image, tried to enable uio_pruss, but found out that can't be done. Committing at this point in order to preserve some interesting notes about messing with the d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
2017-09-25 Renamed ws281x-config.json to ledscape-config.json so that LEDscape's run-ledscape script can be used as-is.
2017-09-25 Changed LED dimensions to match Illumicone, not Mini-Cone.
2017-09-25 Added more setup steps, especially how to enable uio_pruss and set up the LEDscape service.
2017-09-29 Commented out shutdown period debug messages in patternController. Created separate LEDscape configurations for Illumicone and Mini-Cone, updated setup notes accordingly. Created first config for Min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
2017-10-08 ParticlesPattern can now use velocity measurements. SparklePattern now uses the absolute value of a velocity measurement.
2018-01-21 Adding arc.m, baseRing.m (not finished yet), and testArc.m. baseRing.m calculates the lengths of the various pieces of the new base ring then plots them so that we can visually check for things like 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
2018-01-22 Added segment and coupler labels.
2018-01-22 Prints overlaps for 48 strings based on 36-string offset.
2018-01-27 Added total weight calculation and printout.
2018-02-04 Added option to use UDP in patternController for sending messages to opc-server. Fixes the stuttering / skipped frames problem. Maybe fixes the delay problem.
    [patternController.cpp, stringTester.cpp]
2018-02-05 Added pressurizationColor and depressurizationColor to pumpFillAndBurst.
2018-02-05 Now calls global namespace ::bind when binding socket. This fixes the problem of not receiving widget UDP messages on macOS.
    [Widget.cpp]
2018-02-20 Added document for laminated setup card. Added centering cables to diagram.
2018-02-20 Added centering cables to diagram.
2018-02-21 Added 1-wire address for module in new controller box.
2018-02-25 Fixed apparent bug of sampling audio too often.
    [Widget_Rainstick.ino]
2018-02-26 Bells are better with sprays of different colors and velocities. TriObelisk is doing the sparkles. Also changed pattern update interval to 4 ms to accommodate fast spray.
2018-02-27 Added forward and reverse motion colors to SparklePattern. Modified TriObelisk simulated measurements to generate negative velocity.
    [SparklePattern.cpp, SparklePattern.h, TriObeliskWidget.cpp]
2018-02-28 Added debug print flag constant. Verified that the sketch runs ok and sends data.
2018-03-01 Rainstick changes to implement MPU. Sound measurements not working correctly.
    [Widget_Esplora.ino, Widget_Rainstick.ino]
2018-03-01 Re-did data types for averaging. Improved sound sampling. Still hangs due to what appears to be an IMU FIFO problem.
    [Widget_Rainstick.ino]
2018-03-01 Re-wrote MPU6050 interrupt status and FIFO handling. Doesn't seem to hang anymore.
    [Widget_Rainstick.ino]
2018-03-01 Did some cleanup. Init makes sure packet buffer is large enough. Activation threshold set very low (8 instead of 100) for overnight testing. Mic pins need to be changed for Rainstick (currently set f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
2018-03-01 Added further checking and handling of FIFO fuckery. Also added a watchdog to reset the MCU when we don't get good data from the MPU6050.
    [Widget_Rainstick.ino]
2018-03-04 Fixed problem of vertical stripes disappearing when width position was 1. Fixed problem of vertical stripes and horizontal rings width going from 1 to 3 and never being 2.
    [HorizontalStripePattern.cpp, RgbVerticalPattern.cpp, RgbVerticalPattern.h, patternController.cpp]
2018-03-10 Stripe width now resets to 1 after the specified period of inactivity. (Actual reset functionality not tested yet.) Width now starts out at 1 instead of at max width.
    [RgbVerticalPattern.cpp, RgbVerticalPattern.h]
2018-03-10 Implement simulation of FourPlay-4-2 using joystick and button 2.
2018-03-10 Width reset works fine.
    [RgbVerticalPattern.cpp]
2018-03-10 Added simulation of FourPlay-4-3. Changed velocity divisor to 1.
2018-03-10 Implemented timed with reset in HorizontalStripePattern.
    [HorizontalStripePattern.cpp, HorizontalStripePattern.h, RgbVerticalPattern.cpp]
2018-03-10 Added simulation of Pump.
2018-03-11 Added pressure-controlled bursting rate and flashing.
2018-04-06 Added configuration for Sensory Illumination 2018. Assigned sparkles to fourth wheel on FourPlays. Only going to have FourPlays, Rainstick, and Pump. Added navy color to stringToRgbPixel. Added BsuOr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
2018-06-12 Added spiral and progressive spring configuration items.
2018-06-12 Added compression widget channel and related stuff. No longer uses width for compression.
    [SpiralPattern.cpp, SpiralPattern.h]
2018-06-13 In response to this comment found in Widget_Rainstick.ino and elsewhere:
    // For some unkown reason, shit don't work without printf. (One of the
    // libraries is probably calling printf unconditionally. What an asshole.)
    I am that asshole. Making the radio.printDetails() call conditional on ENABLE_DEBUG_PRINT fixed the problem.
2018-06-13 Removed workaround for printf being used elsewhere without ENABLE_DEBUG_PRINT being defined.
    [Widget_Rainstick.ino]
2018-06-13 Added Boogie Board widget.
2018-06-13 Aligned TX_RETRY_DELAY_MULTIPLIER values, which are now listed in Arduino/README.txt.
2018-06-13 Got spiral pattern basically working with a Boogie Board widget sensor.
2018-06-13 Added a copy of zestyping's openpixelcontrol in case the original project goes away. We need openpixelcontrol for simulation.
2018-07-08 Added ledscape config for 48 strings.
2018-07-08 Corrected step 10--how to disable HDMI on a BeagleBone Black--for compatibility with the newer version of Linux that the procedure calls for. Added "48" suffix to ledscape illumicone config name.
2018-07-10 Changed std::powf to ::powf to resolve compilation error on Debian 7.11 (widpatcon).
    [SpiralPattern.cpp]
2018-07-11 Updated spring config for new rotation and color features.
2018-07-12 Fixed warning on Linux by added missing braces around if block. Changed spiral rotation step size from 1 to 2. (It needs to be configurable.)
    [SpiralPattern.cpp]
2018-07-13 Modified spring pattern to work around problem of stretch not working.
2018-07-13 Added debug messages for powf issue.
    [SpiralPattern.cpp]
2018-07-17 This is the config that ran the last two nights at Element 11. Bells thresholds set higher due to sound from that really loud sound camp. Set spring parameters for stretch, but it may not have worked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
2018-09-27 Added fourth color so that red and blue can be combined. Separated maximum tilt into maximum pitch and maximum roll degrees.
2018-09-30 Disabled watchdog because it doesn't work correctly on Pro Mini boards with the default bootloader (it causes an infinit boot loop that requires power cycle to exit). Added re-init of MPU when good d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
    [Widget_Rainstick.ino]
2018-11-02 Added indicator LED for IMU in normal mode. Hopefully fixed the problem of getting stuck receiving only zero data forever when going to sleep fails (for a yet undetermined reason).
    [Widget_Rainstick.ino]
2018-11-03 Added acceleration and linear acceleration. Removed average min and max sound from averages and transmitted data set. Started working towards genericizing for all IMU or IMU+sound widgets."
2018-11-03 Removed usage of watchdog for detecting MPU-6050 failure. (That is done by detecting all-zero data that persists for too long.) Added periodic wakeup to transmit a zero-data packet every 8-2040 secon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
    [Widget_Rainstick.ino]
2018-11-03 Mic power now turned off in standby mode. Set config for actual Rainstick.
2018-11-04 Created Widget_MPU6050 for the IMU+sound type of widgets that use the MPU-6050.
2018-11-06 Added activity based on movement. Added temperature. Made sound support conditional on ENABLE_SOUND.
2018-11-06 Made MPU-6050 motion detection parameters part of configuration. Increased MA length for Tilt widgets to make activity detection more sensitive and prevent movement that is too flashy.
    [Widget_MPU6050.ino]
2018-11-06 Removed local sensor support.
2018-11-06 Swapped pitch and roll for Tilt1 for testing. (Eventually need to handle the values from the tilt widgets appropriately.)
    [OctoFlashy.ino]
2018-11-12 Removed common radio configuration. Each widget now has complete control over the radio configuration. This will allow us to use multiple channels, different power levels, etc.
2018-11-12 Removed unneeded IMU values. Cleaned up handling of cheap-o "PAR" lamp and unused dimmer fourth channel. Tilt-1 now controls lamp intensity while Tilt-2 controls color. Moved IBG Tilt-x wigdets to ch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
    [OctoFlashy.ino]
2018-11-12 Fixed swap of pitch and roll for Tilt-Test (break was missing).
    [OctoFlashy.ino]
2018-11-13 Changed for IBG: NUM_LAMPS from 9 to 5, LAMP_MIN_INTENSITY from 24 to 128, disabled ENABLE_COLOR_WRAPAROUND, enabled SKIP_DIMMER_FOURTH_CHANNEL. Fixed skip of dimmer fourth channel.
    [OctoFlashy.ino]
2018-11-15 Moved radio configuration parameters to individual widgets. This will allow us to customize things like acks and tx power on a widget-by-widget basis.
2018-11-15 Updated local simulator config to be compatible with Rainstick and Pump.
2018-11-16 Moved obsolete patternGenerator configs to old directory because it is too much trouble to make them current, and we really don't need them (except for reference) anyway.
2018-11-16 Created simulator.json from Element11_2018_wigetSet1.json and localSimulator.json. Made sure all widget and pattern configurations are valid and working. Added some colors to stringToHsvPixel and str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
    [PumpWidget.h, RainstickWidget.cpp, SchroedersPlaythingWidget.cpp, SpinnahWidget.cpp, illumiconePixelUtility.cpp, pixeltypes.h]
2018-11-17 Fixed Tilt_x DATA_RATE (should be 250KBPS for max range). Further staggered the tx intervals across the three Tilt_x widgets.
    [Widget_MPU6050.ino]
2018-11-22 Cleaned up handling of ssh private and public keys. Adding ssh configs for the relay server and ic2-widpatcon2.
2018-12-01 Added replacement for LEDscape.
2018-12-02 Added emitIntervalUseMeasmtAbsValue to accommodate gyro values from Baton.
2018-12-02 Fixed widget id in constructor.
    [BatonWidget.cpp]
2018-12-05 Changed dry-out on time from 07:00 to 08:00. Adjusted Pump cutoff and thresholds for aggressive use in very cold weather.
2018-12-05 Fixed handling of temperatures below 0 degrees C.
2018-12-19 Shortened payload log messages.
    [widgetRcvr.cpp]
2018-12-19 Implemented standby mode. It probably won't reduce power consumption much because the Hall effect sensors are rated to draw 5 mA each for 40 mA total, which is approximately 4 times as much as the pr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
    [Widget_FourPlay.ino]
2018-12-19 Shortened the payload message logged by patternController.
    [Widget.cpp]
2018-12-19 Shortened log messages even more.
    [widgetRcvr.cpp]
2018-12-20 Changed Pump pressurization color to orange, opacity to 60, and flash threshold to 600. Swapped FourPlay-4-2 green and width wheels because one of the sensors on the former green wheel seems like it 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
2018-12-22 Turned autoAck on because most widgets are still expecting an ack due to an error in the radio init function.
    [widgetRcvr.cpp]
2018-12-22 Changed pump low pressure cutoff from 300 to 200 because Pump appears to depressurize faster now that the weather has warmed up.
2018-12-22 Fixed problem of requesting acks when WANT_ACK is false. Changed Rainstick movement timeout from 10 to 20 seconds and active TX interval from 200 to 93 ms.
    [Widget_MPU6050.ino]
2019-01-09 Added final fix-it items and event schedule. Fine-tuned decay for Bells gold sparkle. Re-enabled red and green sparkles because they look nice (they're triggered by the only remaining bell because th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
2019-01-15 Added 4StringDriver board v1.0.
    [4StringDriver.brd, 4StringDriver.sch]
2019-01-15 Updated 4StringDriver to v1.0a.
    [4StringDriver.brd, 4StringDriver.sch]
2019-01-15 Updated 4StringDriver to v1.1 (the latest). This version was fab'd by OSH Park.
    [4StringDriver.brd]
2019-01-15 Added WidgetArduinoProMiniBreakout v1.0. However, the .brd and .sch files are probably for v1.0a.
    [WidgetArduinoProMiniBreakout.brd, WidgetArduinoProMiniBreakout.sch]
2019-01-21 Created Log class. Not implemented elsewhere yet, so compiles will fail.
    [Log.cpp, Log.h, SpiralPattern.cpp, Widget.cpp, illumiconeUtility.cpp, patternController.cpp, widgetFactory.cpp]
2019-01-21 Replaced logging functions with a new Log class and global logger object. Log has the capability of writing to the system log.
    [AnnoyingFlashingPattern.cpp, BatonWidget.cpp, BellsWidget.cpp, BoogieBoardWidget.cpp, ConfigReader.cpp, ContortOMaticWidget.cpp, EyeWidget.cpp, FillAndBurstPattern.cpp]
2019-01-21 Added missing #include of Log.h.
    [stringTester.cpp]
2019-01-21 Removed debug prints.
2019-01-29 Divided config into common and instance-specific sections. Moved most of the config accessors out of ConfigReader (still some left to do). Builds and sort of works. Runs into a problem with a vector 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
    [ConfigReader.cpp, ConfigReader.h, Pattern.cpp, jsonTester.cpp, patternController.cpp, unitTests.cpp]
2019-01-30 Widget and Pattern classes and derived classes now use Json objects for config and no longer use ConfigReader (except for static functions to extract values from a Json object).
    [AnnoyingFlashingPattern.cpp, AnnoyingFlashingPattern.h, ConfigReader.cpp, ConfigReader.h, FillAndBurstPattern.cpp, FillAndBurstPattern.h, HorizontalStripePattern.cpp, HorizontalStripePattern.h]
2019-02-05 Fixed ack request problem.
    [Widget_Esplora.ino]
2019-02-14 Fixed a couple of really stupid bugs that caused log rotation to happen immediately. Debug prints need to be removed.
    [Log.cpp, illumiconeUtility.cpp, logTest.cpp]
2019-02-15 Removed debug prints. Log rotation works.
2019-02-16 Multiple, successive zero-length packet error messages are now consolidated into two messages, with the second indicating how many such packets were received. This should keep the widgetRcvr log file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
    [widgetRcvr.cpp]
2019-02-25 Adding widgetPlayback.py. Reads widget data logs and prints what it would send, with correct timing (i.e., delays between messages). Doesn't actually send data to patternController yet.
2019-02-25 Added error code and description for wordexp failure when resolving log file path.
    [Log.cpp]
2019-02-25 Commented out message prints. Progress print now includes last timestamp and is printed every 1000 lines processed.
2019-02-25 Adjusted spring raw measurement ranges for compatibility with MPU6050 widget firmware, which multiplies the degrees by 10 instead of 100.
2019-02-25 Changed BoogieBoard max. measurements to 13 for compatibility with MPU6050 firmware. Temporarily hardcoded config values in stringTester because I needed it for the erection. Enabled debug prints in 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
2019-02-25 Added schedule for shutdown, quiescent, and dryout. Fixed angle values in spring config for compatibility with MPU6050 widget firmware. Probably other changes, too.
2019-02-27 Fixed problem of sending false, high pressure readings when inactive due to sample count overflowing.
    [Widget_Plunger.ino]
2019-02-27 Widget set 2 has pump with the orange color.
2019-02-27 Now prints progress update for every 100 (instead of 1000) lines processed. Changed patternController IP addres for ic-widpatcon at JUMP.
2019-03-01 Made spring rotation and color change better.
2019-03-02 Fixed bug of pixel index going past array bounds when turning on upper adjacent pixel when spring is stretched.
    [SpiralPattern.cpp]
2019-03-02 Fine tuned spring pattern for actual values coming from BoogieBoard. Stretch works nicely now, as does rotation.
2019-03-03 Fixed problem of pressurization pattern remaining on the cone forever when Pump abruptly stops sending data (for reasons yet unknown) by checking the active state of the widget while in pressurizatio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
    [FillAndBurstPattern.cpp]
2019-03-03 Fixed problem of printing advancing messages when delay time is zero.
2019-03-06 Fixed problem of noise from Pump causing cone to never go inactive.
    [FillAndBurstPattern.cpp]
2019-04-29 Updated jsonTester for compatibility with current JSON config file format.
2019-05-28 widgetRcvr now sends position+velocity data to patternController for stest data received from widgets other than widget id 0.
2019-05-29 ConfigReader::loadConfiguration is now what should be called to read a configuration file. It calls readConfigurationFile. This change is in preparation for reading #include config files. Tested with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
2019-06-01 Fixed return value in loadConfiguration.
    [ConfigReader.cpp]
2019-06-05 Added resolveObjectIncludes. Not complete. Probably won't compile.
    [ConfigReader.cpp]
2019-06-05 Finished resolveObjectIncludes. Not compiled yet.
    [ConfigReader.cpp, ConfigReader.h]
2019-06-05 Fixed some compilation errors. Still doesn't compile. Need to figure another way of dealing with object_items returning a const map.
    [ConfigReader.cpp, ConfigReader.h]
2019-06-09 Added saftey check to prevent buffer overrun when getting config file symlink target.
    [patternController.cpp]
2019-06-23 Fixed pump auto-inactive regression. Added some state-change log messages.
    [FillAndBurstPattern.cpp]
2019-06-23 Added some pump test data extracted from Illumibrate 2019 activity.
2019-06-24 Added timestamps to printed messages to aid correlation with patternController's log.
2019-06-26 Buttons on Esplora now control widget id for FourPlay emulation.
2019-06-28 Added message indicating being forced inactive due to pressure below threshold.
2019-06-28 Commented out code that makes the spiral wider so that the spring looks ok on Mini-Cone.
2019-06-28 Adjusted patterns for Mini-Cone. Added spring pattern for Mini-Cone.
2019-07-18 Added multiple stripes. Also started changing all rgb stuff to arrays. Won't build.
    [RgbVerticalPattern.cpp, RgbVerticalPattern.h]
2019-07-20 Virtual pixels are now truly that. Removed vpixelArray. A physical string is now updated directly when the virtual string being updated corresponds to the physical string. Otherwise, update of the vi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
    [RgbVerticalPattern.cpp, RgbVerticalPattern.h]
2019-07-26 Fixed jerky and jumpy movement.
    [RgbStripePattern.cpp]
2019-07-29 Added workaround for apparent wordexp bug on macOS.
    [Log.cpp]
2019-08-06 Updated for Raspberry Pi 4.
2019-08-08 Added vibration sensor interrupt support. Only sends interrupt count in place of temperature for now. Only tested with BoogieBoard configuration.
    [Widget_MPU6050.ino]
2019-08-09 Set MPU6050 interrupt pin as input. BoogieBoard config changes for debugging.
2019-08-10 Added support for wakeup from vibration sensor. Not built, not tested yet.
    [Widget_MPU6050.ino]
2019-08-11 Vibration sensor wakeup now working for BoogieBoard.
    [Widget_MPU6050.ino]
2019-08-11 Added debug pin A to help with figuring out why BoogieBoard's sensor freezes up sometimes (but not when debug prints are used).
2019-08-11 Fixed debug pin A by assigning it to D16 (A2) because D13 (LED_BUILTIN) is used by the nRF24L01+ module. Assertion of the pin is now during the processing of motion measurements.
    [Widget_MPU6050.ino]
2019-08-11 Moved assertion of debug pin A around reading temperature. Commented out calculations of degress C and F.
2019-08-25 Friday night changes: Created first config for Burning Man 2019. Created include config for rotating logs at noon. Saturday night tweaks: Cloned FourPlay-4-2's trippy rings-and-stripes pattern for Fo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
2019-08-26 Turned on acks. Added debug prints.
2019-08-26 Added simple support for the illumination LED: Turn it on when starting up, turn it off when the photosensor value is above a certain threshold (currently set for my headlamp fairly close, I think), 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
2019-08-27 Disabled debug print.
2019-08-29 Added kludges in an attempt to alleviate the problem of non-transparent black blocks left behind by the Midi indicator regions pattern.
    [MidiActivatedRegionsPattern.cpp]
2019-08-31 The green wheel on FourPlay-4-2 stopped working. (Ok, like some dude said, it jiggles the green stripes.) Because I'm too goddamn worn out to take FourPlay-4-3 out here, I assigned channel 3 to green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
2019-09-25 Added Raspberry Pi development system setup instructions document. Still a work in progress.
2019-09-29 Started adding Arduino development setup.
2019-10-01 Added runLoop now supports multiple radios via pollRadio. Fixed various compilation errors.
    [widgetRcvr.cpp]
2019-10-01 Fixed radio config extraction. Added debug messages to pin down SPI init problem.
    [widgetRcvr.cpp]
2019-10-24 Changed stats print interval from 1 to 5 seconds.
2019-10-24 Added extensionCableLengths.py, a simple program to aid with planning the extension cable construction for the IBG entrance tunnel POC.
2019-10-25 Added test data from wheel+baton spin test at Xu on 24 Oct. 2019 Illumicone build night.
2019-11-03 Added Arduino library installation.
2019-11-03 Fixed up some paths, cleaned up the steps for installing Arduino libraries.
2019-11-09 Made debug print actually work. (Enabling debug print disables DMX.) Hacked, in a most ugly way, to treat Baton (widget 12) as Tilt-2 (widget 2). Made compatible with current Illumicone widget comms 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
2019-11-12 Modified to print CPU temperature in same format as readDS18B20Temperature does (timestamp, degrees C, degrees F).
2019-11-18 Modified widget message header to accommodate 32 widgets but only 4 channels per widget. Removed support for ContortOMatic and TriObelisk. Renumbered some widgets. Added 8 flower and 6 baton widgets.
2019-11-18 Added FlowerWidget class.
2019-11-18 Renamed baton to baton1. Added flower1.
2019-11-18 Added redRing_Flower1 pattern for basic testing of the first flower widget.
2019-11-18 Added six baton widgets and eight flower widgets.
2019-11-24 Created a quick-and-dirty cable tester to make sure we didn't damage the new data cables with excess heat while applying heat-shrink tubing to the bundles.
    [CableTester.ino]
2019-11-25 Added Flower1 through Flower8 and Baton1 through Baton6. Removed Baton.
2019-11-25 New flower patterns.
2019-11-25 Flower now sends only ypr, gyro, and temperature data.
2019-11-25 Yaw now normalized to 0-360 degrees. Gyro rotational speed (direction agnostic) now used for determining if the IMU is active. This allows the moving average length to be 1 (i.e., no averaging). Set 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
    [Widget_MPU6050.ino]
2019-11-25 For widgets sending measurement vectors, both position and velocity are set to the value corresponding to the channel. (Previously, only position was.)
2019-11-25 Density now uses velocity instead of position.
2019-11-26 Flower2 assigned to ringsAndStripes, Flower3 assigned to multicolorSparkle.
2019-11-26 Removed unneeded code. Radio configured for auto ack. Updated widget header layout. Fixed up some stuff. Still haven't tried compiling it.
    [GardenSpinner.ino]
2019-11-26 Disabled simulated measurements. Works ok with a flower widget.
2019-11-27 Added mapping for the rose garden at Winter Garden aGlow 2019. Turned off gamma correction because the LED Christmas light strings have a very different brightness curve. Changed lamp min intensity f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
    [GardenSpinner.ino]
2019-11-28 Added vibration sensor for flowers 3-8.
    [Widget_MPU6050.ino]
2019-11-30 Created LowPowerEval for evaluating power usage of the Pololu A-Start 328PB in comparison to the Arduino Pro Mini.
2019-12-01 Initial evaluation of VL53L1X Time-of-Flight Distance Sensor at JUMP Maker Meetup in early November 2019.
2019-12-01 Added note about RPi 4 hardware bug causing USB-C cable incompatibility. Added additional required Arduino libraries.
2019-12-01 Moved OctoFlashy to Arduino.
2019-12-01 Moved GardenSpinner to Arduino.
2019-12-02 Made LED 1 conditional.
2019-12-02 Fixed bug that caused zero acceleration values. Baton2 has a vibration sensor. Added optional skip of verifying MPU-6050 id (I2C address) because the goddamn counterfeit shit modules from Amaxon don'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
    [Widget_MPU6050.ino]
2019-12-05 Reorganized MPU-6050 initialization. Communication (id) check now done first. Init function returns false if any phase of init fails.
    [Widget_MPU6050.ino]
2019-12-07 Prints sensor data only if valid reading received.
2019-12-08 Added magenta/aqua sparkle pattern on Flower4 (Reiley's pretty, daisyish, rainbow-colored one).
2019-12-08 Separated rings and strips on Flower2 into rings on Flower2 and stripes on Flower5.
2019-12-08 Moved sparkles to Flower5 and stripes to Flower4 because it appears that Flower5 has a shitty radio and doesn't send a good data stream.
2019-12-09 Tested ok. Changed DMX update interval from 33 ms to 10 ms, thinking that the shorter interval would smooth out some movement around the pink bush on channel 5 or so. Turns out my laptop sitting on t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
    [GardenSpinner.ino]
2019-12-09 Added stripes on Flower6 because I swapped that controller module for Flower5, which has a crappy radio, and I want stripes on that flower (Katya's) to go with the rings on Katya's other flower (Flow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
2019-12-09 Stripes now on Flower6 (a Katya flower), and magenta/aqua sparkles back on Flower4 (Reiley's rainbow daisyish flower).
2019-12-10 Removed measurement averaging. Widget is active when TOF sensor gets a good reading.
2019-12-14 Added Lidar1 widget and LidarWidget class. Added white sparkle pattern on Lidar1. Removed Flower8.
2019-12-14 Removed the second radio from the widgetRcvr configuration. Added white sparkle on Lidar1.
2019-12-16 Added white sparkle on Lidar1.
2019-12-17 Gets the DS18820 device subdirectory name in /sys/bus/w1/devices rather than using a hardcoded value.
2019-12-17 Added entry for reading the CPU temperature on an RPi 4.
2019-12-17 Added a step to enable the crontab entry for reading and logging the CPU temperature. Did some other, related cleanup.
2019-12-17 Removed Flower8.
2019-12-22 Add program that plots RPi 4 CPU temperature over time to see if the temperature increases when the cone is active (it does).
2019-12-22 Moved plotting to a separate function. y-axis label uses LaTeX for degree symbol.
2020-01-18 Added widget firmware for the test box with 8 switches, 3 pots, a button, and an RGB LED. Its primary purpose is to simulate the Electric Garden theremin for Illumibrate 2020. It also might come in h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
2020-01-18 Switch value now sent in element 0 and pot values sent in elements 1-3.
2020-01-24 Created a rings-and-stripes pattern on Flower7 for Mini-Cone.
2020-02-17 SwitchPotBox now transmits on channel 80 for the Electric Garden.
2020-02-29 Fixed name of hsvStr parameter.
    [ConfigReader.cpp, ConfigReader.h]
2020-02-29 Both horizontal and vertical stripes work. Dynamically variable width works, but the sideband width can exceed the configured maximum. That bug also exists in RgbStripePattern. Variable hue and hue g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
    [StripePattern.cpp]
2020-02-29 Added config for rings on Flower3 and Flower4.
2020-02-29 Added simulation of Z gyro.
2020-02-29 Added spring pattern on flowers 5 and 6. Changed blending from rgbBlend to rgbAdd.
2020-02-29 Added RattleWidget, which, at this point, is just a clone of BatonWidget and has exactly the same behavior. Added Rattle1 and Rattle2. Removed Baton3-Baton6 because we're not going to make more becau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
    [WidgetId.cpp, WidgetId.h, widgetFactory.cpp]
2020-03-01 Swapped Flower3 and Flower6. 3 is now assigned to the spring rotation, and 6 is now assigned to the rings. Changed the number of vertical stripes from 12 to 4.
2020-03-02 Changed data rate to 250 kbps and power level to low.
2020-03-02 Customized Flower7 for Fluf Haven at Illumibrate 2020, where it will (hopefully, if we can figure out the damn glitches in the theremin) be used to select the pattern.
    [Widget_MPU6050.ino]
2020-03-02 Removed batons 3 through 6 and added rattles 1 and 2. Not compiled or tested yet.
    [Widget_MPU6050.ino]
2020-03-04 Fixed minimum foldback percent.
    [StripePattern.cpp]
2020-03-04 Dynamic hue feature working. Vertical stripes are now old style (no virtual pixels). Spring compresses less so that it doesn't dominate the bottom of the cone so much.
2020-03-05 Updated to match spring_Flower5_Flower3_Rattle1.
2020-03-05 Rattle1 now has a vibration sensor.
    [Widget_MPU6050.ino]
2020-11-24 widgetPlayback.py now sends mvec measurements as both position and velocity--same as widgetRcvr. (Was sending zero velocity.)
2020-11-24 Added operating state log messages to patternController.
    Operating state is logged only when it changes. This will stop pollution of the
    log with those diarrheal quiescent and shutdown period messages. And, we'll be
    able to easily track when the cone goes inactive, idle, and active.
2021-11-05 Fixed TX_RETRY_DELAY_MULTIPLIER comment. Did modifications for testing an A-Star 328PB.
    [Widget_StressTest.ino]
2021-11-05 Renamed Widget_Mike to Widget_MSGEQ7 in case we make other sound-reactive widgets besides the Mikes.
2021-11-06 Added radio number field to testData/rainstick.log for compatibility with current widgetPlayback.py.
2021-11-06 Updated Arduino version.
2021-11-22 Simulated measurements now also placed in velocity (not just position).
2021-11-22 Added a top view of the 4StringDriver board to help with identifying string data output connectors.
2021-11-23 Changed power level from MAX to HIGH and data rate from 1MBPS to 250KBPS, resulting in much better performance.
2021-11-23 Added config for widgetRcvr3, but it turns out we don't need it because fixing up the radio config made the flower widgets work great.
2021-11-23 Added the retry delay multipliers for the flower widgets.
2021-11-23 Changed the flowers to use acks, 250 mbps, and high power (instead of max), which tremendously helped with throughput.
2021-12-12 Added single stripe with color controlled by rotational velocity for Flower7.
2021-12-24 Added a second stripe to stripes on Flower7.
2021-12-24 Combined Baton and Rattle configurations into BatRat.
    [WidgetId.h, Widget_MPU6050.ino]
2021-12-25 Repurposed Flower4 for blue rain.
2022-01-01 Added hard reset of MPU6050 by power cycling it. Needs some cleanup.
    [Widget_MPU6050.ino]
2022-01-01 Merged current pattern set 3 into set 4.
2022-01-01 Switched to pattern set 4 for a final-night test of a MIke widget prototype (which was successful).
2022-01-14 Updated Pump's radio config to match current (250 kbps, acks wanted, high power).
2022-01-16 Updated radio config. LED now shows blue for inactive, green for active, and red for TX error.
    [Widget_SwitchPotBox.ino]
2022-01-16 Added steps for installing the Pololu boards package, the Pololu USB AVR Programmer utilities, and the MSGEQ7 library.
2022-01-17 Changed data rate to 250 kbps and power to high.
2022-01-24 Renamed SwitchPotBox to PotBox.
2022-07-12 Updated wireless configuration data rate and power for compatibility with current cone configuration.
2022-08-21 Modified BatRat3 to use the IMU power pin and watchdog reset, just like BatRat2. Modified BoogieBoard to use the same controller board as BatRat2 and BatRat3.
    [Widget_MPU6050.ino]
2023-02-17 Modified schedule on 1 Sept. on playa: The sun went behind the mountain at 19:08 PDT.
2023-02-17 Fixed UDP typo in send error message.
    [widgetRcvr.cpp]
2023-02-21 Fixed UDP typo in OPC bytes-sent error message.
    [patternController.cpp]
2023-02-24 Renamed Baton and Rattle widgets to BatRat. Added batrat5.
    [BatRatWidget.cpp, BatRatWidget.h, WidgetId.cpp, WidgetId.h, Widget_MPU6050.ino, widgetFactory.cpp]
2023-02-24 Added ENABLE_SYSTEM_RESET_WATCHDOG and IMU_POWER_PIN for all the BatRats.
2023-02-25 Made the 25 Feb. setup override period start eariler because the daytime dryout mode uses about 490 watts, which is a helluva load when combined with the mini-split heater at the end of an extension 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
2023-02-26 Updated data rate and RF power level of Esplora widget.
2023-02-26 Added indications of Flower1 and Flower4 being located in the vestibule. Removed PotBox/FourPlay42 hack.
2023-02-27 Test pattern illumination area now alternates between odd and even pixels.
    As an aid for identifying strings that intermittenly don't respond to new
    data but are illuminated nevertheless, we now alternate between the odd
    and even illumination pixels with each frame.
2023-03-03 Added pattern for 4 horizontal stripes on Flower7 to complement the vertical stripes on Flower7.
2023-03-03 Added horizontal stripes on Flower6. Renamed Flower7 stripes to vertical.
2023-03-03 Added spinner blocks on Flower3. Might work.
2023-06-14 Updated Eye radio config (250 Kbps, low power, ch. 97).
2023-06-25 Added spring pattern for Flower 3.
2024-06-07 Updated FourPlay radio config to 256 kbps and low power.
2024-08-12 Changed RF power from high to low in widgetRadio_ch97 config.
2025-05-30 Added RGB LED to Widget_StressTest.
2025-06-04 Fixed ScotchHop TX failure (red) LED flash when in standby mode. Step ID now read from jumpers.
    [Widget_ScotchHop.ino]
2025-06-17 Added scotchHop4Pride config. Added switch id to IndicatorRegion. Added ScotchHopWidget and MultiSwitchActivatedRegionsPattern classes. Shit compiles, but who knows it it works yet.
2025-06-20 Removed debug print from ScotchHopWidget measurement simulation.
