skipzone/Illumicone/(notices)

Notices in the files:
include/pixelset.h:
Illumicone is free software: you can redistribute it and/or modify
it under the terms of the GNU General Public License as published by
the Free Software Foundation, either version 3 of the License, or
(at your option) any later version.
parts and their libraries:
SparkFun-Aesthetics: Licensing: Creative Commons ShareAlike 4.0 International - https://creativecommons.org/licenses/by-sa/4.0
con-headers-jp: Copyright (C) 2008, Bob Starr
